kgoba/zinoo/eagle/relay_shield/bom.txt

1629032	6	RY211005R	SPDT Relay 5V
1564671	1	LP2985IM5-5.0/NOPB LDO 5V/150mA
1703369	1	NCP5501DT50G 	LDO 5V/500mA
9227911	4	C1206C225K4RACTU 	2.2uF 16V
1081192	4	BAT54C		Double diode (ACA)
1332086	1	MCP23008-E/SO	I/O Expander, 8 bit
2769437	1	ULN2003ADRG3		Transistor array
2527545	1	CTBP3051/2		Terminal block 2W
2527546	6	CTBP3051/3		Terminal block 3W
