kgoba/zinoo/eagle/tracker/production/tracker-25mm-full.ods

Stock | Qty | Value | Description | Farnell ON | TME ON | Arrow | Multiplicity | Qty to order | Price | Amount | Farnell ON | TME ON
100 | 1 | BATT_PYRO | 2 pin male header |  |  |  | 1 | 0 |  | 0
100 | 1 | BATT | 2 pin male header |  |  |  | 1 | 0 |  | 0
 | 1 | UART | 3 pin male header |  | ZL265-3SG (https://www.tme.eu/en/details/zl265-3sg/pin-headers/connfly/ds1026-01-1_3s8bv/) |  | 10 | 10 | 0.06198 | 0.6198 |  | ZL265-3SG (https://www.tme.eu/en/details/zl265-3sg/pin-headers/connfly/ds1026-01-1_3s8bv/)
 | 1 | PROG | 4 pin male header |  | ZL265-4SG (https://www.tme.eu/en/details/zl265-4sg/pin-headers/connfly/ds1026-01-1_4s8bv/) |  | 10 | 10 | 0.08224 | 0.8224 |  | ZL265-4SG (https://www.tme.eu/en/details/zl265-4sg/pin-headers/connfly/ds1026-01-1_4s8bv/)
 | 1 | F/TMB | BUZZER Source: Buerklin |  | LD-BZEG-1203 (https://www.tme.eu/en/details/ld-bzeg-1203/electromagnetic-sounders-with-generator/loudity/) |  | 3 | 3 | 0.4781 | 1.4343 |  | LD-BZEG-1203 (https://www.tme.eu/en/details/ld-bzeg-1203/electromagnetic-sounders-with-generator/loudity/)
30 | 2 |  | Ferrite Bead 0805 | 1838838 (http://lv.farnell.com/fair-rite/2508056017y2/ferrite-bead-0-1ohm-2a-0805/dp/1838838) |  | 2508056017Y2 (https://www.arrow.com/en/products/2508056017y2/fair-rite-products) | 1 | 0 | 0.0571 | 0 | 1838838 (http://lv.farnell.com/fair-rite/2508056017y2/ferrite-bead-0-1ohm-2a-0805/dp/1838838)
 | 4 | PMV30UN2 | Generic N-MOSFET | 2469652 (http://lv.farnell.com/nexperia/pmv30un2/mosfet-n-ch-20v-5-4a-sot-23-3/dp/2469652?st=pmv30un2) |  | IRLML6244TRPBF (https://www.arrow.com/en/products/irlml6244trpbf/infineon-technologies-ag) | 5 | 5 | 0.194 | 0.97 | 2469652 (http://lv.farnell.com/nexperia/pmv30un2/mosfet-n-ch-20v-5-4a-sot-23-3/dp/2469652?st=pmv30un2)
100 | 13 | 100k | Generic resistor |  |  |  | 1 | 0 |  | 0
100 | 7 | 1k | Generic resistor |  |  |  | 1 | 0 |  | 0
100 | 3 | 27 | Generic resistor |  |  |  | 1 | 0 |  | 0
100 | 2 | 10k | Generic resistor |  |  |  | 1 | 0 |  | 0
100 | 1 | 3.3k | Generic resistor |  |  |  | 1 | 0 |  | 0
100 | 1 | *2.0k | Generic resistor |  |  |  | 1 | 0 |  | 0
 | 1 | MPL3115A2 | I2C precision pressure sensor with altimetry, 20 to 110kPa | 2009084 (http://lv.farnell.com/nxp/mpl3115a2/pressure-sensor-20-110kpa-8lga/dp/2009084?st=mpl3115) |  | MPL3115A2 (https://www.arrow.com/en/products/mpl3115a2/nxp-semiconductors) | 1 | 1 | 2.66 | 2.66 | 2009084 (http://lv.farnell.com/nxp/mpl3115a2/pressure-sensor-20-110kpa-8lga/dp/2009084?st=mpl3115)
 | 1 | LSM6DS33 | iNEMO inertial module: | 2762756 (http://lv.farnell.com/stmicroelectronics/lsm6ds33tr/mems-module-3-axis-gyro-accel/dp/2762756?st=lsm6ds) |  | LSM6DS33TR (https://www.arrow.com/en/products/lsm6ds33tr/stmicroelectronics) | 1 | 1 | 2.8 | 2.8 | 2762756 (http://lv.farnell.com/stmicroelectronics/lsm6ds33tr/mems-module-3-axis-gyro-accel/dp/2762756?st=lsm6ds)
100 | 1 | YELLOW | LEDs |  |  |  | 1 | 0 |  | 0
100 | 1 | RED | LEDs |  |  |  | 1 | 0 |  | 0
100 | 1 | GREEN | LEDs |  |  |  | 1 | 0 |  | 0
 | 1 | MIC5504-3.3/LP3985IM5-3.3 | Linear voltage regulator with enable pin and a bypass capacitor pin: | 2782545 (http://lv.farnell.com/texas-instruments/lp3985im5x-3-3-nopb/ldo-fixed-3-3v-0-15a-sot-23-5/dp/2782545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) |  | LP3985IM5-3.3 (https://www.arrow.com/en/products/lp3985im5-3.3/texas-instruments) | 1 | 1 | 0.473 | 0.473 | 2782545 (http://lv.farnell.com/texas-instruments/lp3985im5x-3-3-nopb/ldo-fixed-3-3v-0-15a-sot-23-5/dp/2782545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)
 | 1 | MIC5504-2.8/LP3985IM5-2.7 | Linear voltage regulator with enable pin and a bypass capacitor pin: | 2510373 (http://lv.farnell.com/microchip/mic5504-2-8ym5-tr/ldo-volt-reg-0-3a-2-8v-sot-23/dp/2510373?st=mic5504-2) |  | MIC5504-2.8YM5-TR (https://www.arrow.com/en/products/mic5504-2.8ym5-tr/microchip-technology) | 1 | 1 | 0.102 | 0.102 | 2510373 (http://lv.farnell.com/microchip/mic5504-2-8ym5-tr/ldo-volt-reg-0-3a-2-8v-sot-23/dp/2510373?st=mic5504-2)
 | 1 | A25L010A | Low Voltage, Serial Flash Memory | 2774949 (http://lv.farnell.com/microchip/sst26vf016b-104i-sn/serial-flash-16mbit-104mhz-soic/dp/2774949) |  | SST26VF016B-104I/SN (https://www.arrow.com/en/products/sst26vf016b-104isn/microchip-technology) | 1 | 1 | 1.18 | 1.18 | 2774949 (http://lv.farnell.com/microchip/sst26vf016b-104i-sn/serial-flash-16mbit-104mhz-soic/dp/2774949)
 | 1 | MAG3110FCR1 | MAGNETOMETER, 3AXIS, I2C, 80HZ,DFN-10 | 2080492 (http://lv.farnell.com/nxp/mag3110fcr1/magnetometer-3axis-i2c-80hz/dp/2080492?st=mag3110) |  | MAG3110FCR1 (https://www.arrow.com/en/products/mag3110fcr1/nxp-semiconductors) | 1 | 1 | 0.81 | 0.81 | 2080492 (http://lv.farnell.com/nxp/mag3110fcr1/magnetometer-3axis-i2c-80hz/dp/2080492?st=mag3110)
 | 1 | H3LIS100DL | MEMS motion sensor: low-power high-g 3-axis digital accelerometer | 2532374 (http://lv.farnell.com/stmicroelectronics/h3lis200dltr/accelerometer-digital-o-p-tflga/dp/2532374?st=h3lis) |  | H3LIS100DLTR (https://www.arrow.com/en/products/h3lis100dltr/stmicroelectronics) | 1 | 1 | 5.06 | 5.06 | 2532374 (http://lv.farnell.com/stmicroelectronics/h3lis200dltr/accelerometer-digital-o-p-tflga/dp/2532374?st=h3lis)
 | 1 | MICROMATCH-8 | MicroMatch 8 THT receptacle top (215079-8) | 1773005 * (http://lv.farnell.com/amp-te-connectivity/215079-8/connector-8way-vertical-1-27/dp/1773005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) | DS1015-04-08R6XT (https://www.tme.eu/en/details/ds1015-04-08r6xt/micro-match-connectors-127mm/connfly/) |  | 10 | 10 | 0.276 | 2.76 | 1773005 (http://lv.farnell.com/amp-te-connectivity/215079-8/connector-8way-vertical-1-27/dp/1773005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) | DS1015-04-08R6XT (https://www.tme.eu/en/details/ds1015-04-08r6xt/micro-match-connectors-127mm/connfly/)
 | 1 | MICROMATCH-8 | MicroMatch 8 IDC wire plug (215083-8) | 1773002 * (http://lv.farnell.com/amp-te-connectivity/215083-8/connector-8way-awg28-1-27/dp/1773002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) | DS1015-01-08R6 (https://www.tme.eu/en/details/ds1015-01-08r6/micro-match-connectors-127mm/connfly/) |  | 1 | 1 | 0.38 | 0.38 | 1773002 (http://lv.farnell.com/amp-te-connectivity/215083-8/connector-8way-awg28-1-27/dp/1773002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) | DS1015-01-08R6 (https://www.tme.eu/en/details/ds1015-01-08r6/micro-match-connectors-127mm/connfly/)
 | 1 | MICROMATCH-8 | MicroMatch 8 IDC paddle board (215570-8) | 149366 * (http://lv.farnell.com/amp-te-connectivity/7-215570-8/connector-paddle-board-8way/dp/149366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) | DS1015-02-08R6 (https://www.tme.eu/en/details/ds1015-02-08r6/micro-match-connectors-127mm/connfly/) |  | 1 | 1 | 0.61 | 0.61 | 149366 (http://lv.farnell.com/amp-te-connectivity/7-215570-8/connector-paddle-board-8way/dp/149366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) | DS1015-02-08R6 (https://www.tme.eu/en/details/ds1015-02-08r6/micro-match-connectors-127mm/connfly/)
 | 0 | MICROMATCH-8 | MicroMatch 8 THT receptacle side (215460-8) | 148751 * (http://lv.farnell.com/amp-te-connectivity/7-215460-8/socket-side-entry-8way/dp/148751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) | DS1015-05-08R6B (https://www.tme.eu/en/details/ds1015-05-08r6b/micro-match-connectors-127mm/connfly/) |  | 1 | 0 | 1.15 | 0 | 148751 (http://lv.farnell.com/amp-te-connectivity/7-215460-8/socket-side-entry-8way/dp/148751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) | DS1015-05-08R6B (https://www.tme.eu/en/details/ds1015-05-08r6b/micro-match-connectors-127mm/connfly/)
 | 0 | MICROMATCH-8 | MicroMatch 8 THT plug top (215464-8) | 3784642 * (http://lv.farnell.com/amp-te-connectivity/7-215464-8/plug-pcb-8way/dp/3784642?st=micromatch%208%20board) | AMP-7-215464-8 (https://www.tme.eu/en/details/amp-7-215464-8/micro-match-connectors-127mm/te-connectivity/7-215464-8/) |  | 1 | 0 | 0.76 | 0 | 3784642 (http://lv.farnell.com/amp-te-connectivity/7-215464-8/plug-pcb-8way/dp/3784642?st=micromatch%208%20board) | AMP-7-215464-8 (https://www.tme.eu/en/details/amp-7-215464-8/micro-match-connectors-127mm/te-connectivity/7-215464-8/)
 | 1 | MCP73831T-2ACI/OT | Miniature Single-Cell, Fully Integrated Li-Ion, Li-Polymer Charge Management Controllers | 1332158 (http://lv.farnell.com/microchip/mcp73831t-2aci-ot/li-ion-li-poly-charge-controller/dp/1332158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) |  | MCP73832T-2ACI/OT (https://www.arrow.com/en/products/mcp73832t-2aciot/microchip-technology) | 1 | 1 | 0.52 | 0.52 | 1332158 (http://lv.farnell.com/microchip/mcp73831t-2aci-ot/li-ion-li-poly-charge-controller/dp/1332158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)
 | 2 | COAX | MMCX STRAIGHT, EDGE MOUNT JACK- 50 OHM |  | RF1205AT0050GT/R (https://www.tme.eu/en/details/rf1205at0050gt_r/mcx-mmcx-connectors/adam-tech/rf12-05a-t-00-50-g/) |  | 1 | 2 | 0.68 | 1.36 |  | RF1205AT0050GT/R (https://www.tme.eu/en/details/rf1205at0050gt_r/mcx-mmcx-connectors/adam-tech/rf12-05a-t-00-50-g/)
 | 2 |  | Plug; MMCX; male; straight; 50Ω; RG174,RG188,RG316; for cable |  | RF12-06-T-02-50-G (https://www.tme.eu/en/details/rf12-06-t-02-50-g/mcx-mmcx-connectors/adam-tech/) |  | 1 | 2 | 0.87 | 1.74 |  | RF12-06-T-02-50-G (https://www.tme.eu/en/details/rf12-06-t-02-50-g/mcx-mmcx-connectors/adam-tech/)
 | 12 | 0.1 µF, 10 V, X7R, 0603 | Non-Polarized capacitor in various packages | 2821272 (http://lv.farnell.com/kemet/c0603c104m8ractu/cap-mlcc-x7r-0-1uf-10v-0603/dp/2821272?st=kemet%201u) |  |  | 10 | 20 | 0.0252 | 0.504 | 2821272 (http://lv.farnell.com/kemet/c0603c104m8ractu/cap-mlcc-x7r-0-1uf-10v-0603/dp/2821272?st=kemet%201u)
 | 6 | 1 µF, 10 V, X7R, 0603 | Non-Polarized capacitor in various packages | 2522396 (http://lv.farnell.com/kemet/c0603c105k8ractu/cap-mlcc-x7r-1uf-10v-0603/dp/2522396?st=kemet%201u) |  |  | 10 | 10 | 0.093 | 0.93 | 2522396 (http://lv.farnell.com/kemet/c0603c105k8ractu/cap-mlcc-x7r-1uf-10v-0603/dp/2522396?st=kemet%201u)
100 | 1 | 10n | Non-Polarized capacitor in various packages |  |  |  | 1 | 0 |  | 0
 | 1 | 10 µF, 6.3 V, X7R, 1206 | Polarized capacitor in various packages | 2522501 (http://lv.farnell.com/kemet/c1206c106k9ractu/cap-mlcc-x7r-10uf-6-3v-1206/dp/2522501?st=kemet%2010uf) |  |  | 5 | 5 | 0.37 | 1.85 | 2522501 (http://lv.farnell.com/kemet/c1206c106k9ractu/cap-mlcc-x7r-10uf-6-3v-1206/dp/2522501?st=kemet%2010uf)
100 | 4 | 3.3k | RESISTOR, European symbol |  |  |  | 1 | 0 |  | 0
 | 1 | HOPE-RFM98W | RFM95/96/97/98(W) - Low Power Long Range Transceiver Module |  | RFM98W-433S2 (https://www.tme.eu/en/details/rfm98w-433s2/rf-communication-modules/hope-microelectronics/) |  | 1 | 1 | 8.86 | 8.86 |  | RFM98W-433S2 (https://www.tme.eu/en/details/rfm98w-433s2/rf-communication-modules/hope-microelectronics/)
10 | 1 | UBLOX-NEO-M8 | U-blox NEO-6 GPS receiver |  |  |  | 1 | 0 |  | 0
 | 0 | UBLOX-MAX-M8 | U-blox NEO-6 GPS receiver |  |  |  | 1 | 0 |  | 0
 | 1 | WM9734TR-ND | USB Type Micro-B Connector | 2614949 (http://lv.farnell.com/molex/105133-0011/micro-usb-2-0-type-b-receptacle/dp/2614949?st=usb%20micro) |  |  | 1 | 1 | 0.6 | 0.6 | 2614949 (http://lv.farnell.com/molex/105133-0011/micro-usb-2-0-type-b-receptacle/dp/2614949?st=usb%20micro)
 | 1 | STM32L063C | STM32 microcontroller | 2503296 (http://lv.farnell.com/stmicroelectronics/stm32l053c8t6tr/mcu-32bit-cortex-m0-32mhz-lqfp/dp/2503296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) |  | STM32L053C8T6 (https://www.arrow.com/en/products/stm32l053c8t6/stmicroelectronics) | 1 | 1 | 2.26 | 2.26 | 2503296 (http://lv.farnell.com/stmicroelectronics/stm32l053c8t6tr/mcu-32bit-cortex-m0-32mhz-lqfp/dp/2503296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)
 |  |  |  |  |  |  |  |  |  | 39.3055
