kgoba/zinoo/eagle/tracker/tracker-25mm-full.dxf

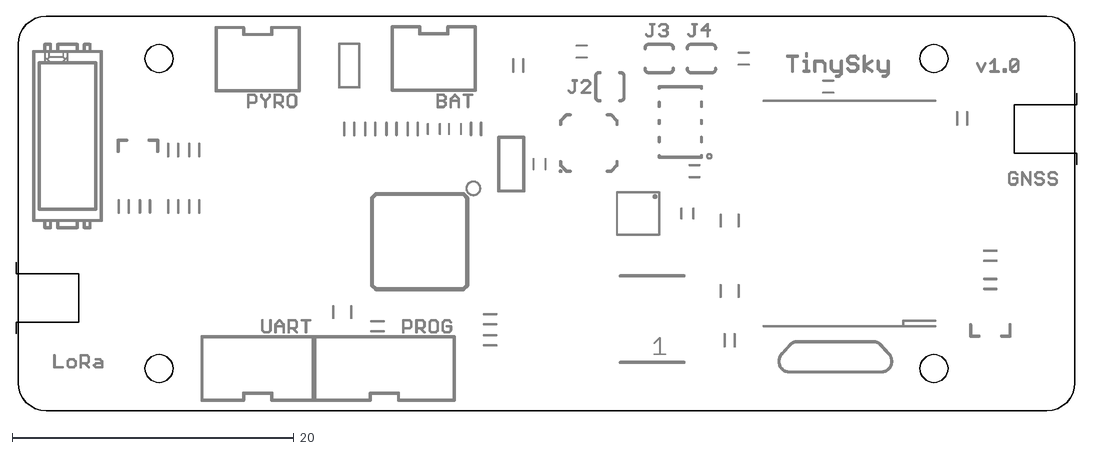
[picture p1: CAD file, 2018-03-26]
eagle/tracker/tracker-25mm-full.dxf
75.2 x 28.0
