kgoba/zinoo/eagle/relay_shield/mosfet-shield-v2.brd

## EAGLE design eagle/relay_shield/mosfet-shield-v2.brd (2018-09-06)

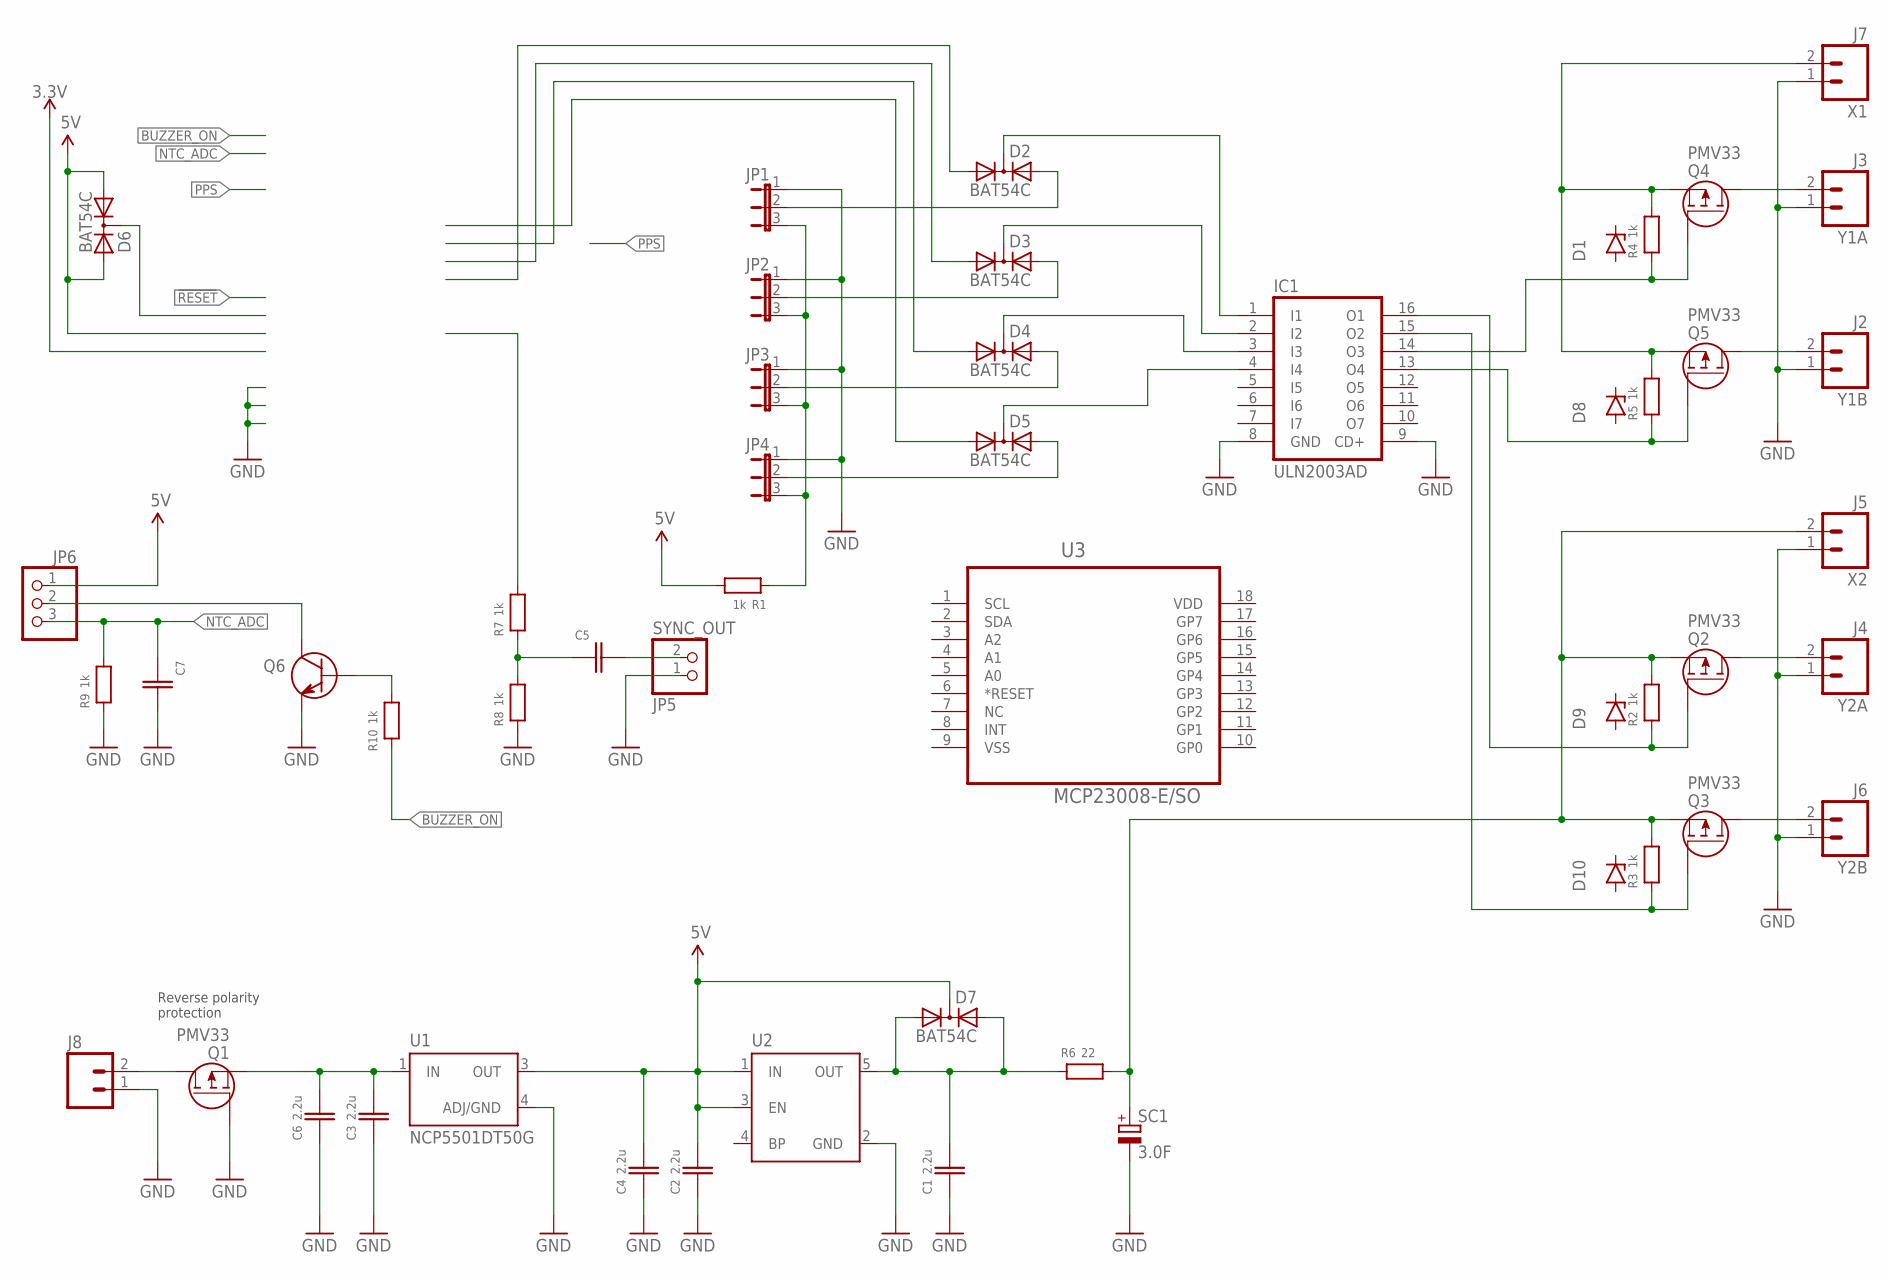
[picture p2: schematic mosfet-shield-v2.sch]

Parts:
C1, C2, C3, C4, C6: 2.2u; C1206
C5, C7: CAPACITOR_NPOL-0603; C603
D1, D8, D9, D10: DIODE-ZENER-SOD80; SOD80
D2, D3, D4, D5, D6, D7: BAT54C; SOT23
IC1: ULN2003AD; SO16
J2: Y1B; SCREWTERMINAL-3.5MM-2
J3: Y1A; SCREWTERMINAL-3.5MM-2
J4: Y2A; SCREWTERMINAL-3.5MM-2
J5: X2; SCREWTERMINAL-3.5MM-2
J6: Y2B; SCREWTERMINAL-3.5MM-2
J7: X1; SCREWTERMINAL-3.5MM-2
J8: M023.5MM; SCREWTERMINAL-3.5MM-2
JP1, JP2, JP3, JP4: JP2E; JP2
JP5: SYNC_OUT; 1X02
JP6: PINHD-1X3; 1X03
Q1, Q2, Q3, Q4, Q5: PMV33; SOT23-3
Q6: BJT-NPN-SOT23-3; SOT23-3
R1, R2, R3, R4, R5, R7, R8, R9, R10: 1k; R0603
R6: 22; R0603
SC1: 3.0F; E3,5-8
U1: NCP5501DT50G; DPAK
U2: VREG-5PIN-SOT23; SOT23-5
U3: MCP23008-E/SO; SOIC127P1030X265-18N

Connections:
5V: C2.2, C4.2, D6.1 (A1), D6.2 (A2), D7.3 (C), JP6.1, R1.2, U1.3 (OUT), U2.1 (IN), U2.3 (EN)
BUZZER_ON: R10.1
GND: C1.1, C2.1, C3.1, C4.1, C6.1, C7.2, IC1.8 (GND), IC1.9 (CD+), J2.1, J3.1, J4.1, J5.1, J6.1, J7.1, J8.1, JP1.1, JP2.1, JP3.1, JP4.1, JP5.1, Q1.1 (G), Q6.2 (E), R8.1, R9.1, SC1.-, U1.4 (ADJ/GND), U2.2 (GND)
unnamed: D2.2 (A2), JP1.2
unnamed: D3.2 (A2), JP2.2
unnamed: J3.2, Q4.3 (D)
unnamed: C3.2, C6.2, Q1.2 (S), U1.1 (IN)
unnamed: IC1.15 (O2), Q3.1 (G), R3.1
unnamed: IC1.16 (O1), Q2.1 (G), R2.1
unnamed: J7.2, Q4.2 (S), Q5.2 (S), R4.2, R5.2
unnamed: J2.2, Q5.3 (D)
unnamed: J4.2, Q2.3 (D)
unnamed: J5.2, Q2.2 (S), Q3.2 (S), R2.2, R3.2, R6.2, SC1.+
unnamed: J6.2, Q3.3 (D)
unnamed: IC1.14 (O3), Q4.1 (G), R4.1
unnamed: IC1.13 (O4), Q5.1 (G), R5.1
unnamed: C1.2, D7.1 (A1), D7.2 (A2), R6.1, U2.5 (OUT)
unnamed: C5.2, JP5.2
unnamed: D2.3 (C), IC1.1 (I1)
unnamed: D3.3 (C), IC1.2 (I2)
unnamed: D4.3 (C), IC1.3 (I3)
unnamed: D5.3 (C), IC1.4 (I4)
unnamed: C5.1, R7.1, R8.2
unnamed: D4.2 (A2), JP3.2
unnamed: D5.2 (A2), JP4.2
unnamed: JP6.2, Q6.3 (C)
unnamed: J8.2, Q1.3 (D)
unnamed: Q6.1 (B), R10.2
unnamed: JP1.3, JP2.3, JP3.3, JP4.3, R1.1
NTC_ADC: C7.1, JP6.3, R9.2
VDD: U3.18 (VDD)

Notes on the sheet:
Reverse polarity protection

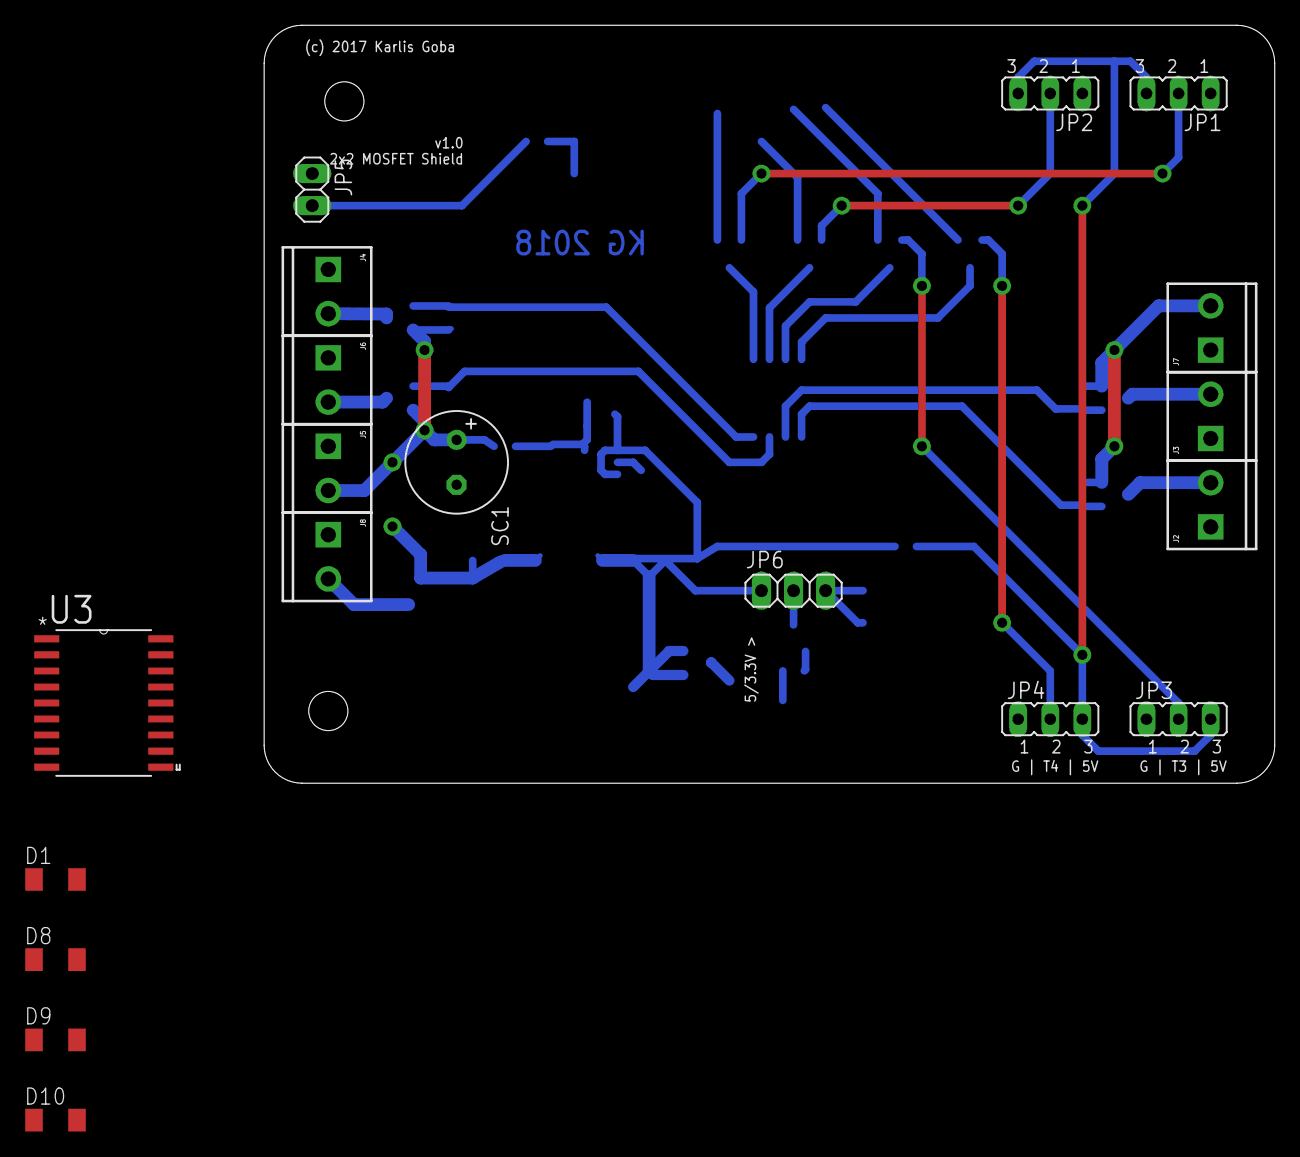
[picture p3: board mosfet-shield-v2.brd from above]

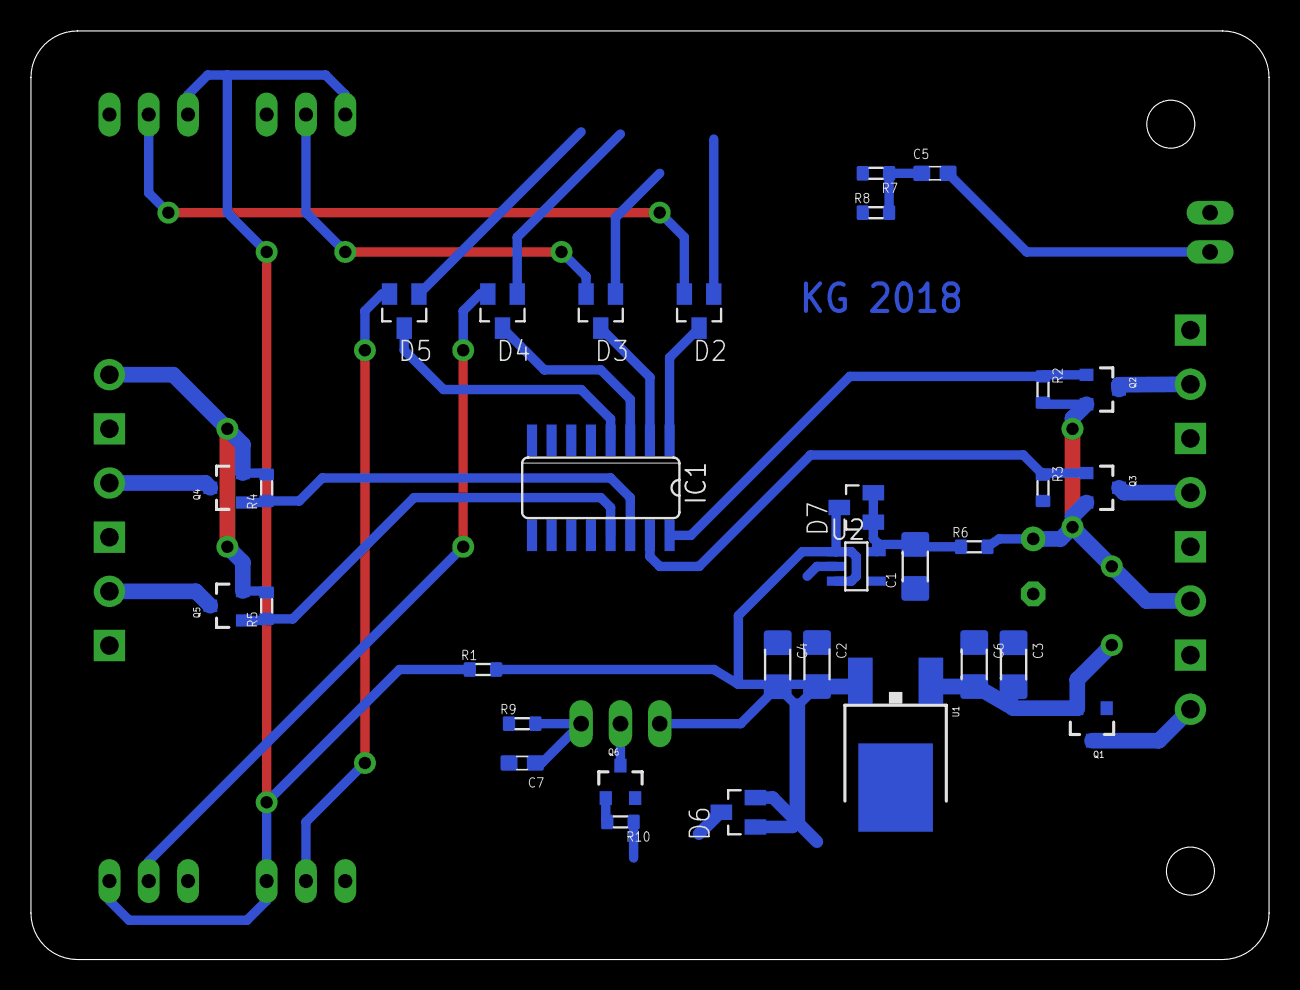
[picture p4: board mosfet-shield-v2.brd from below]

Board: 2 copper layers, 80.0 x 60.0 mm, 51 parts (32 on the bottom side), 29 nets.
