kgoba/zinoo/eagle/misc/thermostat-2layer-v1.brd

## EAGLE design eagle/misc/thermostat-2layer-v1.brd (2018-04-24)

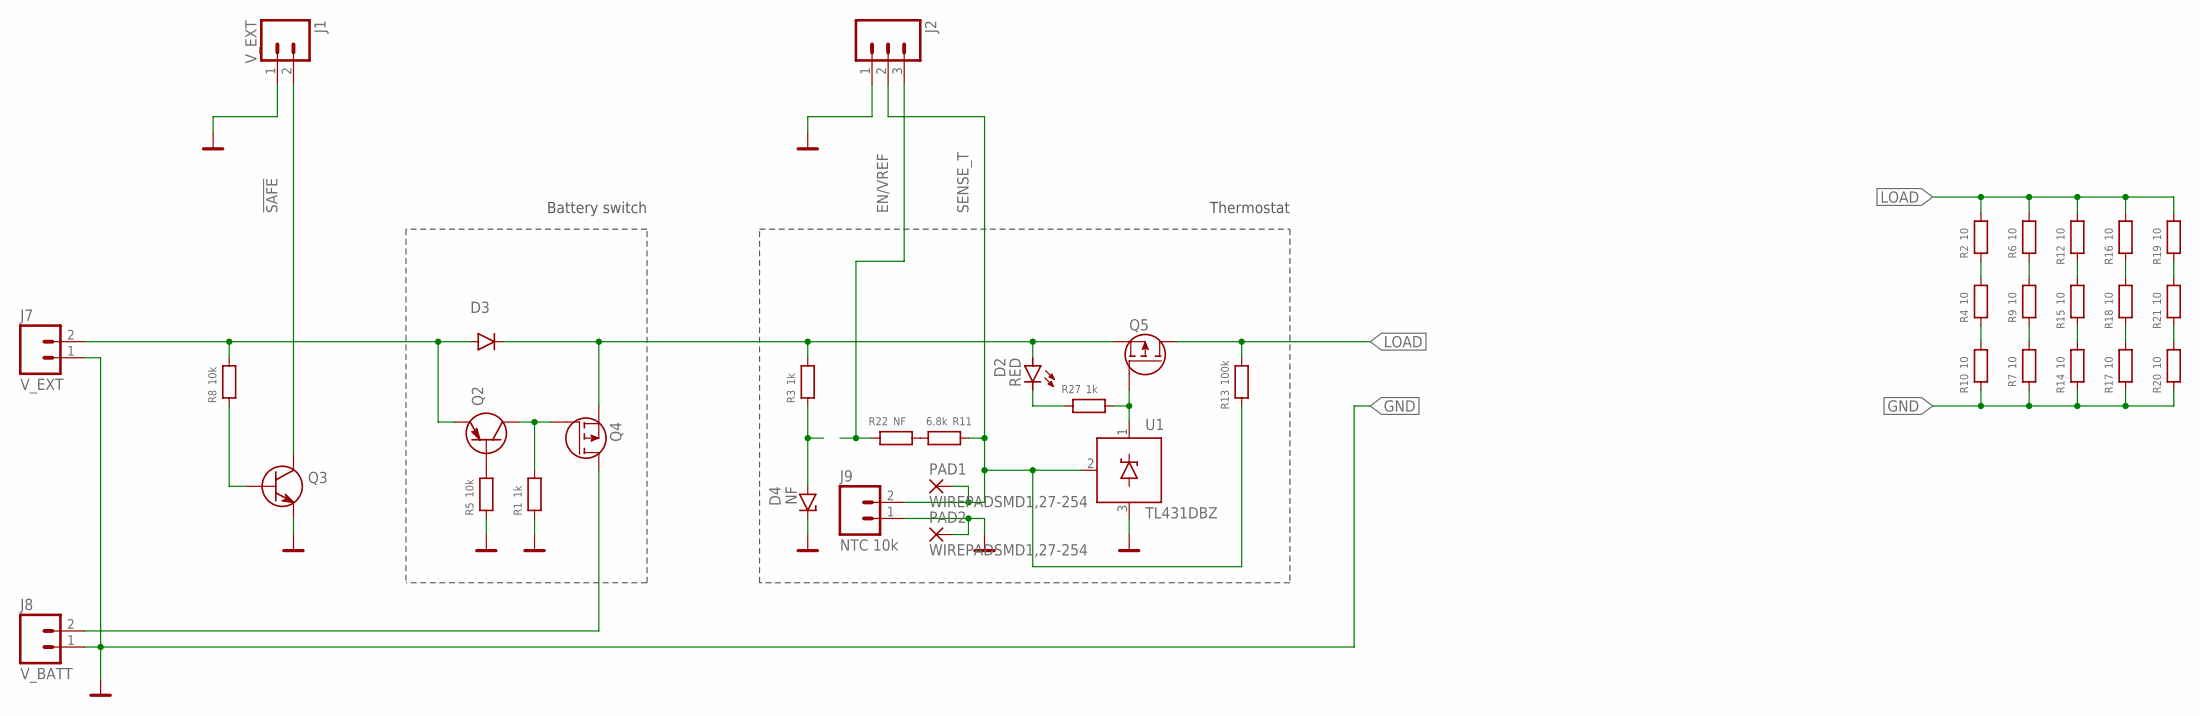
[picture p5: schematic thermostat-2layer-v1.sch]

Parts:
D2: RED; R0805
D3: DIODE-SMA-ALT; D-SMA-ALT
D4: NF; SOD80
J1, J7: V_EXT; JST-2-PTH-VERT
J2: M3-CT-V; JST-3-PTH-VERT
J8: V_BATT; JST-2-PTH-VERT
J9: NTC 10k; JST-2-PTH-VERT
PAD1, PAD2: WIREPADSMD1,27-254; SMD1,27-2,54
Q2: BJT-PNPSMD; SOT23-3
Q3: BJT-NPN-SOT23-3; SOT23-3
Q4, Q5: MOSFET-P-SOT23-3; SOT23-3
R1, R3, R27: 1k; R0603
R2, R4, R6, R7, R9, R10, R12, R14, R15, R16, R17, R18, R19, R20, R21: 10; R1206
R5, R8: 10k; R0603
R11: 6.8k; R0603
R13: 100k; R0603
R22: NF; R0603
U1: TL431DBZ; SOT23-3

Connections:
!SAFE: J1.2, Q3.3 (C)
EN/VREF: J2.3, R22.1
GND: D4.C, J1.1, J2.1, J7.1, J8.1, J9.1, PAD2.1, Q3.2 (E), R1.1, R5.1, R7.1, R10.1, R14.1, R17.1, R20.1, U1.3 (A)
LOAD: Q5.3 (D), R2.2, R6.2, R12.2, R13.2, R16.2, R19.2
unnamed: D2.2 (C), R27.1
unnamed: D4.A, R3.1
unnamed: R2.1, R4.2
unnamed: R4.1, R10.2
unnamed: D2.1 (A), D3.C, Q4.2 (S), Q5.2 (S), R3.2
unnamed: Q2.3 (C), Q4.1 (G), R1.2
unnamed: J8.2, Q4.3 (D)
unnamed: Q2.1 (B), R5.2
unnamed: D3.A, J7.2, Q2.2 (E), R8.2
unnamed: R6.1, R9.2
unnamed: R7.2, R9.1
unnamed: Q3.1 (B), R8.1
unnamed: R12.1, R15.2
unnamed: Q5.1 (G), R27.2, U1.1 (C)
unnamed: R14.2, R15.1
unnamed: R16.1, R18.2
unnamed: R17.2, R18.1
unnamed: R19.1, R21.2
unnamed: R20.2, R21.1
unnamed: R11.2, R22.2
SENSE_T: J2.2, J9.2, PAD1.1, R11.1, R13.1, U1.2 (R)

Notes on the sheet:
Thermostat
Battery switch

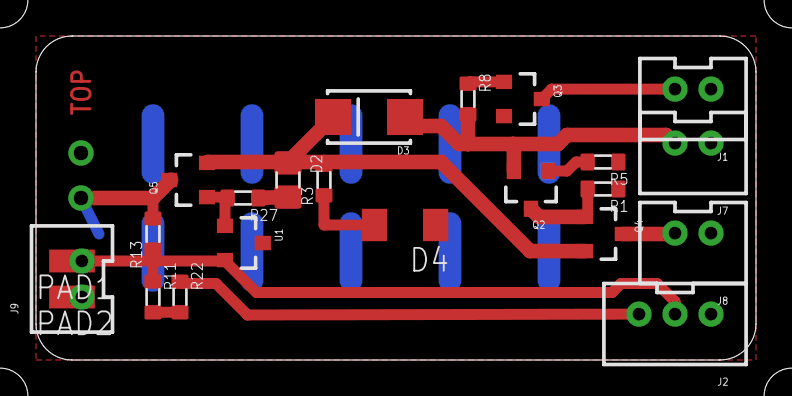
[picture p6: board thermostat-2layer-v1.brd from above]

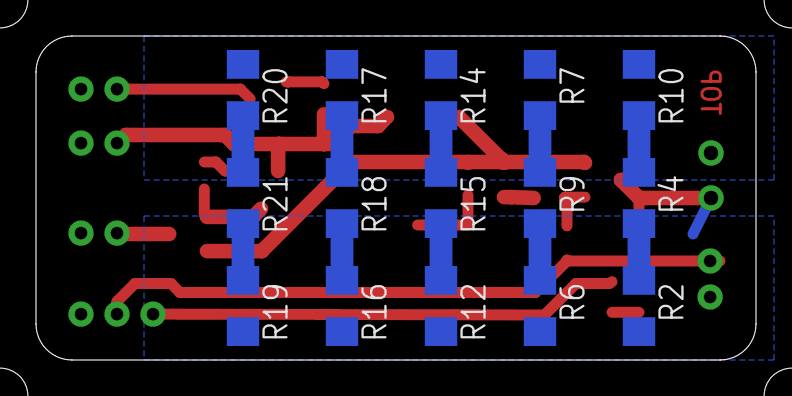
[picture p7: board thermostat-2layer-v1.brd from below]

Board: 2 copper layers, 40.0 x 18.0 mm, 38 parts (15 on the bottom side), 25 nets.
