kgoba/zinoo/eagle/misc/heater-v1.brd

## EAGLE design eagle/misc/heater-v1.brd (2018-04-22)

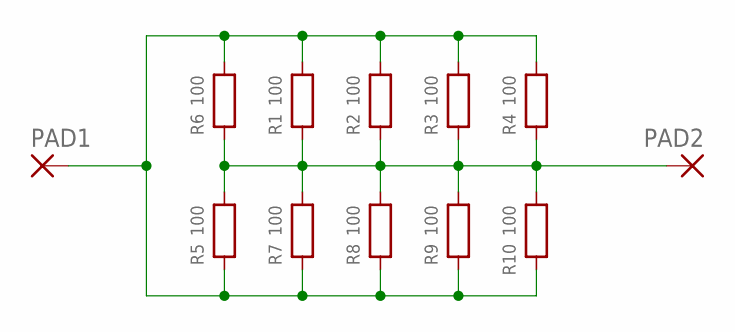
[picture p8: schematic heater-v1.sch]

Parts:
PAD1, PAD2: 1,6/0,8
R1, R2, R3, R4, R5, R6, R7, R8, R9, R10: 100; R1206

Connections:
N1: PAD1.1, R1.2, R2.2, R3.2, R4.2, R5.1, R6.2, R7.1, R8.1, R9.1, R10.1
N2: PAD2.1, R1.1, R2.1, R3.1, R4.1, R5.2, R6.1, R7.2, R8.2, R9.2, R10.2

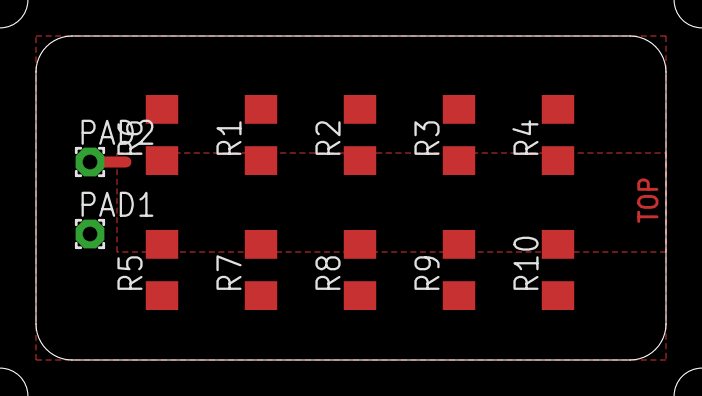
[picture p9: board heater-v1.brd from above]

Board: 2 copper layers, 35.0 x 18.0 mm, 12 parts (0 on the bottom side), 2 nets.
