kgoba/zinoo/eagle/tracker/tracker-25mm-full.brd

## EAGLE design eagle/tracker/tracker-25mm-full.brd (2018-04-21)

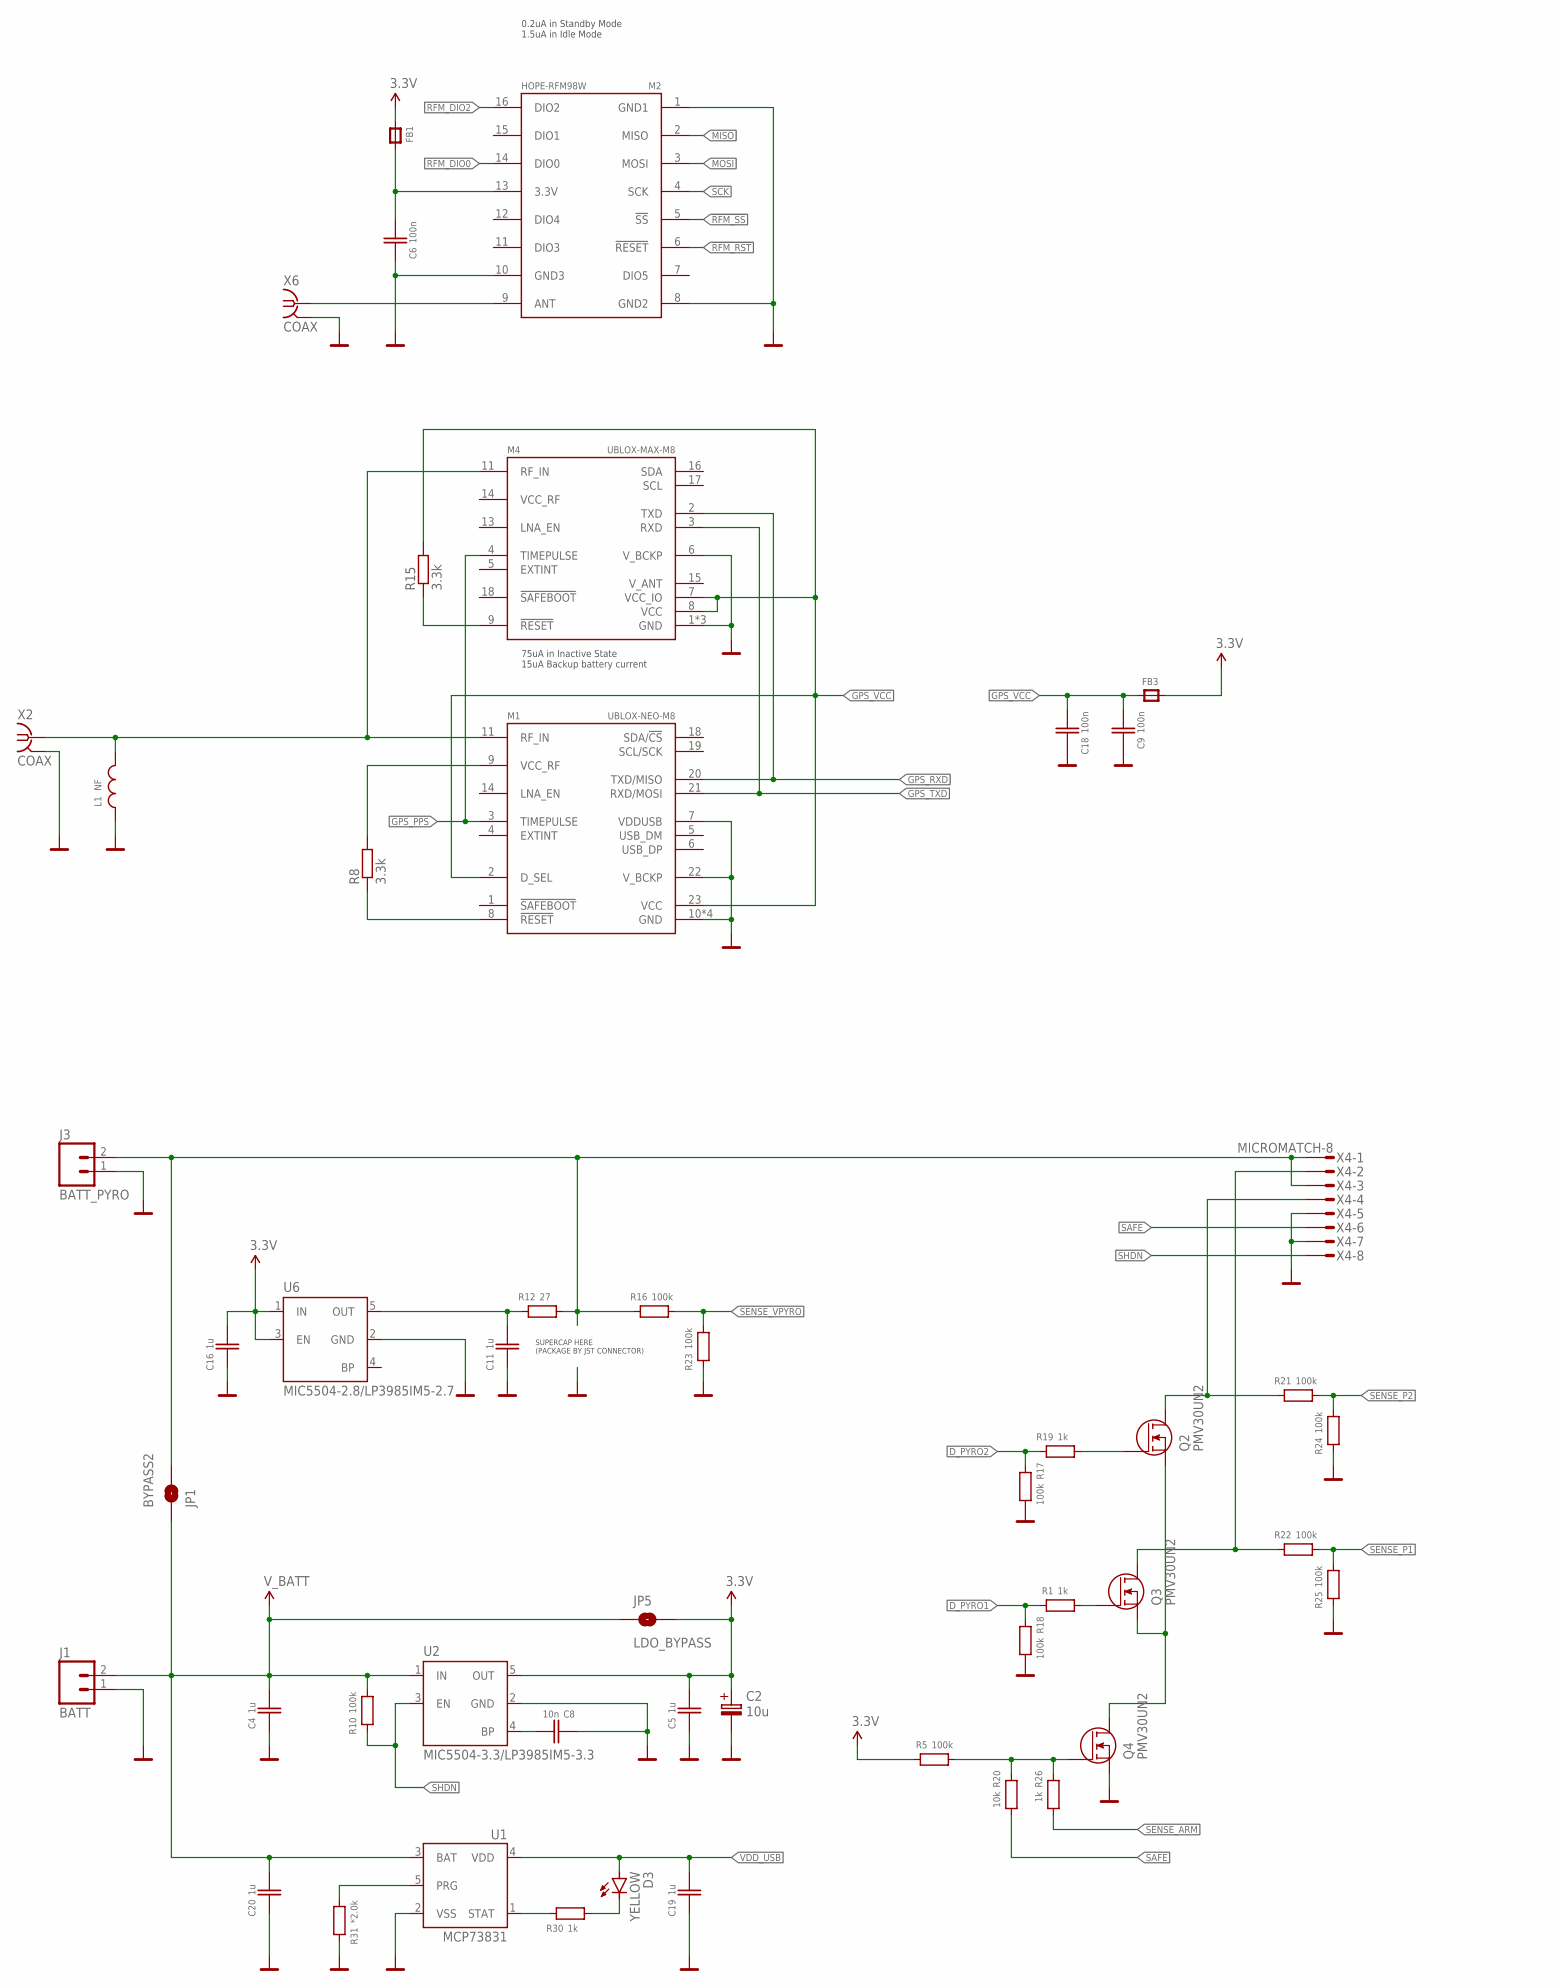
[picture p10: schematic tracker-25mm-full.sch, part in row 1, column 1]

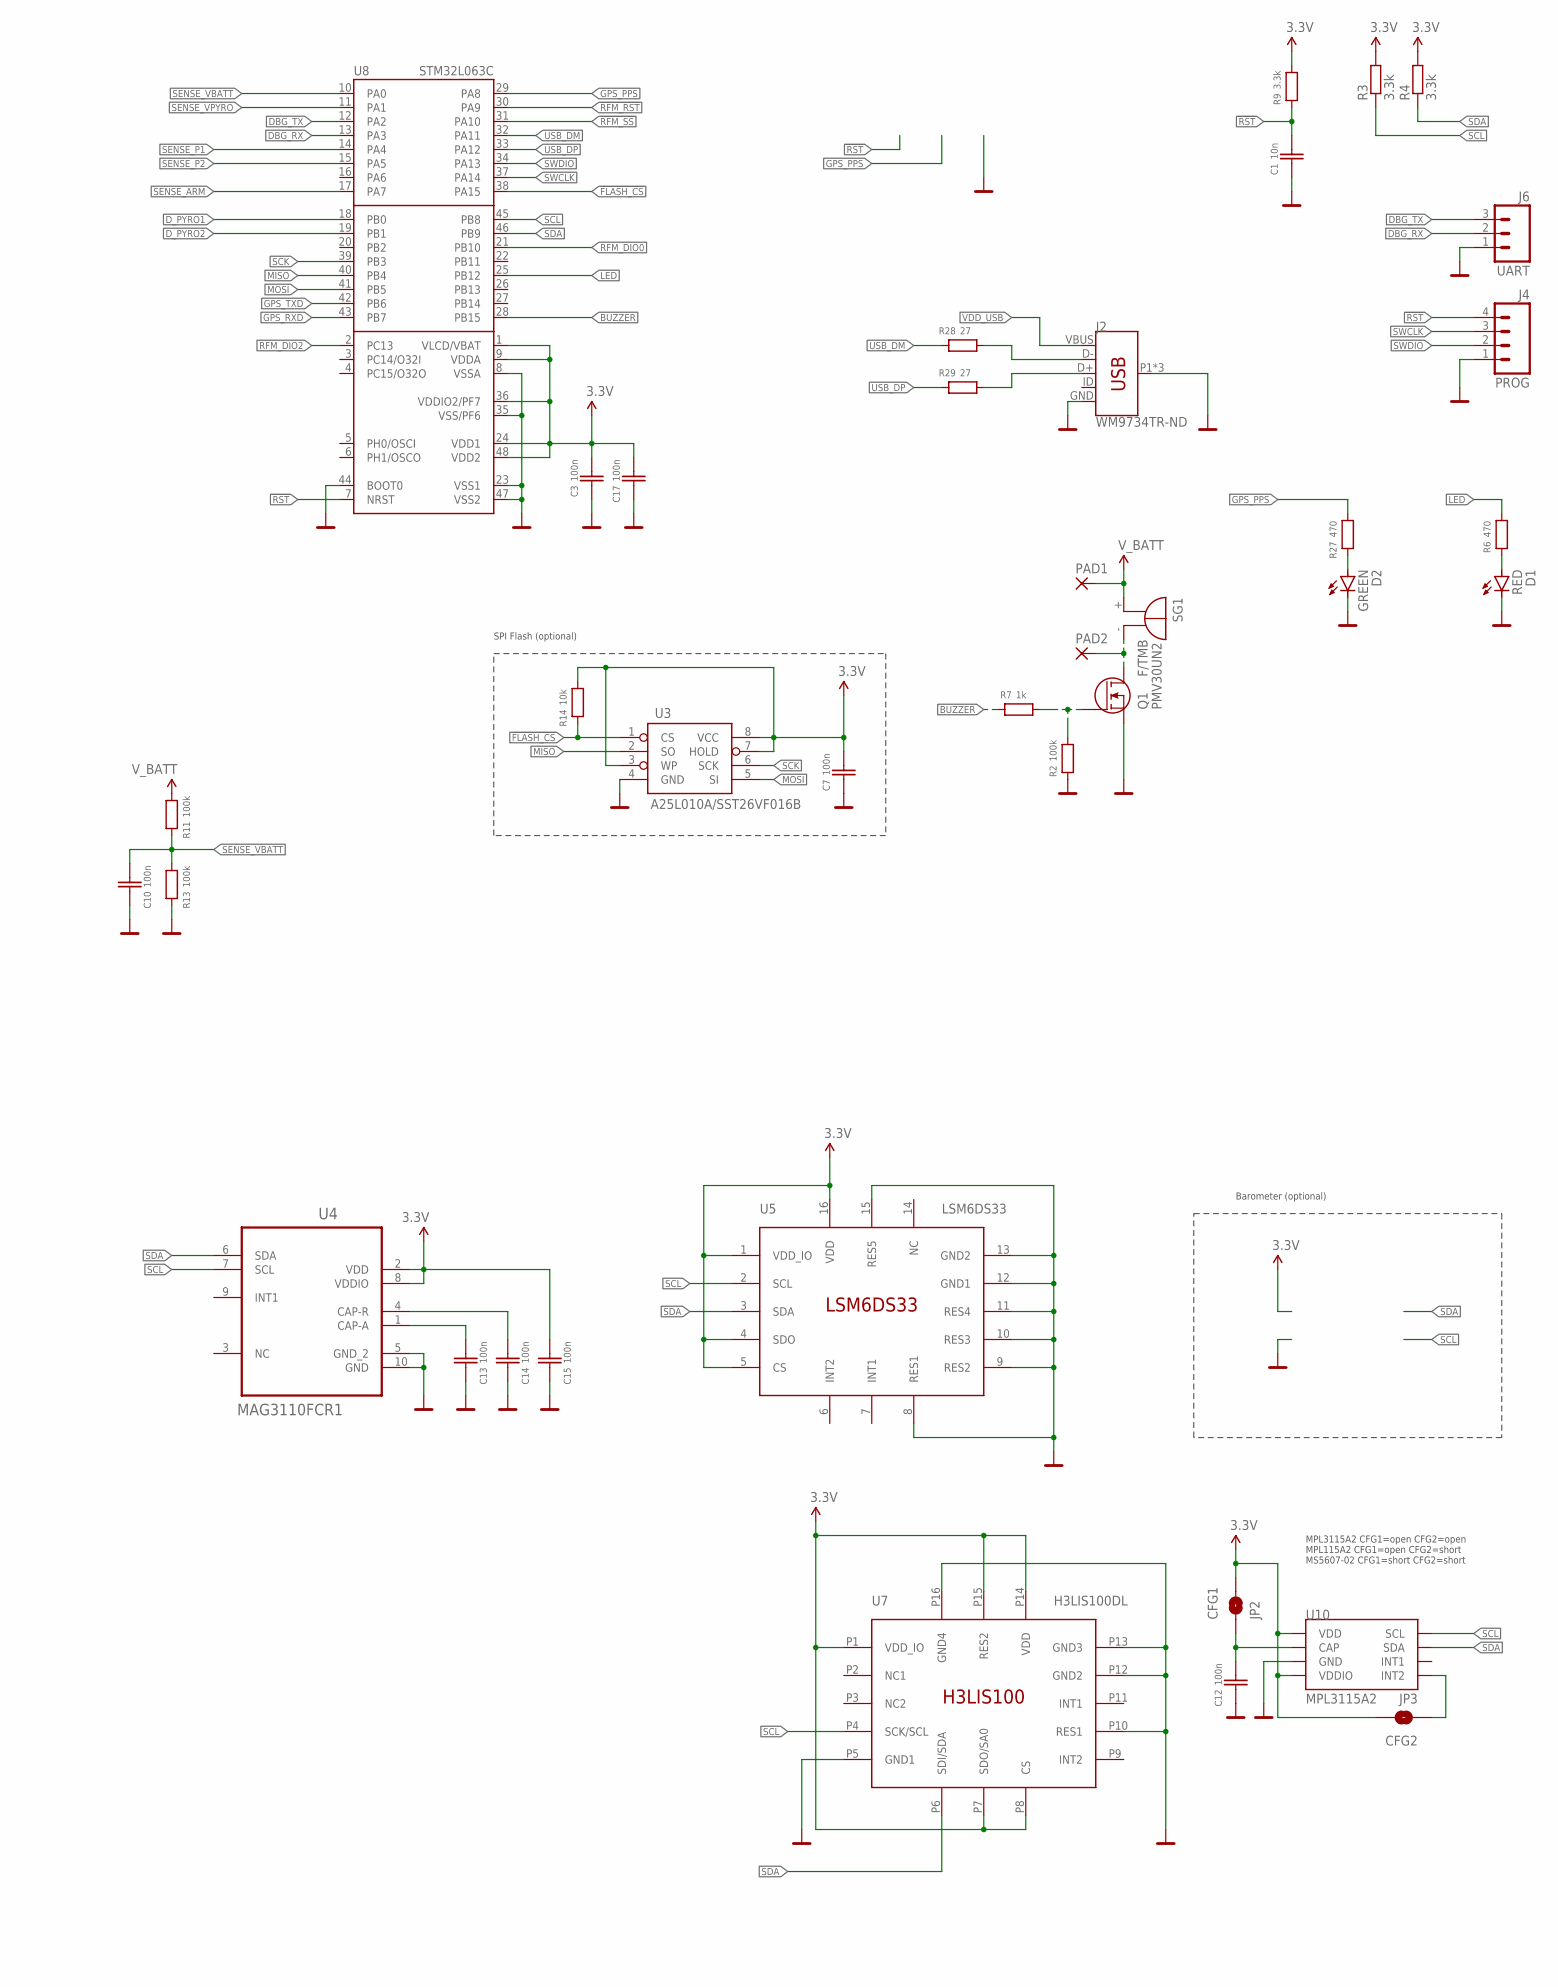
[picture p11: schematic tracker-25mm-full.sch, part in row 1, column 2]

Parts:
C1, C8: 10n; C603
C2: 10u; EIA3216
C3, C6, C7, C9, C10, C12, C13, C14, C15, C17, C18: 100n; C603
C4, C5, C11, C16, C19, C20: 1u; C603
D1: RED; R0805
D2: GREEN; R0805
D3: YELLOW; R0805
FB1, FB3: FERRITE_0805; _0805
J1: BATT; JST-2-PTH-VERT
J2: WM9734TR-ND; USB-B-MICRO-SMD_VERT
J3: BATT_PYRO; JST-2-PTH-VERT
J4: PROG; JST-4-PTH-VERT
J6: UART; JST-3-PTH-VERT
JP1: BYPASS2; PAD-JUMPER-2-NO_YES_SILK
JP2: CFG1; PAD-JUMPER-2-NO_YES_SILK
JP3: CFG2; PAD-JUMPER-2-NO_YES_SILK
JP5: LDO_BYPASS; PAD-JUMPER-2-NO_YES_SILK
L1: NF; R0603
M1: UBLOX-NEO-M8; UBLOX-NEO
M2: HOPE-RFM98W; MOD-RFM95
M4: UBLOX-MAX-M8; UBLOX-MAX
PAD1, PAD2: SMD5; SMD2,54-5,08
Q1, Q2, Q3, Q4: PMV30UN2; SOT23-3
R1, R7, R19, R26, R30: 1k; R0603
R2, R5, R10, R11, R13, R16, R17, R18, R21, R22, R23, R24, R25: 100k; R0603
R3, R4, R8, R9, R15: 3.3k; R0603
R6, R27: 470; R0603
R12, R28, R29: 27; R0603
R14, R20: 10k; R0603
R31: *2.0k; R0603
SG1: F/TMB
U1: MCP73831; SOT23-5
U2: MIC5504-3.3/LP3985IM5-3.3; SOT23-5
U3: A25L010A/SST26VF016B; SOP08
U4: MAG3110FCR1; DFN200X200X90-10N
U5: LSM6DS33; TFLGA16L
U6: MIC5504-2.8/LP3985IM5-2.7; SOT23-5
U7: H3LIS100DL; QFN16_3X5
U8: STM32L063C; LQFP48
U10: MPL3115A2; LGA8
X2, X6: COAX; MMCX-J-P-X-ST-EM1-MKT
X4: MICROMATCH-8

Connections:
3.3V: C2.A (+), C3.2, C5.2, C7.2, C15.2, C16.2, C17.2, FB1.2, FB3.1, JP2.2, JP3.2, JP5.2, R3.2, R4.2, R5.1, R9.2, R14.2, U2.5 (OUT), U3.3 (WP), U3.7 (HOLD), U3.8 (VCC), U4.2 (VDD), U4.8 (VDDIO), U5.1 (VDD_IO), U5.4 (SDO), U5.5 (CS), U5.16 (VDD), U6.1 (IN), U6.3 (EN), U7.P1 (VDD_IO), U7.P7 (SDO/SA0), U7.P8 (CS), U7.P14 (VDD), U7.P15 (RES2), U8.1 (VLCD/VBAT), U8.9 (VDDA), U8.24 (VDD1), U8.36 (VDDIO2/PF7), U8.48 (VDD2), U10.1 (VDD), U10.4 (VDDIO)
!FLASH_CS: R14.1, U3.1 (CS), U8.38 (PA15)
!GPS_RST: M4.9 (!RESET), R15.1
!RFM_RST: M2.6 (!RESET), U8.30 (PA9)
!RFM_SS: M2.5 (!SS), U8.31 (PA10)
!RST: C1.2, J4.4, R9.1, U8.7 (NRST)
BUZZER: R7.1, U8.28 (PB15)
DBG_RX: J6.2, U8.13 (PA3)
DBG_TX: J6.3, U8.12 (PA2)
D_PYRO1: R1.1, R18.1, U8.18 (PB0)
D_PYRO2: R17.1, R19.1, U8.19 (PB1)
GND: C1.1, C2.C (-), C3.1, C4.1, C5.1, C6.1, C7.1, C8.1, C9.1, C10.1, C11.1, C12.1, C13.1, C14.1, C15.1, C16.1, C17.1, C18.1, C19.1, C20.1, D1.2 (C), D2.2 (C), J1.1, J2.GND, J2.P1 (SHIELD), J2.P2 (SHIELD), J2.P3 (SHIELD), J3.1, J4.1, J6.1, L1.1, M1.7 (VDDUSB), M1.10 (GND), M1.12 (GND), M1.13 (GND), M1.22 (V_BCKP), M1.24 (GND), M2.1 (GND1), M2.8 (GND2), M2.10 (GND3), M4.1 (GND), M4.6 (V_BCKP), M4.10 (GND), M4.12 (GND), Q1.2 (S), Q4.2 (S), R2.1, R13.1, R17.2, R18.2, R23.1, R24.1, R25.1, R31.1, U1.2 (VSS), U2.2 (GND), U3.4 (GND), U4.5 (GND_2), U4.10 (GND), U5.8 (RES1), U5.9 (RES2), U5.10 (RES3), U5.11 (RES4), U5.12 (GND1), U5.13 (GND2), U5.15 (RES5), U6.2 (GND), U7.P5 (GND1), U7.P10 (RES1), U7.P12 (GND2), U7.P13 (GND3), U7.P16 (GND4), U8.8 (VSSA), U8.23 (VSS1), U8.35 (VSS/PF6), U8.44 (BOOT0), U8.47 (VSS2), U10.3 (GND), X2.2@1 (GND), X2.2@2 (GND), X2.2@3 (GND), X2.2@4 (GND), X4.5, X4.7, X6.2@1 (GND), X6.2@2 (GND), X6.2@3 (GND), X6.2@4 (GND)
GPS_PPS: M1.3 (TIMEPULSE), M4.4 (TIMEPULSE), R27.2, U8.29 (PA8)
GPS_RXD: M1.20 (TXD/MISO), M4.2 (TXD), U8.43 (PB7)
GPS_TXD: M1.21 (RXD/MOSI), M4.3 (RXD), U8.42 (PB6)
GPS_VCC: C9.2, C18.2, FB3.2, M1.2 (D_SEL), M1.23 (VCC), M4.7 (VCC_IO), M4.8 (VCC), R15.2
LED: R6.2, U8.25 (PB12)
MISO: M2.2 (MISO), U3.2 (SO), U8.40 (PB4)
MOSI: M2.3 (MOSI), U3.5 (SI), U8.41 (PB5)
unnamed: L1.2, M1.11 (RF_IN), M4.11 (RF_IN), X2.1
unnamed: D2.1 (A), R27.1
unnamed: Q1.1 (G), R2.2, R7.2
unnamed: PAD2.1, Q1.3 (D), SG1.-
unnamed: C6.2, FB1.1, M2.13 (3.3V)
unnamed: M1.8 (!RESET), R8.1
unnamed: M1.9 (VCC_RF), R8.2
unnamed: C8.2, U2.4 (BP)
unnamed: Q2.2 (S), Q3.2 (S), Q4.3 (D)
unnamed: D1.1 (A), R6.1
unnamed: Q2.1 (G), R19.2
unnamed: C11.2, R12.1, U6.5 (OUT)
unnamed: C13.2, U4.1 (CAP-A)
unnamed: C14.2, U4.4 (CAP-R)
unnamed: C12.2, JP2.1, U10.2 (CAP)
unnamed: Q3.1 (G), R1.2
unnamed: J2.D+, R29.2
unnamed: J2.D-, R28.2
unnamed: JP3.1, U10.5 (INT2)
unnamed: Q4.1 (G), R5.2, R20.1, R26.1
unnamed: D3.2 (C), R30.2
unnamed: M2.9 (ANT), X6.1
unnamed: R30.1, U1.1 (STAT)
unnamed: R31.2, U1.5 (PRG)
PYRO1_OUT: Q2.3 (D), R21.1, X4.4
PYRO2_OUT: Q3.3 (D), R22.1, X4.2
RFM_DIO0: M2.14 (DIO0), U8.21 (PB10)
RFM_DIO2: M2.16 (DIO2), U8.2 (PC13)
SAFE: R20.2, X4.6
SCK: M2.4 (SCK), U3.6 (SCK), U8.39 (PB3)
SCL: R3.1, U4.7 (SCL), U5.2 (SCL), U7.P4 (SCK/SCL), U8.45 (PB8), U10.8 (SCL)
SDA: R4.1, U4.6 (SDA), U5.3 (SDA), U7.P6 (SDI/SDA), U8.46 (PB9), U10.7 (SDA)
SENSE_ARM: R26.2, U8.17 (PA7)
SENSE_P1: R22.2, R25.2, U8.14 (PA4)
SENSE_P2: R21.2, R24.2, U8.15 (PA5)
SENSE_VBATT: C10.2, R11.1, R13.2, U8.10 (PA0)
SENSE_VPYRO: R16.2, R23.2, U8.11 (PA1)
SHDN: R10.1, U2.3 (EN), X4.8
SWCLK: J4.3, U8.37 (PA14)
SWDIO: J4.2, U8.34 (PA13)
USB_DM: R28.1, U8.32 (PA11)
USB_DP: R29.1, U8.33 (PA12)
VDD_USB: C19.2, D3.1 (A), J2.VBUS, U1.4 (VDD)
V_BATT: C4.2, C20.2, J1.2, JP1.1, JP5.1, PAD1.1, R10.2, R11.2, SG1.+, U1.3 (BAT), U2.1 (IN)
V_PYRO: J3.2, JP1.2, R12.2, R16.1, X4.1, X4.3

Notes on the sheet:
75uA in Inactive State 15uA Backup battery current
0.2uA in Standby Mode 1.5uA in Idle Mode
Barometer (optional)
SPI Flash (optional)
SUPERCAP HERE (PACKAGE BY JST CONNECTOR)
MPL3115A2 CFG1=open CFG2=open MPL115A2 CFG1=open CFG2=short MS5607-02 CFG1=short CFG2=short

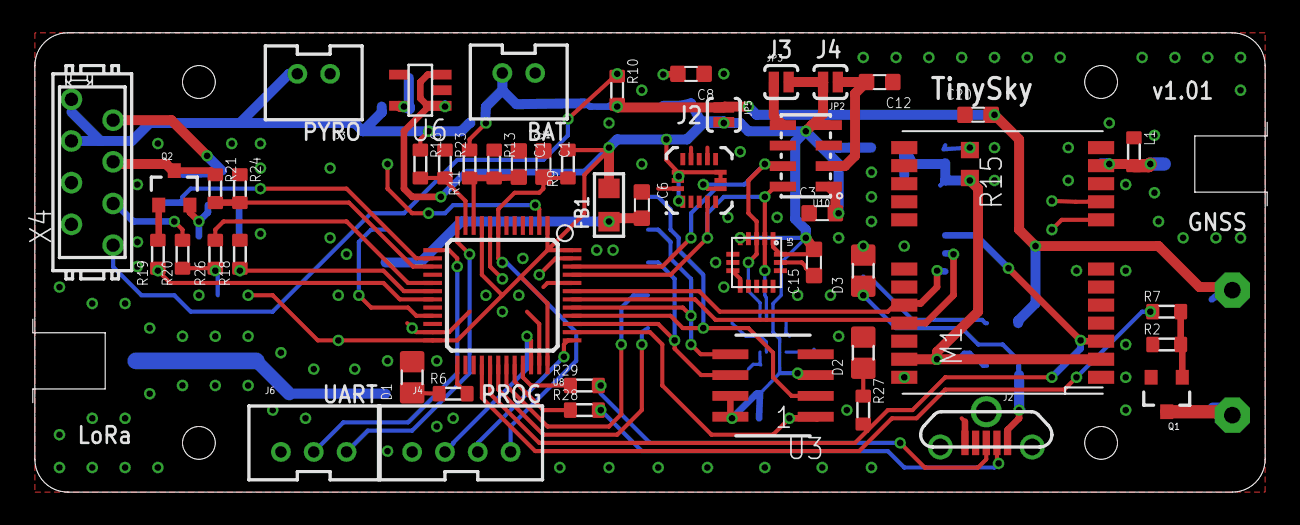
[picture p12: board tracker-25mm-full.brd from above]

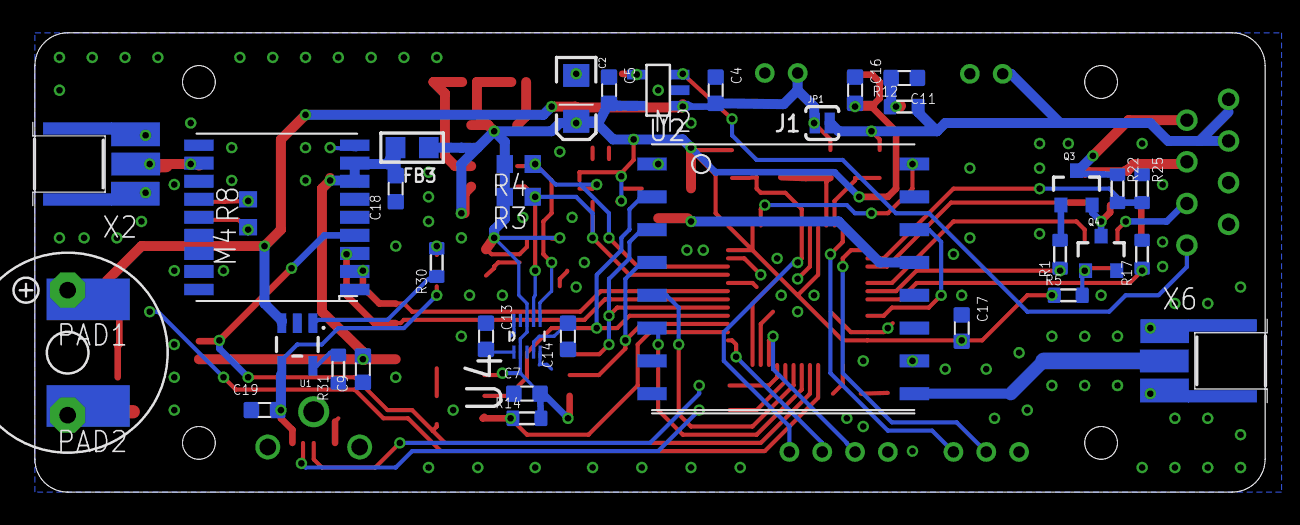
[picture p13: board tracker-25mm-full.brd from below]

Board: 2 copper layers, 75.0 x 28.0 mm, 88 parts (38 on the bottom side), 64 nets.
