kgoba/zinoo/eagle/tracker/flight-28mm.brd

## EAGLE design eagle/tracker/flight-28mm.brd (2018-03-05)

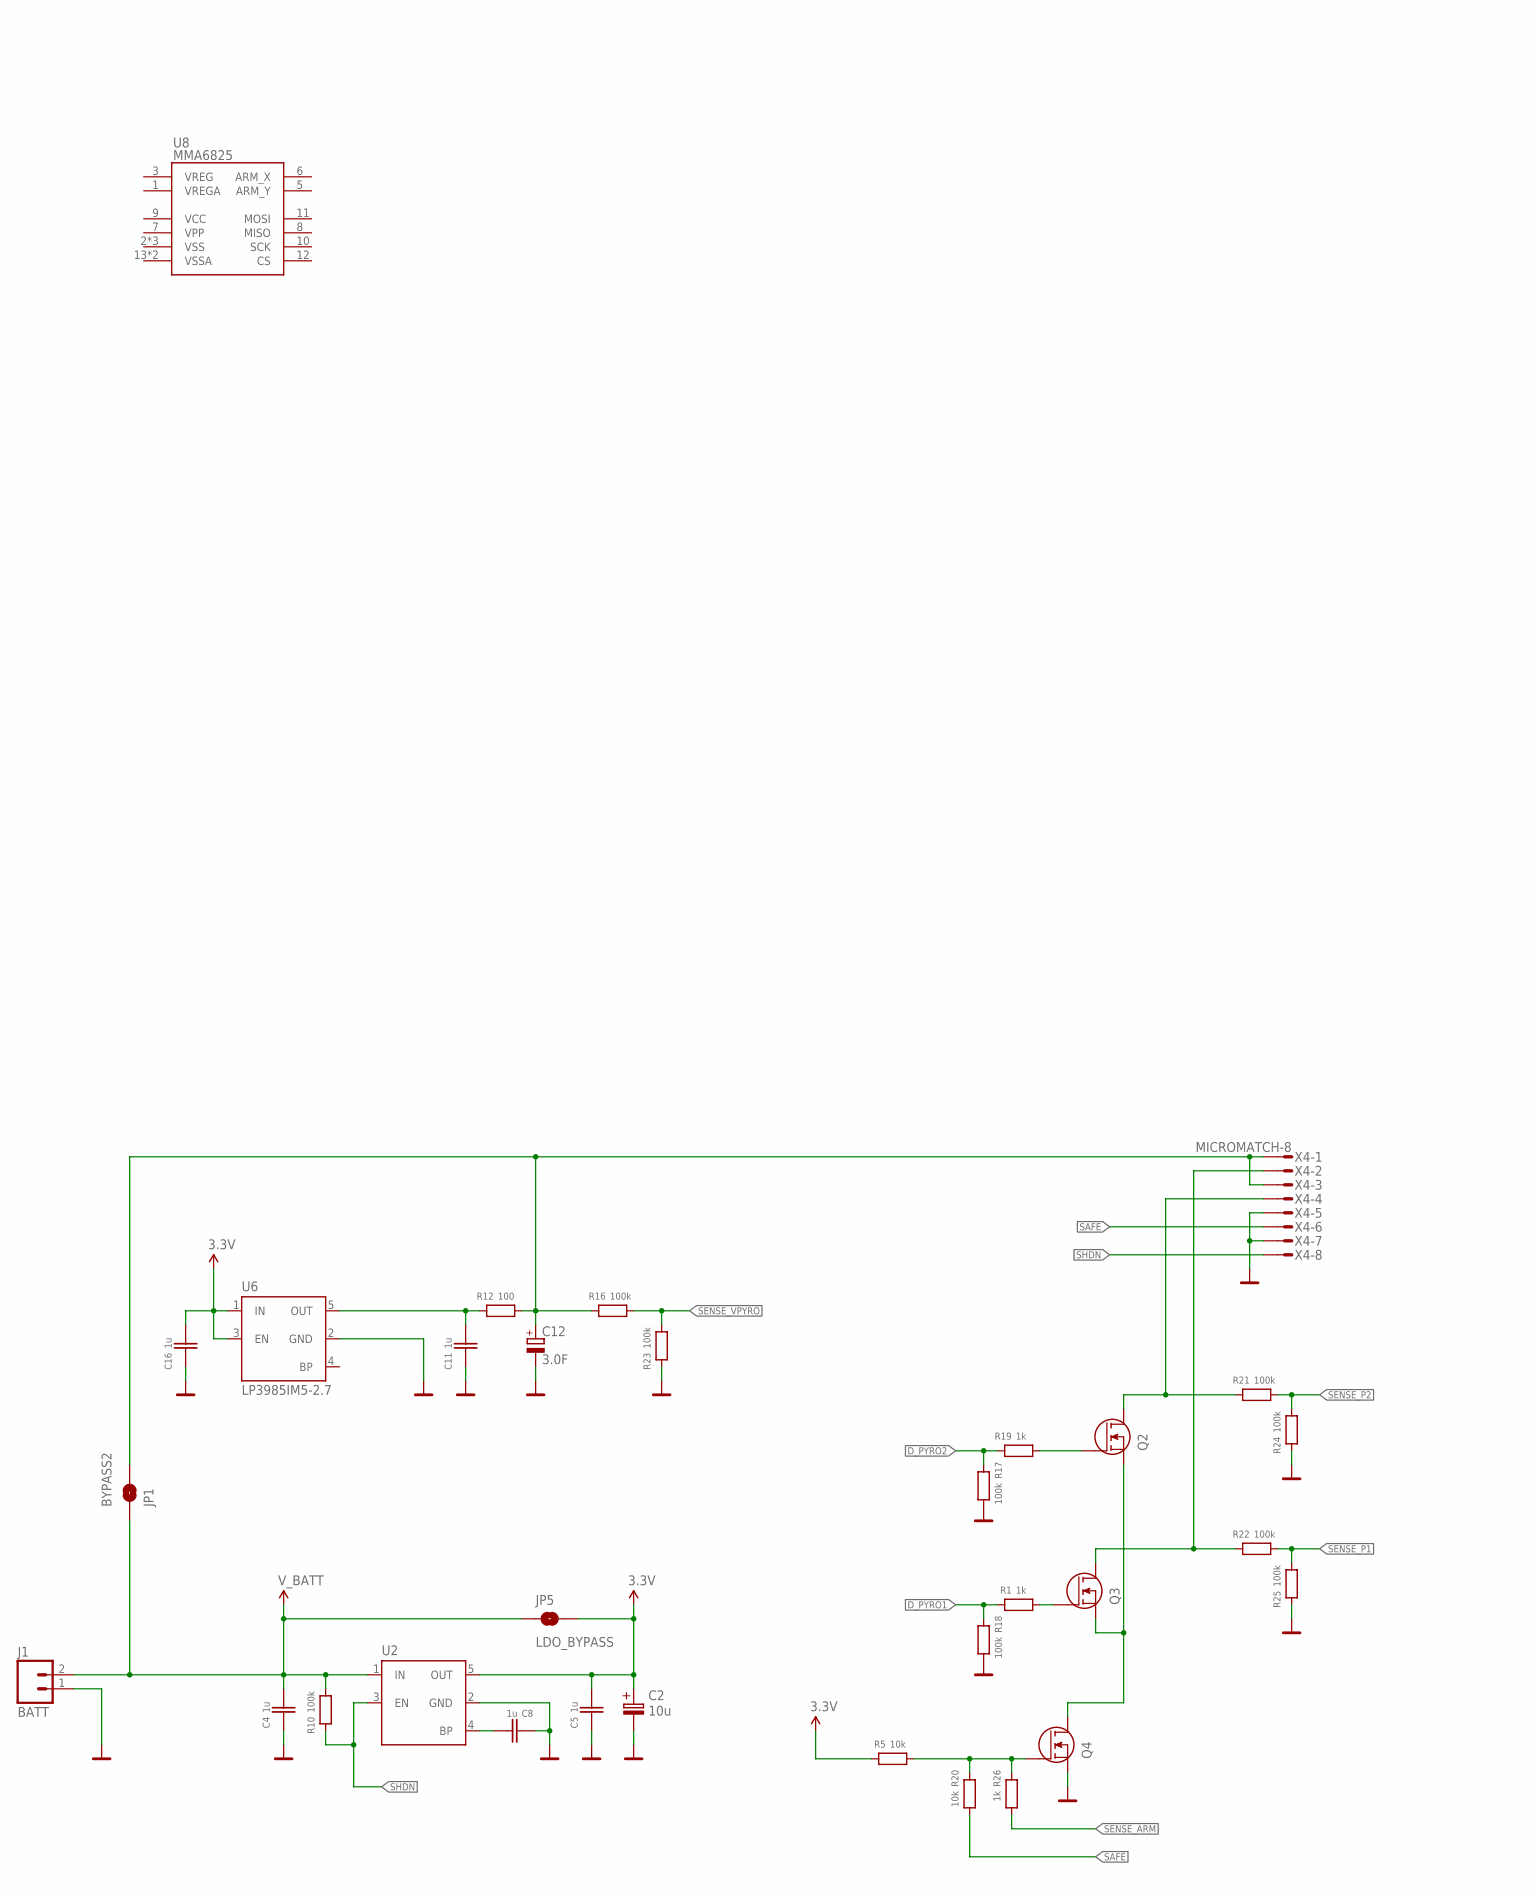
[picture p14: schematic flight-28mm.sch, part in row 1, column 1]

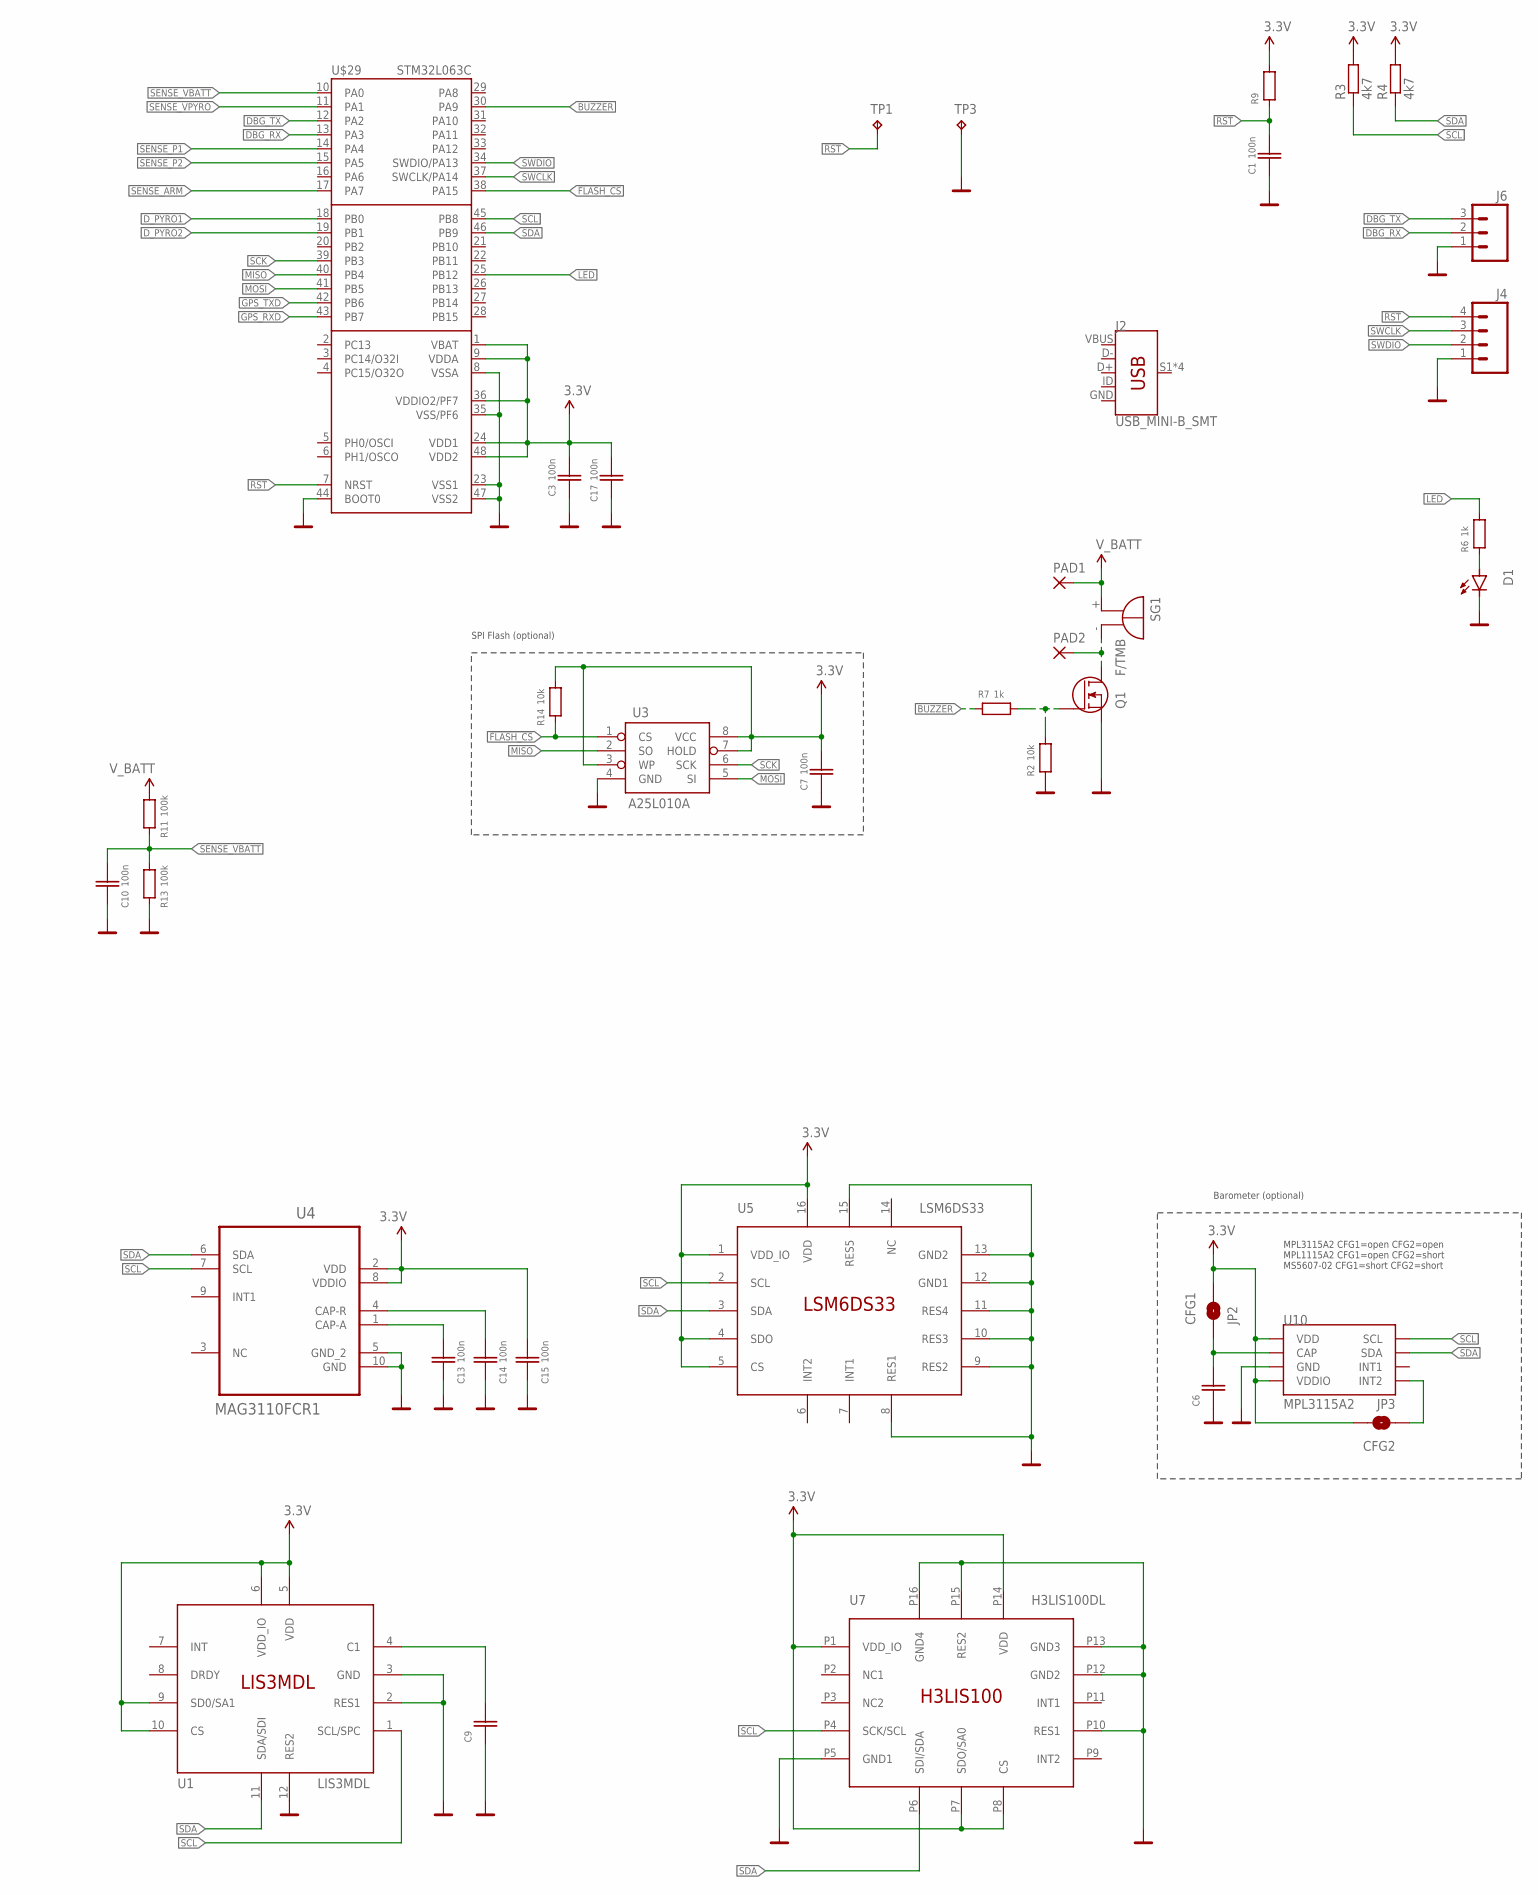
[picture p15: schematic flight-28mm.sch, part in row 1, column 2]

Parts:
C1, C3, C7, C10, C13, C14, C15, C17: 100n; C603
C2: 10u; EIA3216
C4, C5, C8, C11, C16: 1u; C603
C6, C9: CAPACITOR_NPOL-0603; C603
C12: 3.0F; E3,5-8
D1: LED0805; R0805
J1: BATT; JST-2-PTH-VERT
J2: USB_MINI-B_SMT; USB-MINIB
J4: M4-CT-V; JST-4-PTH-VERT
J6: M3-CT-V; JST-3-PTH-VERT
JP1: BYPASS2; PAD-JUMPER-2-NO_YES_SILK
JP2: CFG1; PAD-JUMPER-2-NO_YES_SILK
JP3: CFG2; PAD-JUMPER-2-NO_YES_SILK
JP5: LDO_BYPASS; PAD-JUMPER-2-NO_YES_SILK
PAD1, PAD2: SMD5; SMD2,54-5,08
Q1, Q2, Q3, Q4: MOSFET-N-SOT23-3; SOT23-3
R1, R6, R7, R19, R26: 1k; R0603
R2, R5, R14, R20: 10k; R0603
R3, R4: 4k7; R0603
R9: RESISTOR-0603; R0603
R10, R11, R13, R16, R17, R18, R21, R22, R23, R24, R25: 100k; R0603
R12: 100; R0603
SG1: F/TMB
TP1, TP3: TPB1,27; B1,27
U1: LIS3MDL; VFLGA-12
U2: VREG-5PIN-SOT23; SOT23-5
U3: A25L010A; SOP08
U4: MAG3110FCR1; DFN200X200X90-10N
U5: LSM6DS33; TFLGA16L
U6: LP3985IM5-2.7; SOT23-5
U7: H3LIS100DL; QFN16_3X5
U8: MMA6825; QFN16_6X6
U10: MPL3115A2; LGA8
U$29: STM32L063C; LQFP48
X4: MICROMATCH-8

Connections:
3.3V: C2.A (+), C3.2, C5.2, C7.2, C15.2, C16.2, C17.2, JP2.2, JP3.2, JP5.2, R3.2, R4.2, R5.1, R9.2, R14.2, U1.5 (VDD), U1.6 (VDD_IO), U1.9 (SD0/SA1), U1.10 (CS), U2.5 (OUT), U3.3 (WP), U3.7 (HOLD), U3.8 (VCC), U4.2 (VDD), U4.8 (VDDIO), U5.1 (VDD_IO), U5.4 (SDO), U5.5 (CS), U5.16 (VDD), U6.1 (IN), U6.3 (EN), U7.P1 (VDD_IO), U7.P7 (SDO/SA0), U7.P8 (CS), U7.P14 (VDD), U10.1 (VDD), U10.4 (VDDIO), U$29.1 (VBAT), U$29.9 (VDDA), U$29.24 (VDD1), U$29.36 (VDDIO2/PF7), U$29.48 (VDD2)
!FLASH_CS: R14.1, U3.1 (CS), U$29.38 (PA15)
!RST: C1.2, J4.4, R9.1, TP1.TP, U$29.7 (NRST)
BUZZER: R7.1, U$29.30 (PA9)
DBG_RX: J6.2, U$29.13 (PA3)
DBG_TX: J6.3, U$29.12 (PA2)
D_PYRO1: R1.1, R18.1, U$29.18 (PB0)
D_PYRO2: R17.1, R19.1, U$29.19 (PB1)
GND: C1.1, C2.C (-), C3.1, C4.1, C5.1, C6.1, C7.1, C8.1, C9.1, C10.1, C11.1, C12.-, C13.1, C14.1, C15.1, C16.1, C17.1, D1.2 (C), J1.1, J2.GND, J4.1, J6.1, Q1.2 (S), Q4.2 (S), R2.1, R13.1, R17.2, R18.2, R23.1, R24.1, R25.1, TP3.TP, U1.2 (RES1), U1.3 (GND), U1.12 (RES2), U2.2 (GND), U3.4 (GND), U4.5 (GND_2), U4.10 (GND), U5.8 (RES1), U5.9 (RES2), U5.10 (RES3), U5.11 (RES4), U5.12 (GND1), U5.13 (GND2), U5.15 (RES5), U6.2 (GND), U7.P5 (GND1), U7.P10 (RES1), U7.P12 (GND2), U7.P13 (GND3), U7.P15 (RES2), U7.P16 (GND4), U10.3 (GND), U$29.8 (VSSA), U$29.23 (VSS1), U$29.35 (VSS/PF6), U$29.44 (BOOT0), U$29.47 (VSS2), X4.5, X4.7
GPS_RXD: U$29.43 (PB7)
GPS_TXD: U$29.42 (PB6)
LED: R6.2, U$29.25 (PB12)
MISO: U3.2 (SO), U$29.40 (PB4)
MOSI: U3.5 (SI), U$29.41 (PB5)
unnamed: C9.2, U1.4 (C1)
unnamed: Q1.1 (G), R2.2, R7.2
unnamed: PAD2.1, Q1.3 (D), SG1.-
unnamed: C8.2, U2.4 (BP)
unnamed: Q2.2 (S), Q3.2 (S), Q4.3 (D)
unnamed: D1.1 (A), R6.1
unnamed: Q2.1 (G), R19.2
unnamed: C11.2, R12.1, U6.5 (OUT)
unnamed: C13.2, U4.1 (CAP-A)
unnamed: C14.2, U4.4 (CAP-R)
unnamed: C6.2, JP2.1, U10.2 (CAP)
unnamed: Q3.1 (G), R1.2
unnamed: JP3.1, U10.5 (INT2)
unnamed: Q4.1 (G), R5.2, R20.1, R26.1
PYRO1_OUT: Q2.3 (D), R21.1, X4.4
PYRO2_OUT: Q3.3 (D), R22.1, X4.2
SAFE: R20.2, X4.6
SCK: U3.6 (SCK), U$29.39 (PB3)
SCL: R3.1, U1.1 (SCL/SPC), U4.7 (SCL), U5.2 (SCL), U7.P4 (SCK/SCL), U10.8 (SCL), U$29.45 (PB8)
SDA: R4.1, U1.11 (SDA/SDI), U4.6 (SDA), U5.3 (SDA), U7.P6 (SDI/SDA), U10.7 (SDA), U$29.46 (PB9)
SENSE_ARM: R26.2, U$29.17 (PA7)
SENSE_P1: R22.2, R25.2, U$29.14 (PA4)
SENSE_P2: R21.2, R24.2, U$29.15 (PA5)
SENSE_VBATT: C10.2, R11.1, R13.2, U$29.10 (PA0)
SENSE_VPYRO: R16.2, R23.2, U$29.11 (PA1)
SHDN: R10.1, U2.3 (EN), X4.8
SWCLK: J4.3, U$29.37 (SWCLK/PA14)
SWDIO: J4.2, U$29.34 (SWDIO/PA13)
VBUS: J2.VBUS
VCC: U8.9 (VCC)
VPP: U8.7 (VPP)
VSS: U8.2 (VSS), U8.4 (VSS), U8.PAD (VSS)
VSSA: U8.13 (VSSA), U8.16 (VSSA)
V_BATT: C4.2, J1.2, JP1.1, JP5.1, PAD1.1, R10.2, R11.2, SG1.+, U2.1 (IN)
V_PYRO: C12.+, JP1.2, R12.2, R16.1, X4.1, X4.3

Notes on the sheet:
Barometer (optional)
SPI Flash (optional)
MPL3115A2 CFG1=open CFG2=open MPL1115A2 CFG1=open CFG2=short MS5607-02 CFG1=short CFG2=short

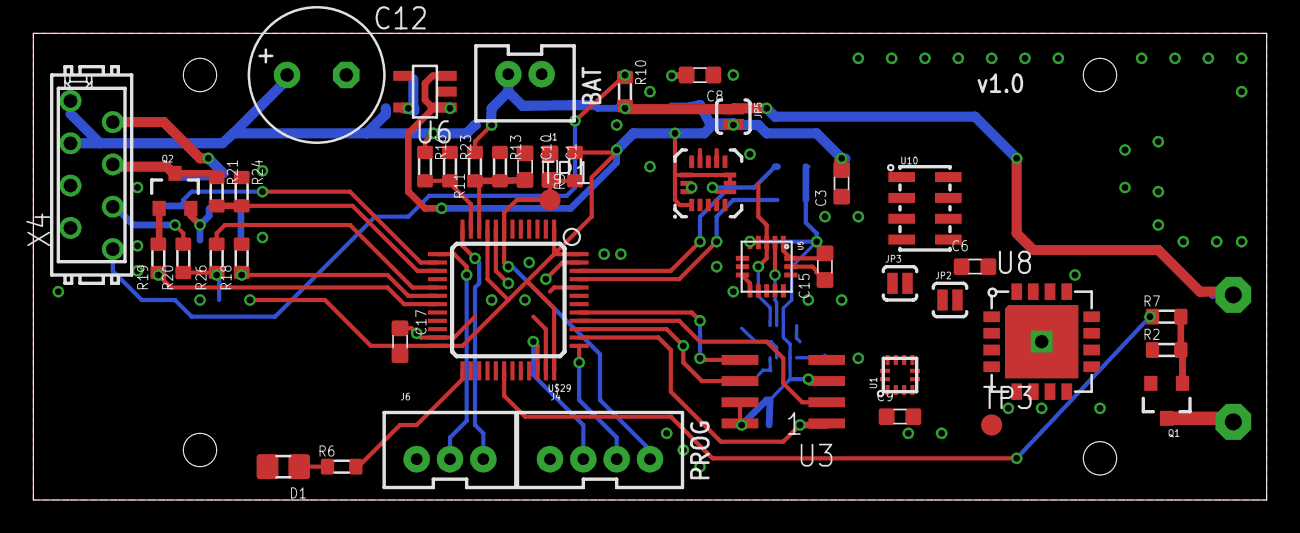
[picture p16: board flight-28mm.brd from above]

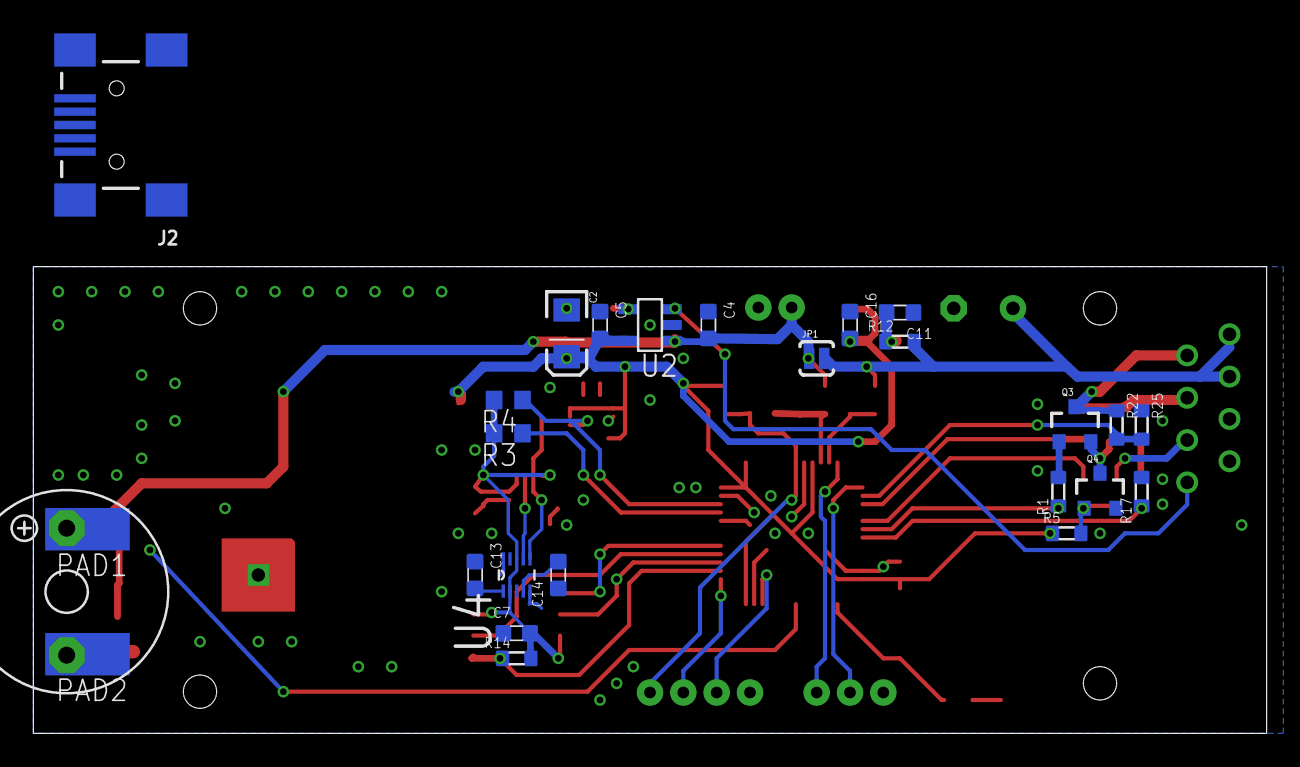
[picture p17: board flight-28mm.brd from below]

Board: 2 copper layers, 74.0 x 28.0 mm, 70 parts (26 on the bottom side), 44 nets.
