kgoba/zinoo/eagle/tracker/tracker-ground-v1_1.brd

## EAGLE design eagle/tracker/tracker-ground-v1_1.brd (2018-03-05)

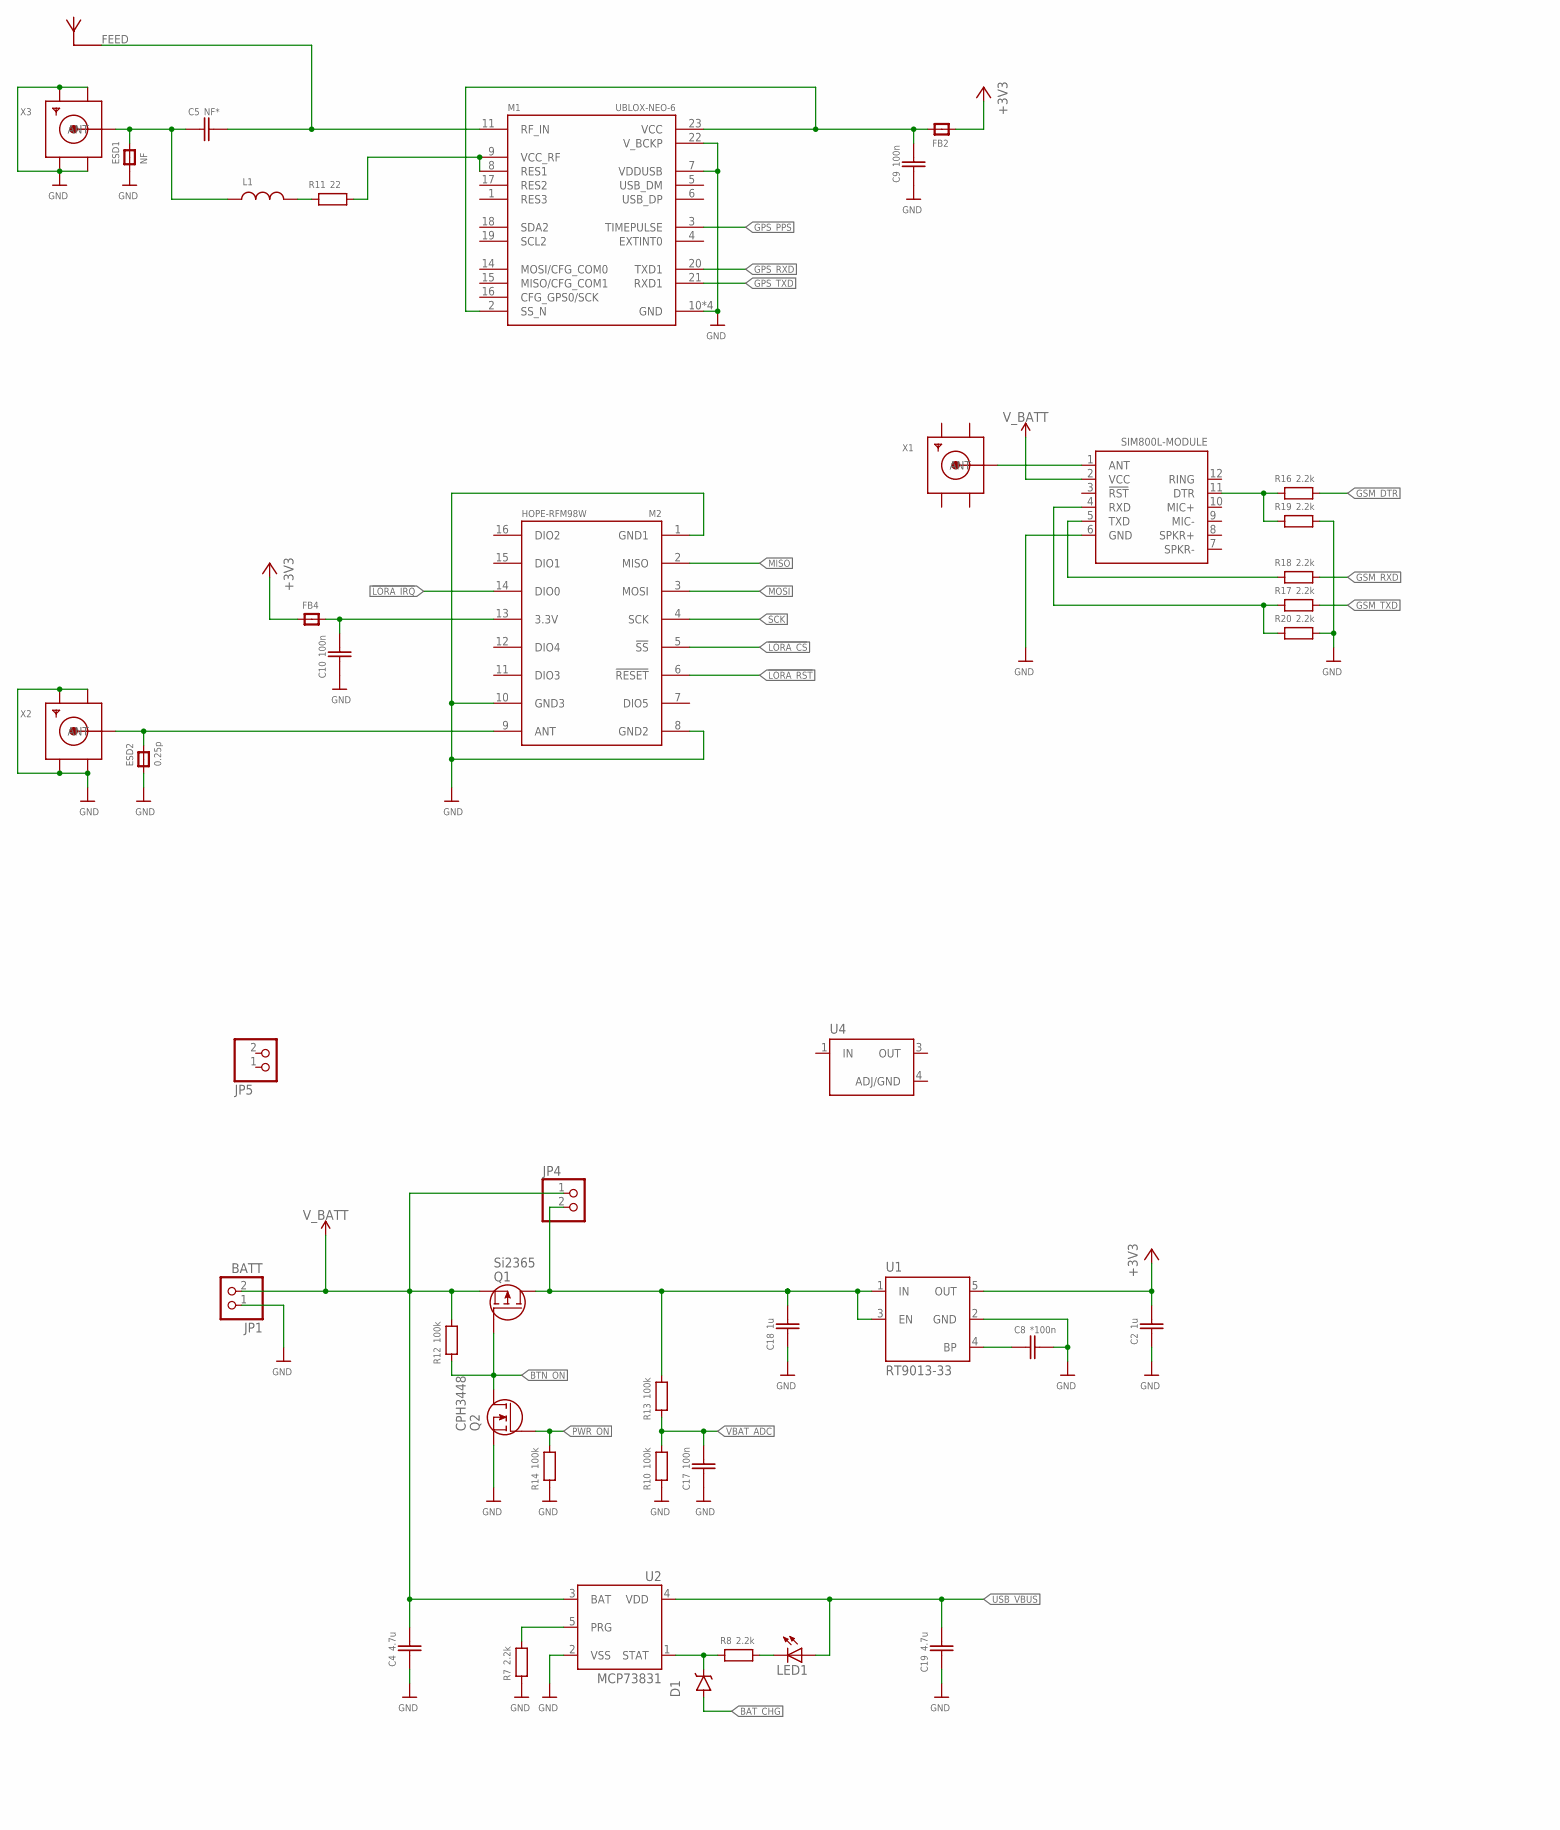
[picture p18: schematic tracker-ground-v1_1.sch, part in row 1, column 1]

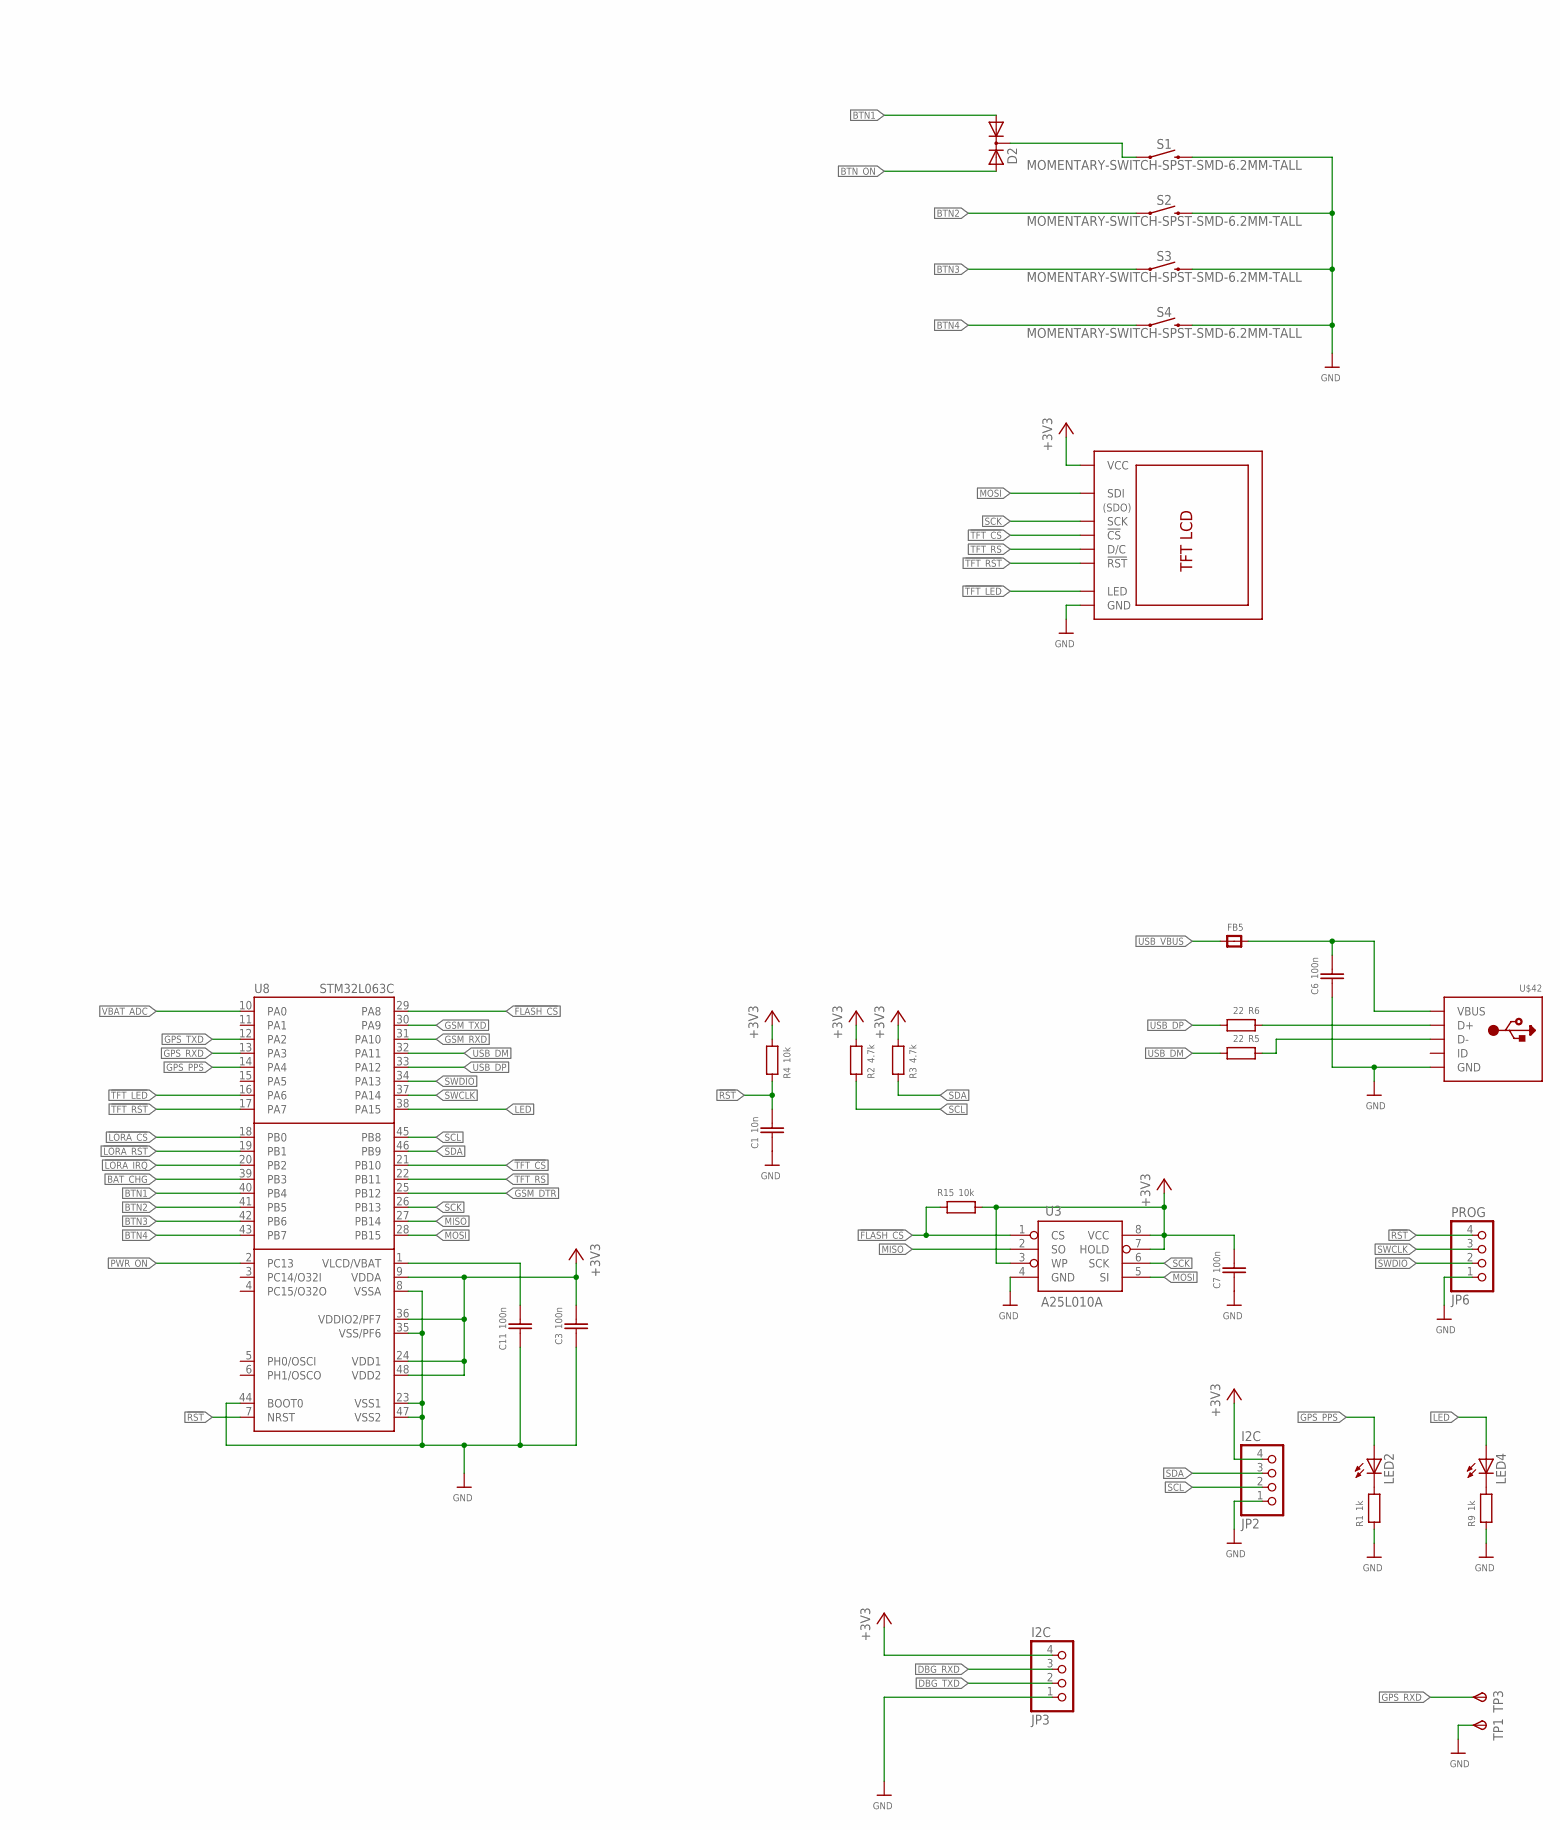
[picture p19: schematic tracker-ground-v1_1.sch, part in row 1, column 2]

Parts:
C1: 10n; C603
C2, C18: 1u; C603
C3, C6, C7, C9, C10, C11, C17: 100n; C603
C4, C19: 4.7u; C1206
C5: NF*; C603
C8: *100n; C603
D1: DIODE-SCHOTTKY-SOD323; SOD-323
D2: DIODE-2AC|CASOT23; SOT23
ESD1: NF; _0603MP
ESD2: 0.25p; _0603MP
FB2, FB4, FB5: FERRITE_0805; _0805
JP1: BATT; 1X02
JP2, JP3: I2C; 1X04
JP4, JP5: PINHD-1X2; 1X02
JP6: PROG; 1X04
L1: L-0805; R0805
LED1, LED2, LED4: LEDCHIPLED_0805; CHIPLED_0805
M1: UBLOX-NEO-6; UBLOX-NEO
M2: HOPE-RFM98W; HOPE-RFM
M3: TFT-2.0-OPENSMART-THT; TFT-2.0-OPENSMART
M5: SIM800L-MODULE; SIM800L-BOARD
Q1: Si2365; SOT23-3
Q2: CPH3448; SOT23-3
R1, R9: 1k; R0603
R2, R3: 4.7k; R0603
R4, R15: 10k; R0603
R5, R6, R11: 22; R0603
R7, R8, R16, R17, R18, R19, R20: 2.2k; R0603
R10, R12, R13, R14: 100k; R0603
S1, S2, S3, S4: MOMENTARY-SWITCH-SPST-SMD-6.2MM-TALL; TACTILE_SWITCH_SMD_6.2MM_TALL
TP1, TP3: TPSB1,27; B1,27
U1: RT9013-33; SOT23-5
U2: MCP73831; SOT23-5
U3: A25L010A; SOP08
U4: VREG-3PIN-DPAK; DPAK
U8: STM32L063C; LQFP48
U$42: USBMINIB; USB-MINIB
X1, X2, X3: SMACONNECTOR_EDGE; SMA_EDGELAUNCH
X4: ANTENNA-PATCH-12X12; ANT-PATCH-12X12

Connections:
!FLASH_CS: R15.1, U3.1 (CS), U8.29 (PA8)
!LORA_CS: M2.5 (!SS), U8.18 (PB0)
!LORA_IRQ: M2.14 (DIO0), U8.20 (PB2)
!LORA_RST: M2.6 (!RESET), U8.19 (PB1)
!RST: C1.2, JP6.4, R4.1, U8.7 (NRST)
!TFT_CS: M3.P$6 (!CS), U8.21 (PB10)
!TFT_LED: M3.P$8 (LED), U8.16 (PA6)
!TFT_RST: M3.P$7 (!RST), U8.17 (PA7)
+3V3: C2.2, C3.2, C7.2, FB2.1, FB4.2, JP2.4, JP3.4, M3.P$2 (VCC), R2.2, R3.2, R4.2, R15.2, U1.5 (OUT), U3.3 (WP), U3.7 (HOLD), U3.8 (VCC), U8.9 (VDDA), U8.24 (VDD1), U8.36 (VDDIO2/PF7), U8.48 (VDD2)
BAT_CHG: D1.A, U8.39 (PB3)
BTN1: D2.1 (A1), U8.40 (PB4)
BTN2: S2.A2 (1), U8.41 (PB5)
BTN3: S3.A2 (1), U8.42 (PB6)
BTN4: S4.A2 (1), U8.43 (PB7)
BTN_ON: D2.2 (A2), Q1.1 (G), Q2.3 (D), R12.1
DBG_RXD: JP3.3
DBG_TXD: JP3.2
GND: C1.1, C2.1, C3.1, C4.1, C6.1, C7.1, C8.2, C9.1, C10.1, C11.1, C17.1, C18.1, C19.1, ESD1.1, ESD2.1, JP1.1, JP2.1, JP3.1, JP6.1, M1.7 (VDDUSB), M1.10 (GND), M1.12 (GND), M1.13 (GND), M1.22 (V_BCKP), M1.24 (GND), M2.1 (GND1), M2.8 (GND2), M2.10 (GND3), M3.P$1 (GND), M5.6 (GND), Q2.2 (S), R1.1, R7.1, R9.1, R10.1, R14.1, R19.2, R20.2, S1.B2 (2), S2.B2 (2), S3.B2 (2), S4.B2 (2), TP1.TP, U1.2 (GND), U2.2 (VSS), U3.4 (GND), U8.8 (VSSA), U8.23 (VSS1), U8.35 (VSS/PF6), U8.44 (BOOT0), U8.47 (VSS2), U$42.GND, X2.GND@1 (GND4), X2.GND@2 (GND3), X2.GND@3 (GND2), X2.GND@4 (GND1), X3.GND@1 (GND4), X3.GND@2 (GND3), X3.GND@3 (GND2), X3.GND@4 (GND1)
GND1: X1.GND@4 (GND1)
GND2: X1.GND@3 (GND2)
GND3: X1.GND@2 (GND3)
GND4: X1.GND@1 (GND4)
GPS_PPS: LED2.A, M1.3 (TIMEPULSE), U8.14 (PA4)
GPS_RXD: M1.20 (TXD1), TP3.TP, U8.13 (PA3)
GPS_TXD: M1.21 (RXD1), U8.12 (PA2)
GSM_DTR: R16.2, U8.25 (PB12)
GSM_RXD: R18.2, U8.31 (PA10)
GSM_TXD: R17.2, U8.30 (PA9)
LED: LED4.A, U8.38 (PA15)
MISO: M2.2 (MISO), U3.2 (SO), U8.27 (PB14)
MOSI: M2.3 (MOSI), M3.P$3 (SDI), U3.5 (SI), U8.28 (PB15)
unnamed: LED4.C, R9.2
unnamed: M1.8 (RES1), M1.9 (VCC_RF), R11.2
unnamed: C8.1, U1.4 (BP)
unnamed: LED2.C, R1.2
unnamed: L1.2, R11.1
unnamed: R7.2, U2.5 (PRG)
unnamed: C5.1, ESD1.2, L1.1, X3.P (ANT)
unnamed: LED1.C, R8.2
unnamed: C18.2, JP4.2, Q1.3 (D), R13.2, U1.1 (IN), U1.3 (EN)
unnamed: C5.2, M1.11 (RF_IN), X4.FEED
unnamed: D2.3 (C), S1.A2 (1)
unnamed: D1.C, R8.1, U2.1 (STAT)
unnamed: C11.2, U8.1 (VLCD/VBAT)
unnamed: M5.1 (ANT), X1.P (ANT)
unnamed: M5.11 (DTR), R16.1, R19.1
unnamed: M5.5 (TXD), R18.1
unnamed: C6.2, FB5.2, U$42.VBUS
unnamed: M5.4 (RXD), R17.1, R20.1
unnamed: C10.2, FB4.1, M2.13 (3.3V)
unnamed: R5.1, U$42.D-
unnamed: ESD2.2, M2.9 (ANT), X2.P (ANT)
unnamed: R6.1, U$42.D+
unnamed: C9.2, FB2.2, M1.2 (SS_N), M1.23 (VCC)
PWR_ON: Q2.1 (G), R14.2, U8.2 (PC13)
SCK: M2.4 (SCK), M3.P$4 (SCK), U3.6 (SCK), U8.26 (PB13)
SCL: JP2.2, R2.1, U8.45 (PB8)
SDA: JP2.3, R3.1, U8.46 (PB9)
SWCLK: JP6.3, U8.37 (PA14)
SWDIO: JP6.2, U8.34 (PA13)
TFT_RS: M3.P$5 (D/C), U8.22 (PB11)
USB_DM: R5.2, U8.32 (PA11)
USB_DP: R6.2, U8.33 (PA12)
USB_VBUS: C19.2, FB5.1, LED1.A, U2.4 (VDD)
VBAT_ADC: C17.2, R10.2, R13.1, U8.10 (PA0)
V_BATT: C4.2, JP1.2, JP4.1, M5.2 (VCC), Q1.2 (S), R12.2, U2.3 (BAT)

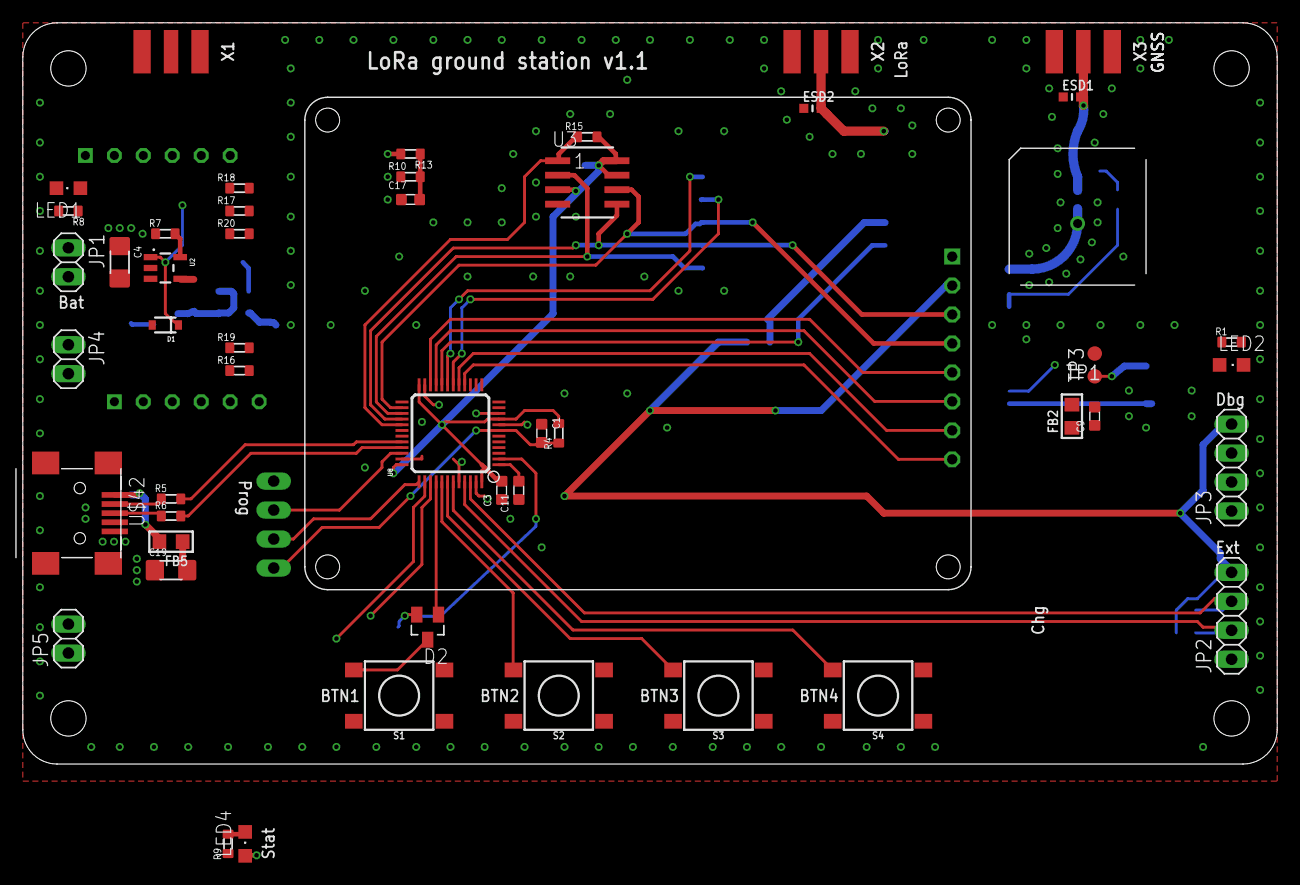
[picture p20: board tracker-ground-v1_1.brd from above]

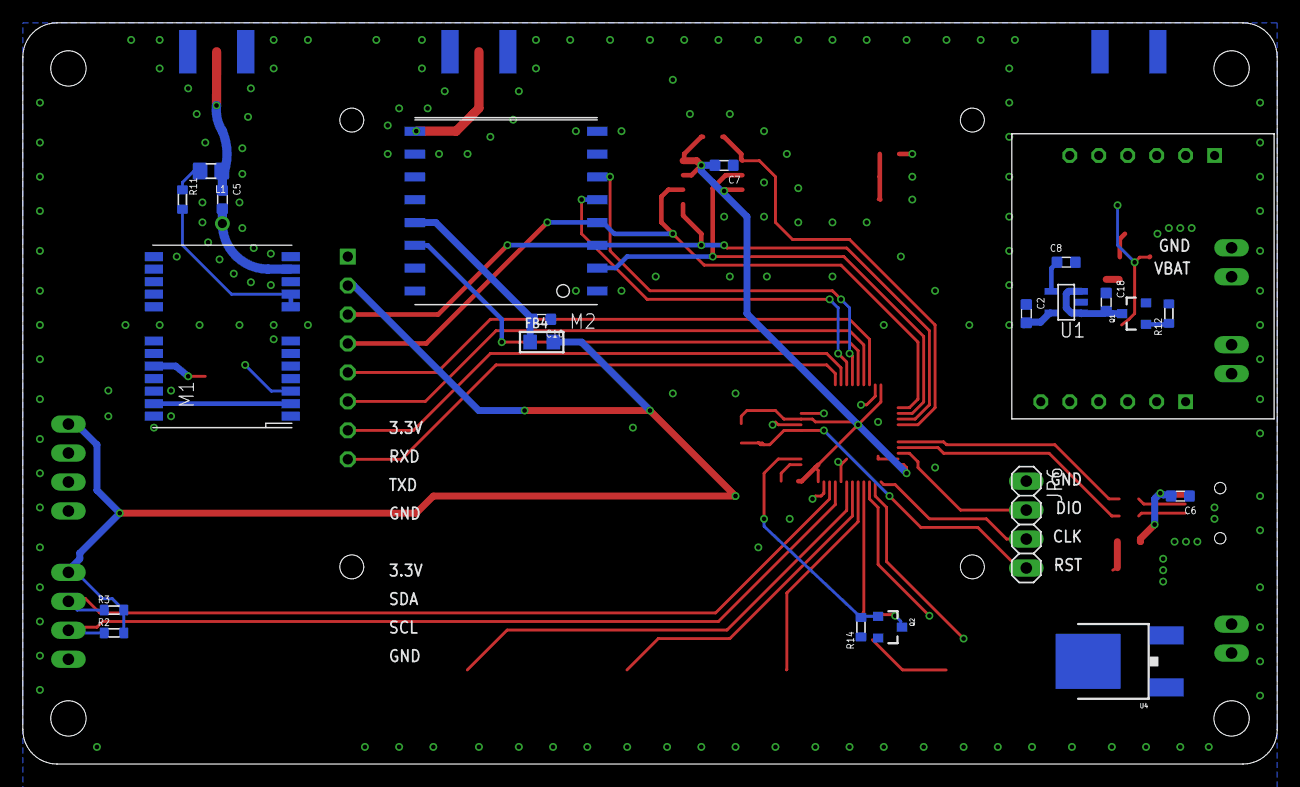
[picture p21: board tracker-ground-v1_1.brd from below]

Board: 2 copper layers, 110.0 x 65.0 mm, 73 parts (22 on the bottom side), 60 nets.
