kgoba/zinoo/eagle/tracker/tracker-balloon-full.brd

## EAGLE design eagle/tracker/tracker-balloon-full.brd (2018-02-22)

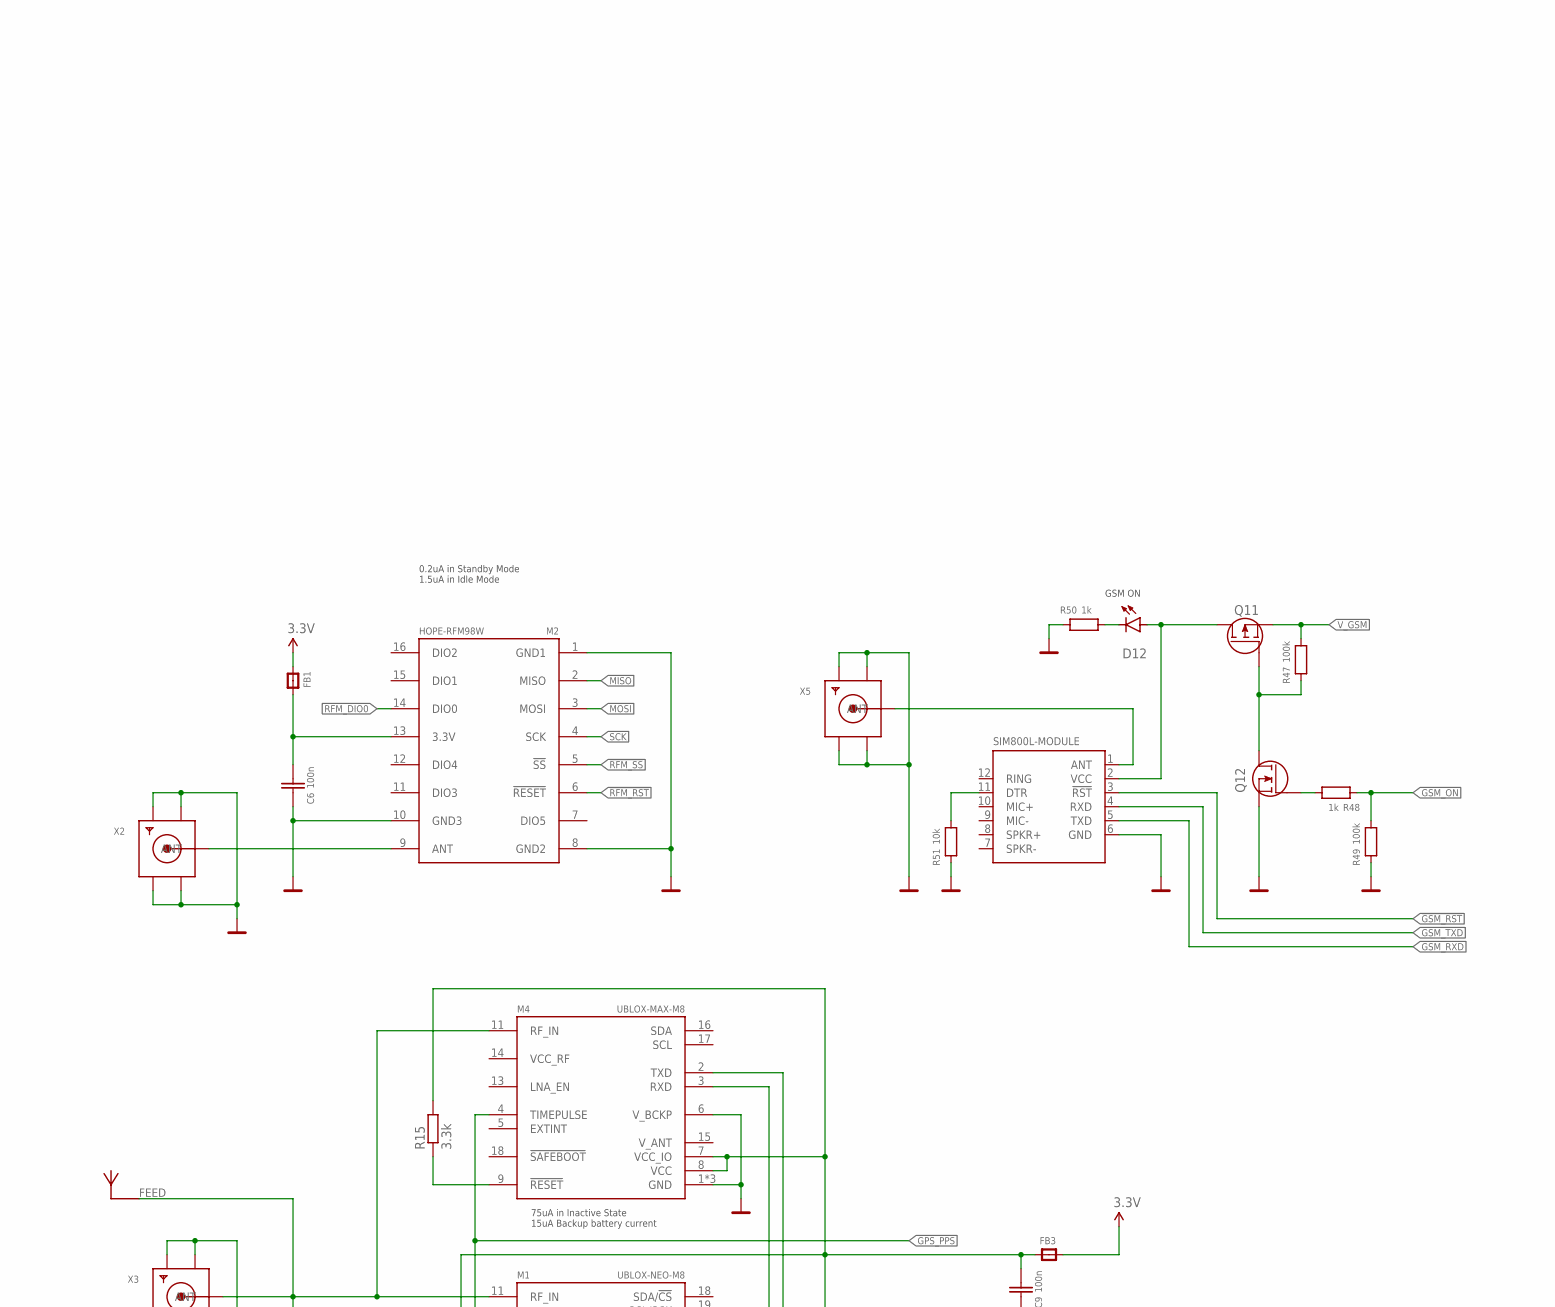
[picture p22: schematic tracker-balloon-full.sch, part in row 1, column 1]

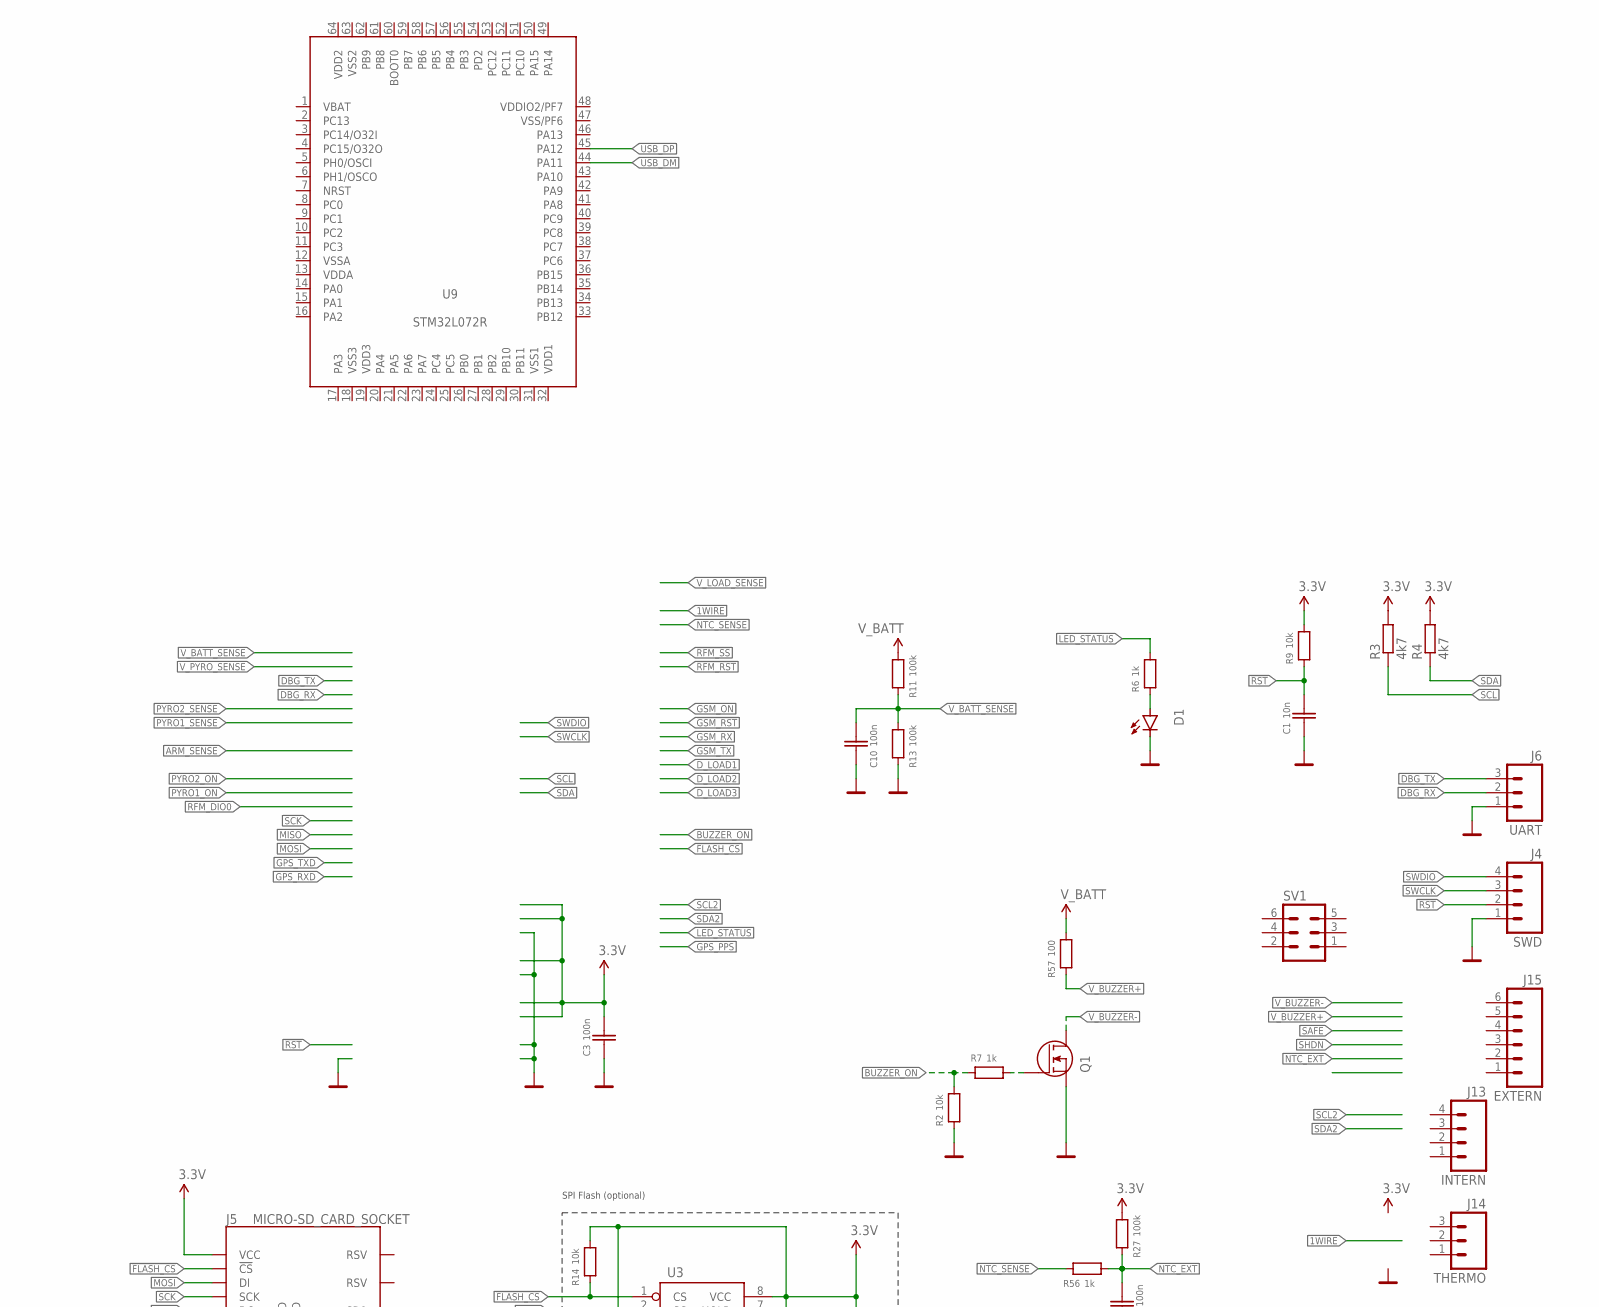
[picture p23: schematic tracker-balloon-full.sch, part in row 1, column 2]

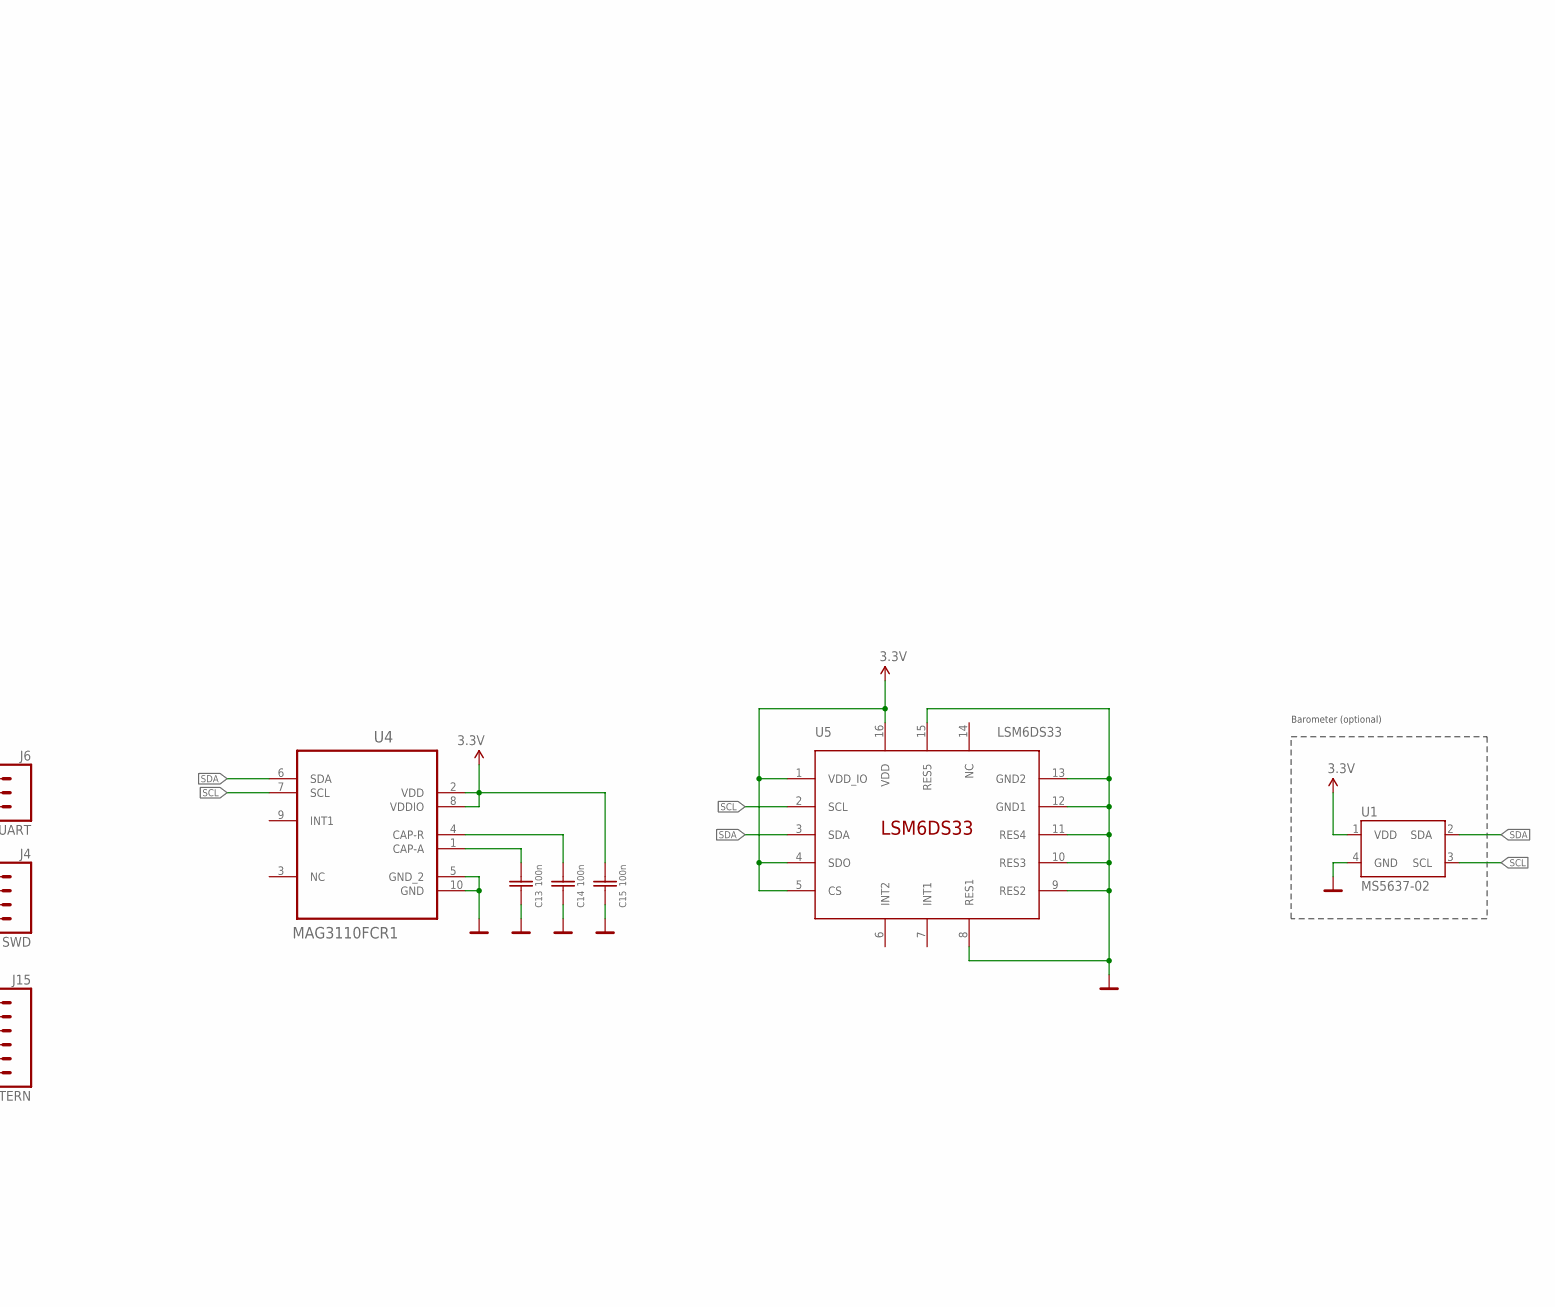
[picture p24: schematic tracker-balloon-full.sch, part in row 1, column 3]

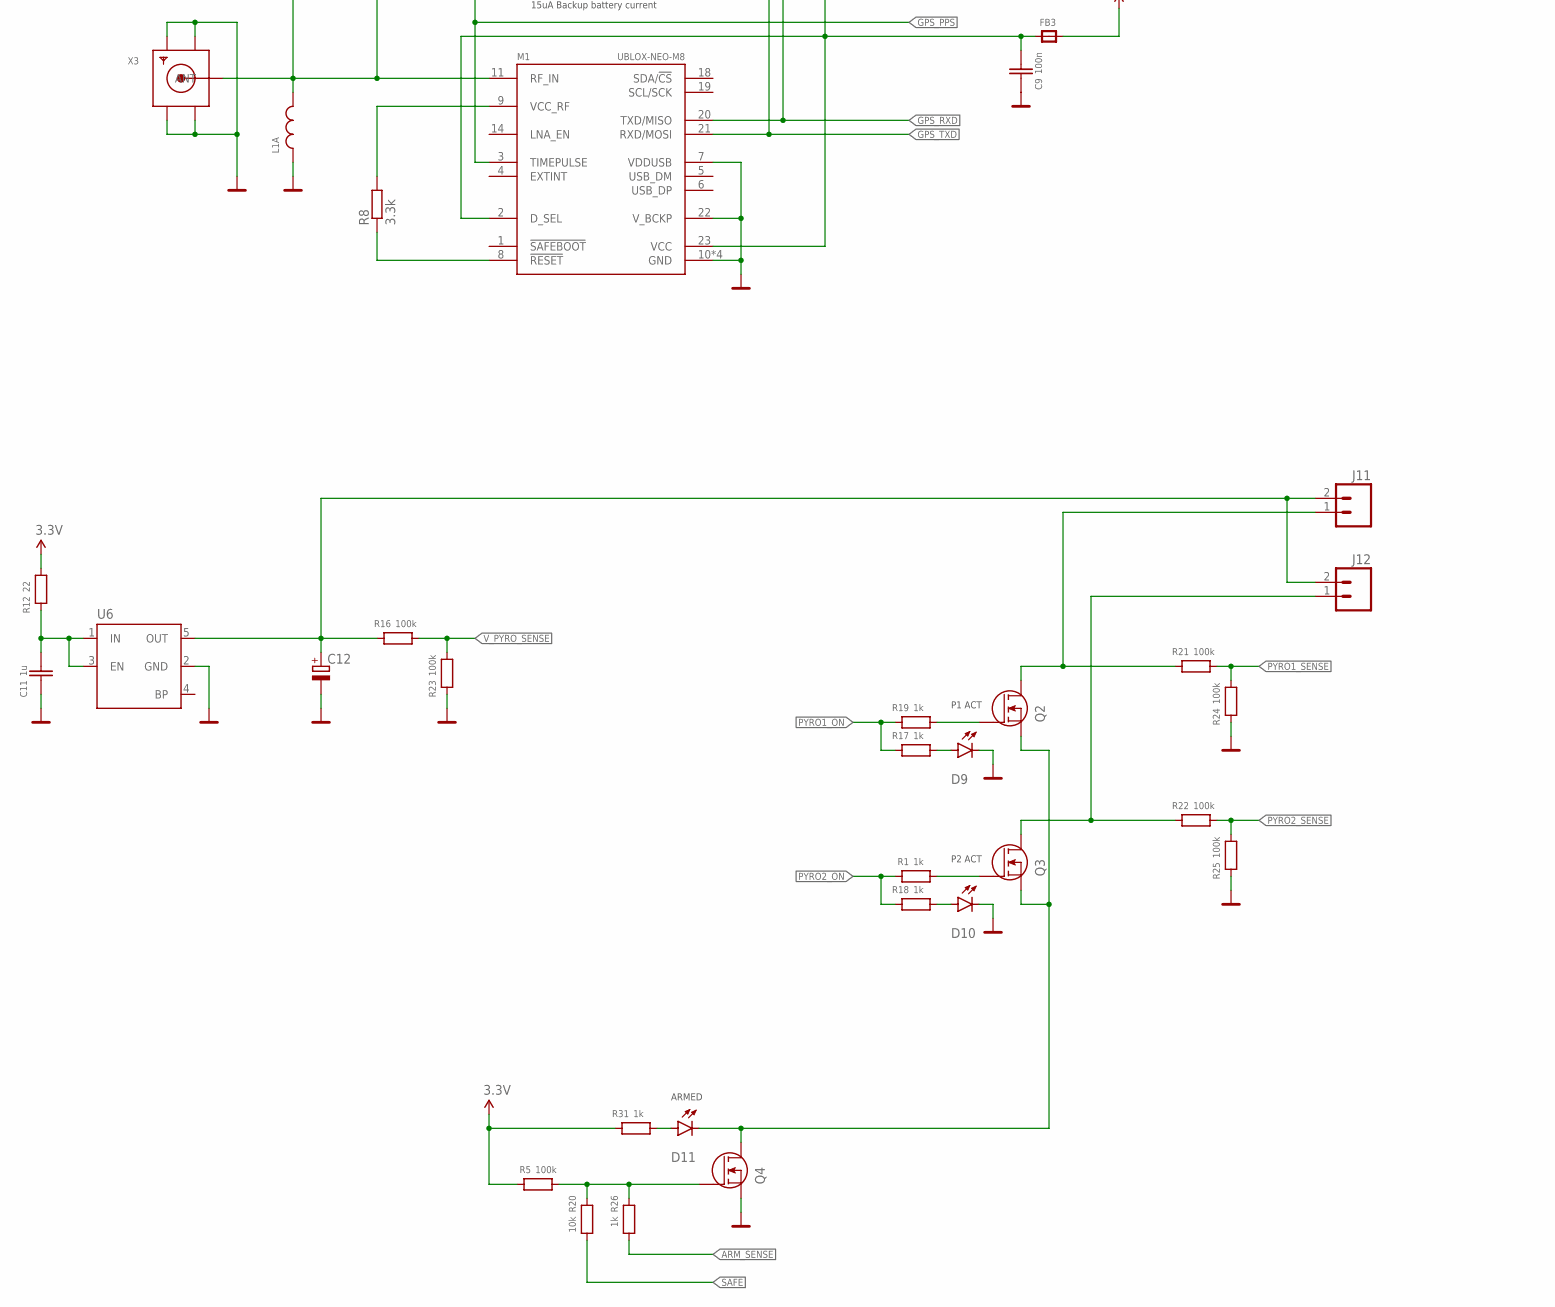
[picture p25: schematic tracker-balloon-full.sch, part in row 2, column 1]

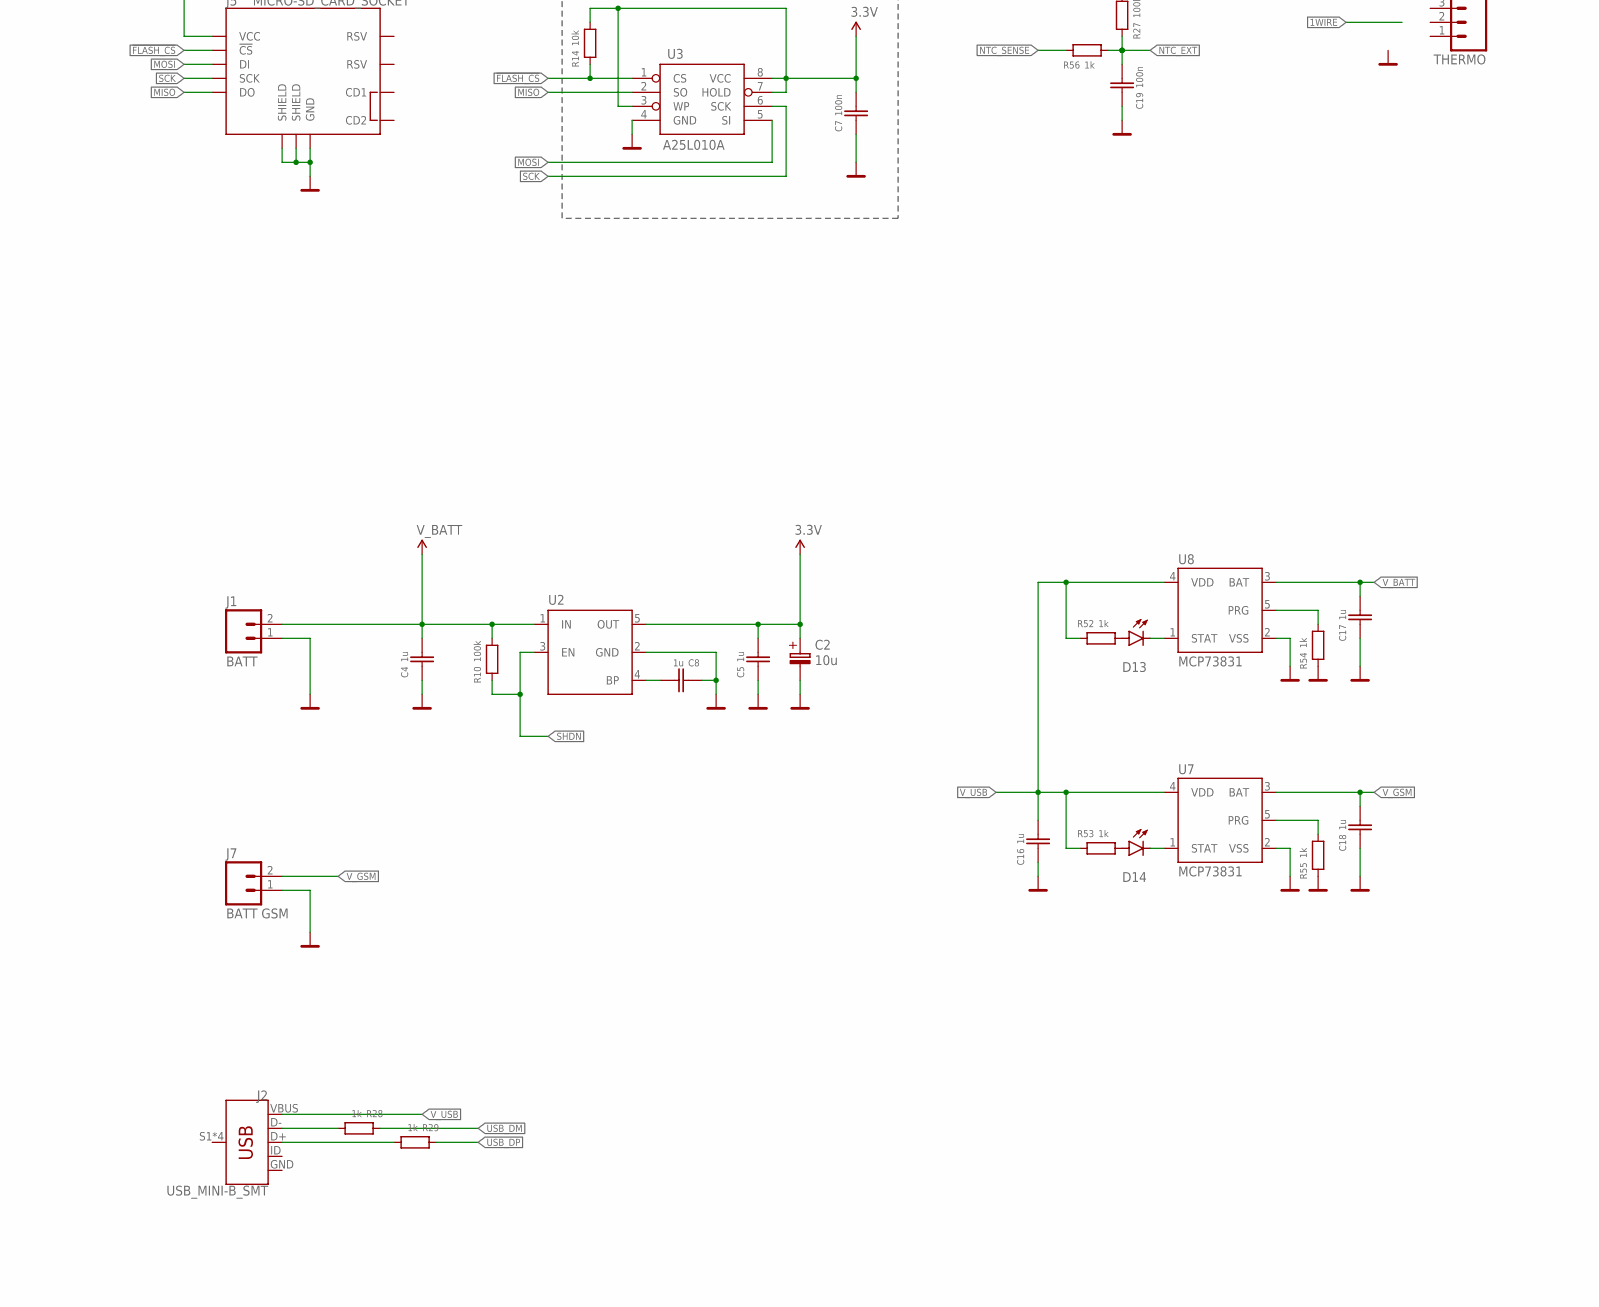
[picture p26: schematic tracker-balloon-full.sch, part in row 2, column 2]

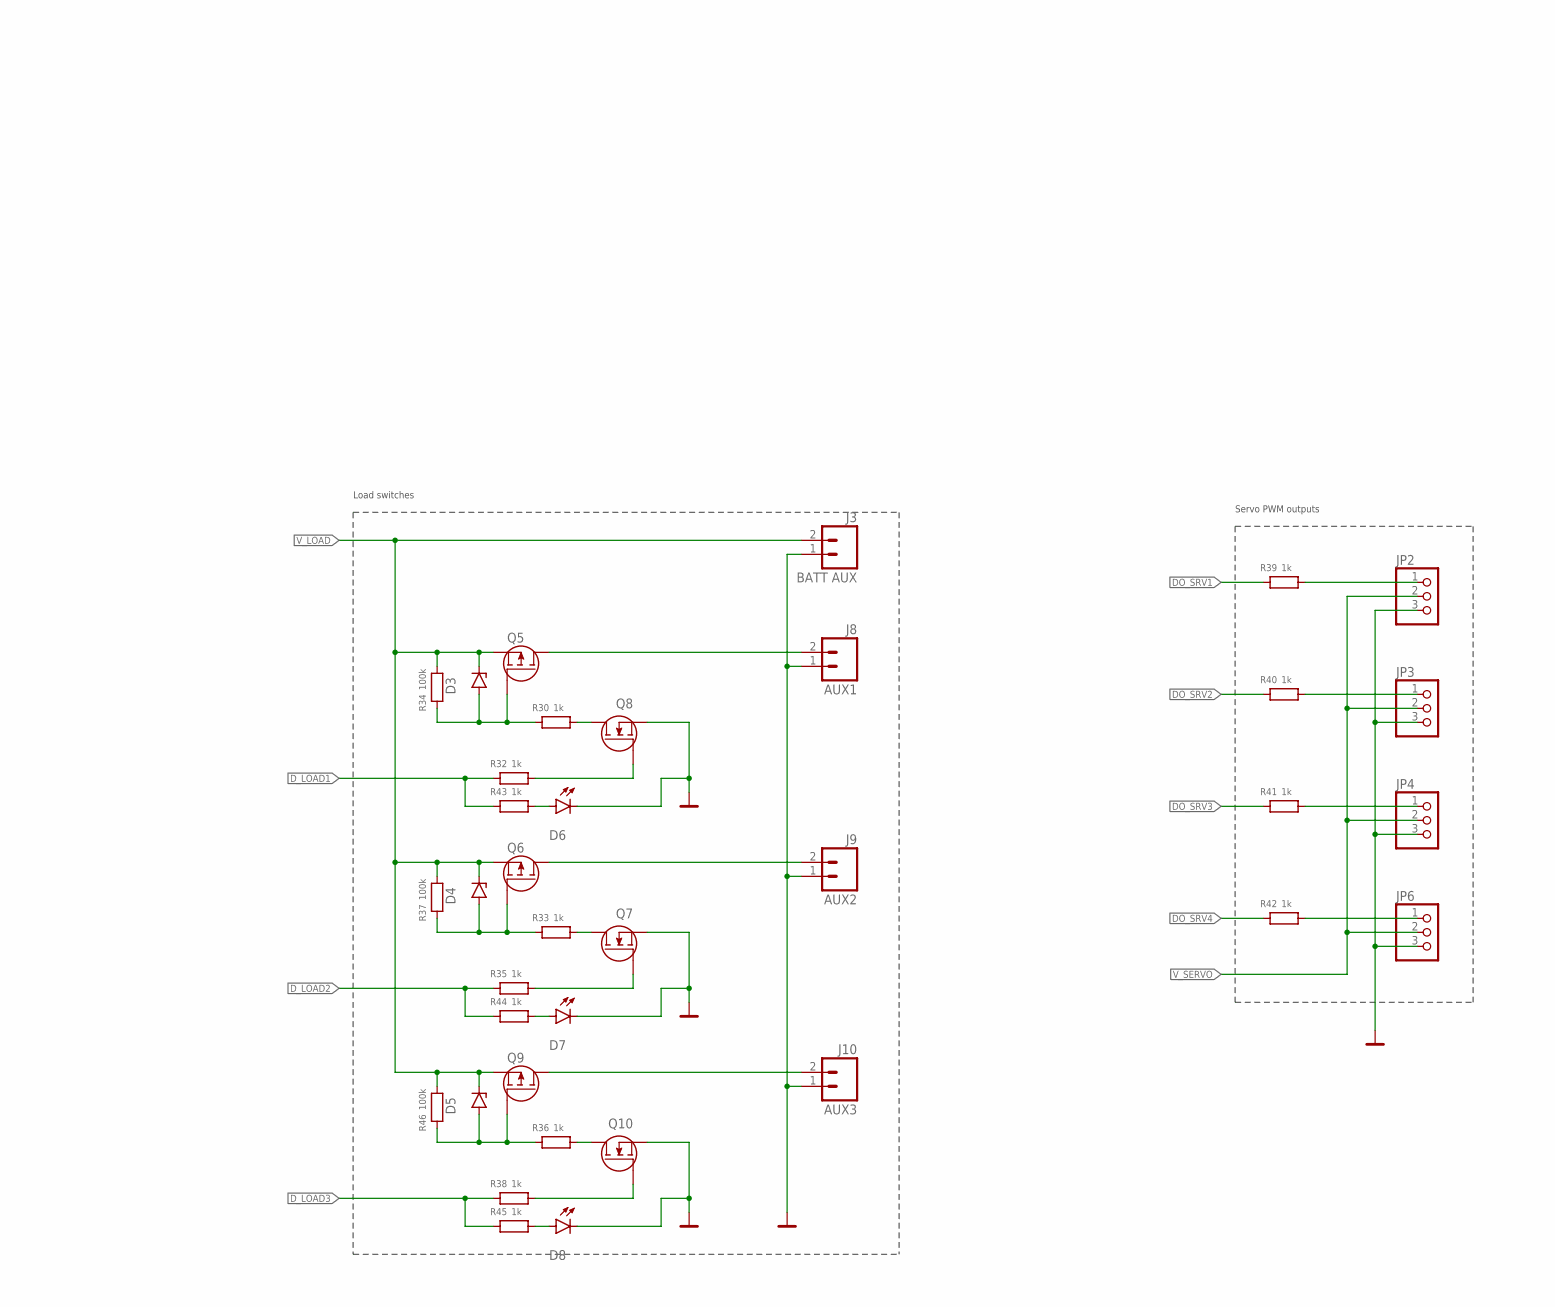
[picture p27: schematic tracker-balloon-full.sch, part in row 2, column 3]

Parts:
C1: 10n; C603
C2: 10u; EIA3216
C3, C6, C7, C9, C10, C13, C14, C15, C19: 100n; C603
C4, C5, C8, C11, C16, C17, C18: 1u; C603
C12: CPOL-EUE3.5-8; E3,5-8
D1, D6, D7, D8, D9, D10, D11, D12, D13, D14: LED0805; R0805
D3, D4, D5: DIODE-ZENER-SOD323; SOD-323
FB1, FB3: FERRITE_0805; _0805
J1: BATT; JST-2-PTH-VERT
J2: USB_MINI-B_SMT; USB-MINIB
J3: BATT AUX; SCREWTERMINAL-3.81MM-2
J4: SWD; JST-4-PTH-VERT
J5: MICRO-SD_CARD_SOCKET; MICRO-SD-SOCKET
J6: UART; JST-3-PTH-VERT
J7: BATT GSM; JST-2-PTH-VERT
J8: AUX1; SCREWTERMINAL-3.81MM-2
J9: AUX2; SCREWTERMINAL-3.81MM-2
J10: AUX3; SCREWTERMINAL-3.81MM-2
J11, J12: M2-3.81MM; SCREWTERMINAL-3.81MM-2
J13: INTERN; MICROMATCH-4
J14: THERMO; JST-3-PTH-VERT
J15: EXTERN; MICROMATCH-6
JP2, JP3, JP4, JP6: PINHD-1X3; 1X03
L1A: L-0603; R0603
M1: UBLOX-NEO-M8; UBLOX-NEO
M2: HOPE-RFM98W; HOPE-RFM
M3: SIM800L-MODULE; SIM800L
M4: UBLOX-MAX-M8; UBLOX-MAX
Q1, Q2, Q3, Q4, Q7, Q8, Q10, Q12: MOSFET-N-SOT23-3; SOT23-3
Q5, Q6, Q9, Q11: MOSFET-P-SOT23-3; SOT23-3
R1, R6, R7, R17, R18, R19, R26, R28, R29, R30, R31, R32, R33, R35, R36, R38, R39, R40, R41, R42, R43, R44, R45, R48, R50, R52, R53, R54, R55, R56: 1k; R0603
R2, R9, R14, R20, R51: 10k; R0603
R3, R4: 4k7; R0603
R5, R10, R11, R13, R16, R21, R22, R23, R24, R25, R27, R34, R37, R46, R47, R49: 100k; R0603
R8, R15: 3.3k; R0603
R12: 22; R0603
R57: 100; R0603
SV1: ML6
U1: MS5637-02; MS5637
U2, U6: VREG-5PIN-SOT23; SOT23-5
U3: A25L010A; SOP08
U4: MAG3110FCR1; DFN200X200X90-10N
U5: LSM6DS33; TFLGA16L
U7, U8: MCP73831; SOT23-5
U9: STM32L072R; LQFP64
X2, X3, X5: SMACONNECTOR; SMA90_DIP
X4: ANTENNA-PATCH-12X12; ANT-PATCH-12X12

Connections:
3.3V: C2.A (+), C3.2, C5.2, C7.2, C15.2, FB1.2, FB3.1, J5.VCC, R3.2, R4.2, R5.1, R9.2, R12.2, R14.2, R27.2, R31.1, U1.1 (VDD), U2.5 (OUT), U3.3 (WP), U3.7 (HOLD), U3.8 (VCC), U4.2 (VDD), U4.8 (VDDIO), U5.1 (VDD_IO), U5.4 (SDO), U5.5 (CS), U5.16 (VDD)
!FLASH_CS: J5.CS (!CS), R14.1, U3.1 (CS)
!GSM_RST: M3.3 (!RST)
!RFM_RST: M2.6 (!RESET)
!RFM_SS: M2.5 (!SS)
!RST: C1.2, J4.2, R9.1
ARM_SENSE: R26.2
BUZZER_ON: R2.2, R7.1
DBG_RX: J6.2
DBG_TX: J6.3
DO_SRV1: R39.1
DO_SRV2: R40.1
DO_SRV3: R41.1
DO_SRV4: R42.1
D_LOAD1: R32.1, R43.1
D_LOAD2: R35.1, R44.1
D_LOAD3: R38.1, R45.1
GND: C1.1, C2.C (-), C3.1, C4.1, C5.1, C6.1, C7.1, C8.1, C9.1, C10.1, C11.1, C12.-, C13.1, C14.1, C15.1, C16.1, C17.1, C18.1, C19.1, D1.2 (C), D6.2 (C), D7.2 (C), D8.2 (C), D9.2 (C), D10.2 (C), J1.1, J2.GND, J3.1, J4.1, J5.GND, J5.GND1 (SHIELD), J5.GND3 (SHIELD), J6.1, J7.1, J8.1, J9.1, J10.1, JP2.3, JP3.3, JP4.3, JP6.3, L1A.1, M1.7 (VDDUSB), M1.10 (GND), M1.12 (GND), M1.13 (GND), M1.22 (V_BCKP), M1.24 (GND), M2.1 (GND1), M2.8 (GND2), M2.10 (GND3), M3.6 (GND), M4.1 (GND), M4.6 (V_BCKP), M4.10 (GND), M4.12 (GND), Q1.2 (S), Q4.2 (S), Q7.2 (S), Q8.2 (S), Q10.2 (S), Q12.2 (S), R2.1, R13.1, R23.1, R24.1, R25.1, R49.1, R50.1, R51.1, R54.1, R55.1, U1.4 (GND), U2.2 (GND), U3.4 (GND), U4.5 (GND_2), U4.10 (GND), U5.8 (RES1), U5.9 (RES2), U5.10 (RES3), U5.11 (RES4), U5.12 (GND1), U5.13 (GND2), U5.15 (RES5), U6.2 (GND), U7.2 (VSS), U8.2 (VSS), X2.GND1, X2.GND2, X2.GND3, X2.GND4, X3.GND1, X3.GND2, X3.GND3, X3.GND4, X5.GND1, X5.GND2, X5.GND3, X5.GND4
GPS_PPS: M1.3 (TIMEPULSE), M4.4 (TIMEPULSE)
GPS_RXD: M1.20 (TXD/MISO), M4.2 (TXD)
GPS_TXD: M1.21 (RXD/MOSI), M4.3 (RXD)
GPS_VCC: C9.2, FB3.2, M1.2 (D_SEL), M1.23 (VCC), M4.7 (VCC_IO), M4.8 (VCC), R15.2
GSM_ON: R48.1, R49.2
GSM_RXD: M3.5 (TXD)
GSM_TXD: M3.4 (RXD)
LED_STATUS: R6.2
MISO: J5.DO, M2.2 (MISO), U3.2 (SO)
MOSI: J5.DI, M2.3 (MOSI), U3.5 (SI)
unnamed: L1A.2, M1.11 (RF_IN), M4.11 (RF_IN), X3.ANTENNA (ANT), X4.FEED
unnamed: C11.2, R12.1, U6.1 (IN), U6.3 (EN)
unnamed: Q1.1 (G), R7.2
unnamed: Q12.1 (G), R48.2
unnamed: C6.2, FB1.1, M2.13 (3.3V)
unnamed: M1.8 (!RESET), R8.1
unnamed: M1.9 (VCC_RF), R8.2
unnamed: C8.2, U2.4 (BP)
unnamed: D11.2 (C), Q2.2 (S), Q3.2 (S), Q4.3 (D)
unnamed: D1.1 (A), R6.1
unnamed: Q2.1 (G), R19.2
unnamed: C13.2, U4.1 (CAP-A)
unnamed: C14.2, U4.4 (CAP-R)
unnamed: M4.9 (!RESET), R15.1
unnamed: Q3.1 (G), R1.2
unnamed: M3.1 (ANT), X5.ANTENNA (ANT)
unnamed: D12.2 (C), R50.2
unnamed: J2.D-, R28.2
unnamed: Q4.1 (G), R5.2, R20.1, R26.1
unnamed: J2.D+, R29.2
unnamed: M2.9 (ANT), X2.ANTENNA (ANT)
unnamed: JP6.1, R42.2
unnamed: D3.A, Q5.1 (G), R30.1, R34.1
unnamed: Q8.3 (D), R30.2
unnamed: Q8.1 (G), R32.2
unnamed: J8.2, Q5.3 (D)
unnamed: D6.1 (A), R43.2
unnamed: JP4.1, R41.2
unnamed: D4.A, Q6.1 (G), R33.1, R37.1
unnamed: Q7.3 (D), R33.2
unnamed: Q7.1 (G), R35.2
unnamed: J9.2, Q6.3 (D)
unnamed: JP3.1, R40.2
unnamed: JP2.1, R39.2
unnamed: D5.A, Q9.1 (G), R36.1, R46.1
unnamed: Q10.3 (D), R36.2
unnamed: Q10.1 (G), R38.2
unnamed: J10.2, Q9.3 (D)
unnamed: D9.1 (A), R17.2
unnamed: D8.1 (A), R45.2
unnamed: D7.1 (A), R44.2
unnamed: D10.1 (A), R18.2
unnamed: D11.1 (A), R31.2
unnamed: D12.1 (A), M3.2 (VCC), Q11.3 (D)
unnamed: Q11.1 (G), Q12.3 (D), R47.1
unnamed: M3.11 (DTR), R51.2
unnamed: D13.1 (A), R52.2
unnamed: D14.1 (A), R53.2
unnamed: D14.2 (C), U7.1 (STAT)
unnamed: D13.2 (C), U8.1 (STAT)
unnamed: R54.2, U8.5 (PRG)
unnamed: R55.2, U7.5 (PRG)
NTC_EXT: C19.2, R27.1, R56.2
NTC_SENSE: R56.1
PYRO1_ON: R17.1, R19.1
PYRO1_OUT: J11.1, Q2.3 (D), R21.1
PYRO1_SENSE: R21.2, R24.2
PYRO2_ON: R1.1, R18.1
PYRO2_OUT: J12.1, Q3.3 (D), R22.1
PYRO2_SENSE: R22.2, R25.2
RFM_DIO0: M2.14 (DIO0)
SAFE: R20.2
SCK: J5.SCLK (SCK), M2.4 (SCK), U3.6 (SCK)
SCL: R3.1, U1.3 (SCL), U4.7 (SCL), U5.2 (SCL)
SDA: R4.1, U1.2 (SDA), U4.6 (SDA), U5.3 (SDA)
SHDN: R10.1, U2.3 (EN)
SWCLK: J4.3
SWDIO: J4.4
USB_DM: R28.1, U9.44 (PA11)
USB_DP: R29.1, U9.45 (PA12)
VCC_PYRO: C12.+, J11.2, J12.2, R16.1, U6.5 (OUT)
V_BATT: C4.2, C17.2, J1.2, R10.2, R11.2, R57.2, U2.1 (IN), U8.3 (BAT)
V_BATT_SENSE: C10.2, R11.1, R13.2
V_BUZZER+: R57.1
V_BUZZER-: Q1.3 (D)
V_GSM: C18.2, J7.2, Q11.2 (S), R47.2, U7.3 (BAT)
V_LOAD: D3.C, D4.C, D5.C, J3.2, Q5.2 (S), Q6.2 (S), Q9.2 (S), R34.2, R37.2, R46.2
V_PYRO_SENSE: R16.2, R23.2
V_SERVO: JP2.2, JP3.2, JP4.2, JP6.2
V_USB: C16.2, J2.VBUS, R52.1, R53.1, U7.4 (VDD), U8.4 (VDD)

Notes on the sheet:
75uA in Inactive State 15uA Backup battery current
0.2uA in Standby Mode 1.5uA in Idle Mode
Barometer (optional)
SPI Flash (optional)
Servo PWM outputs
Load switches
ARMED
P2 ACT
P1 ACT
GSM ON

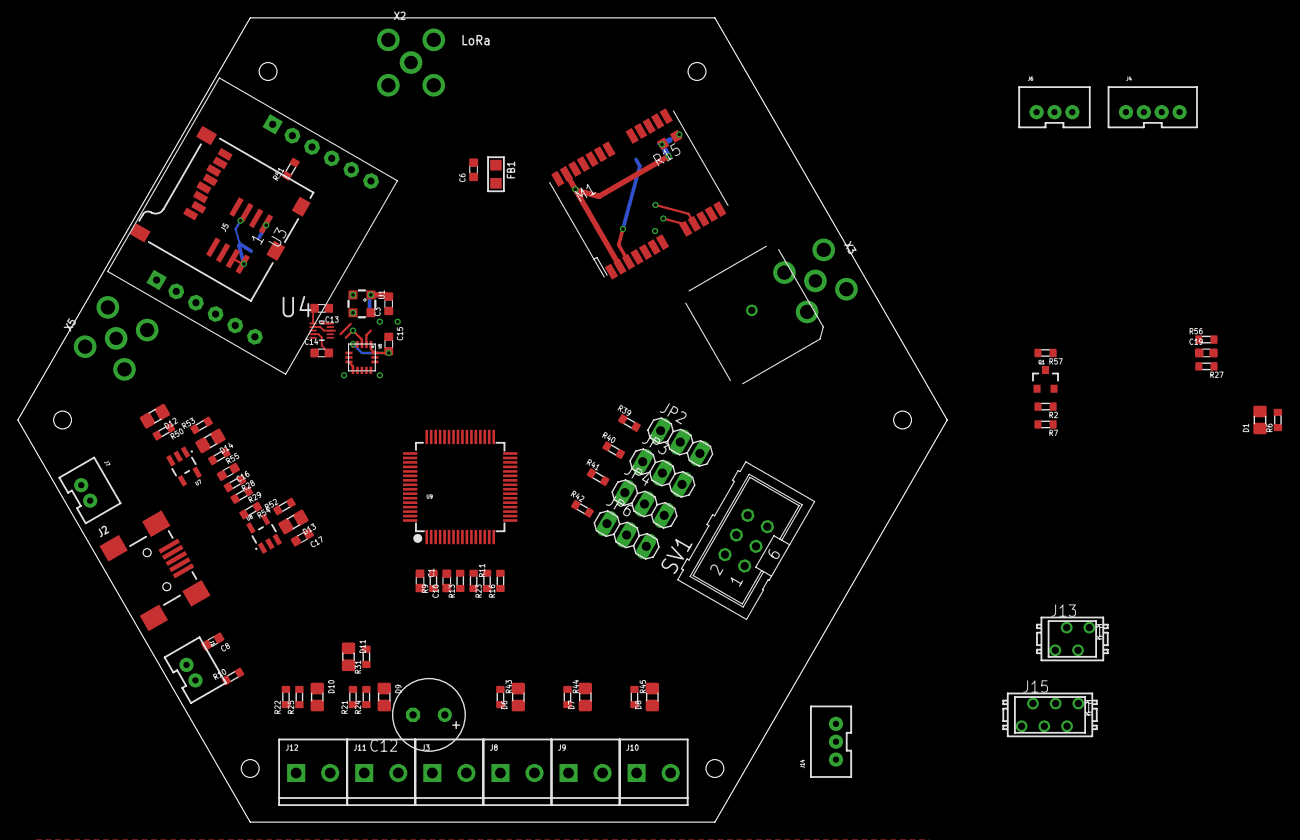
[picture p28: board tracker-balloon-full.brd from above]

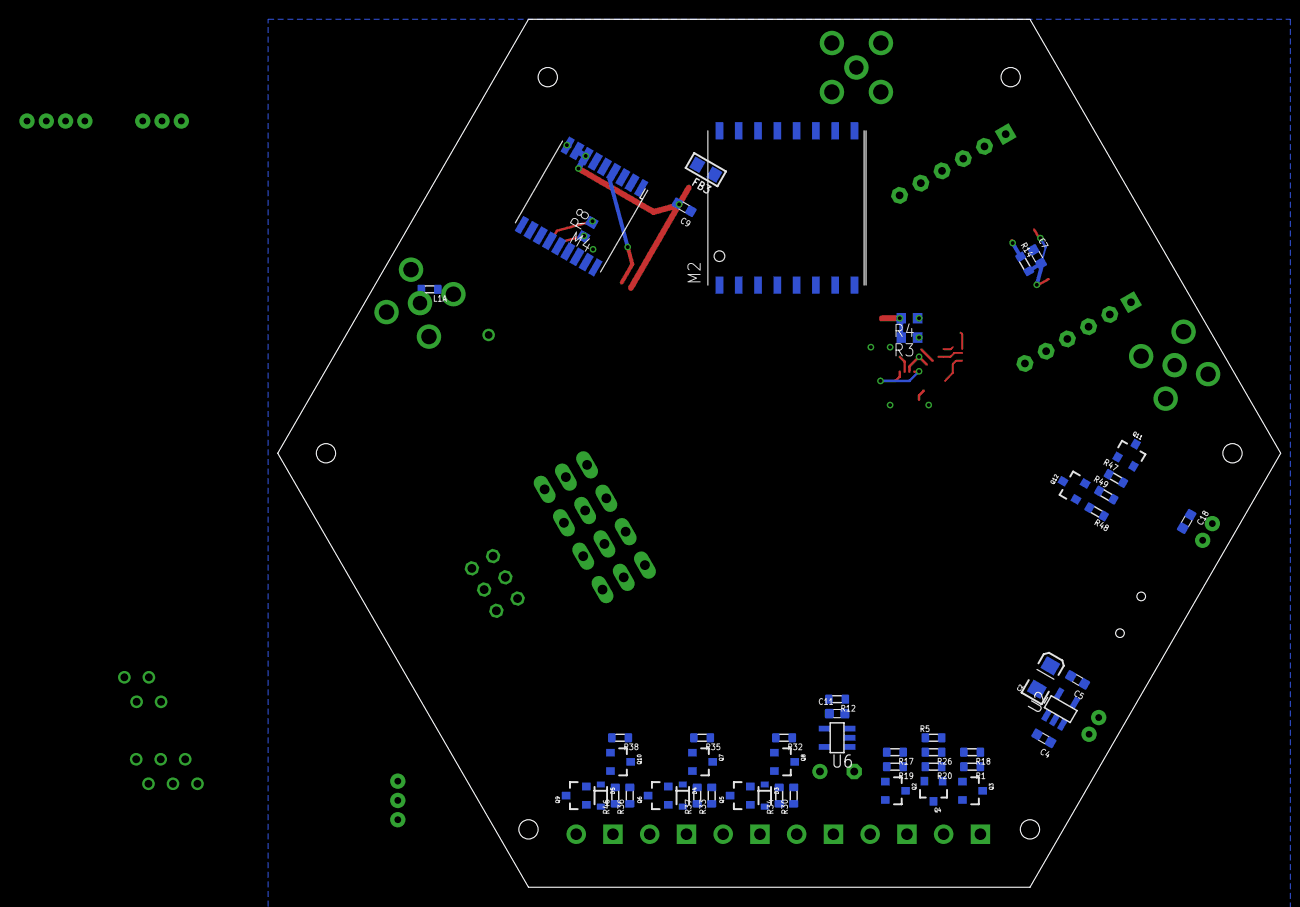
[picture p29: board tracker-balloon-full.brd from below]

Board: 2 copper layers, 104.0 x 90.0 mm, 141 parts (51 on the bottom side), 88 nets.
