kgoba/zinoo/eagle/tracker/tracker-25mm.brd

## EAGLE design eagle/tracker/tracker-25mm.brd (2018-02-11)

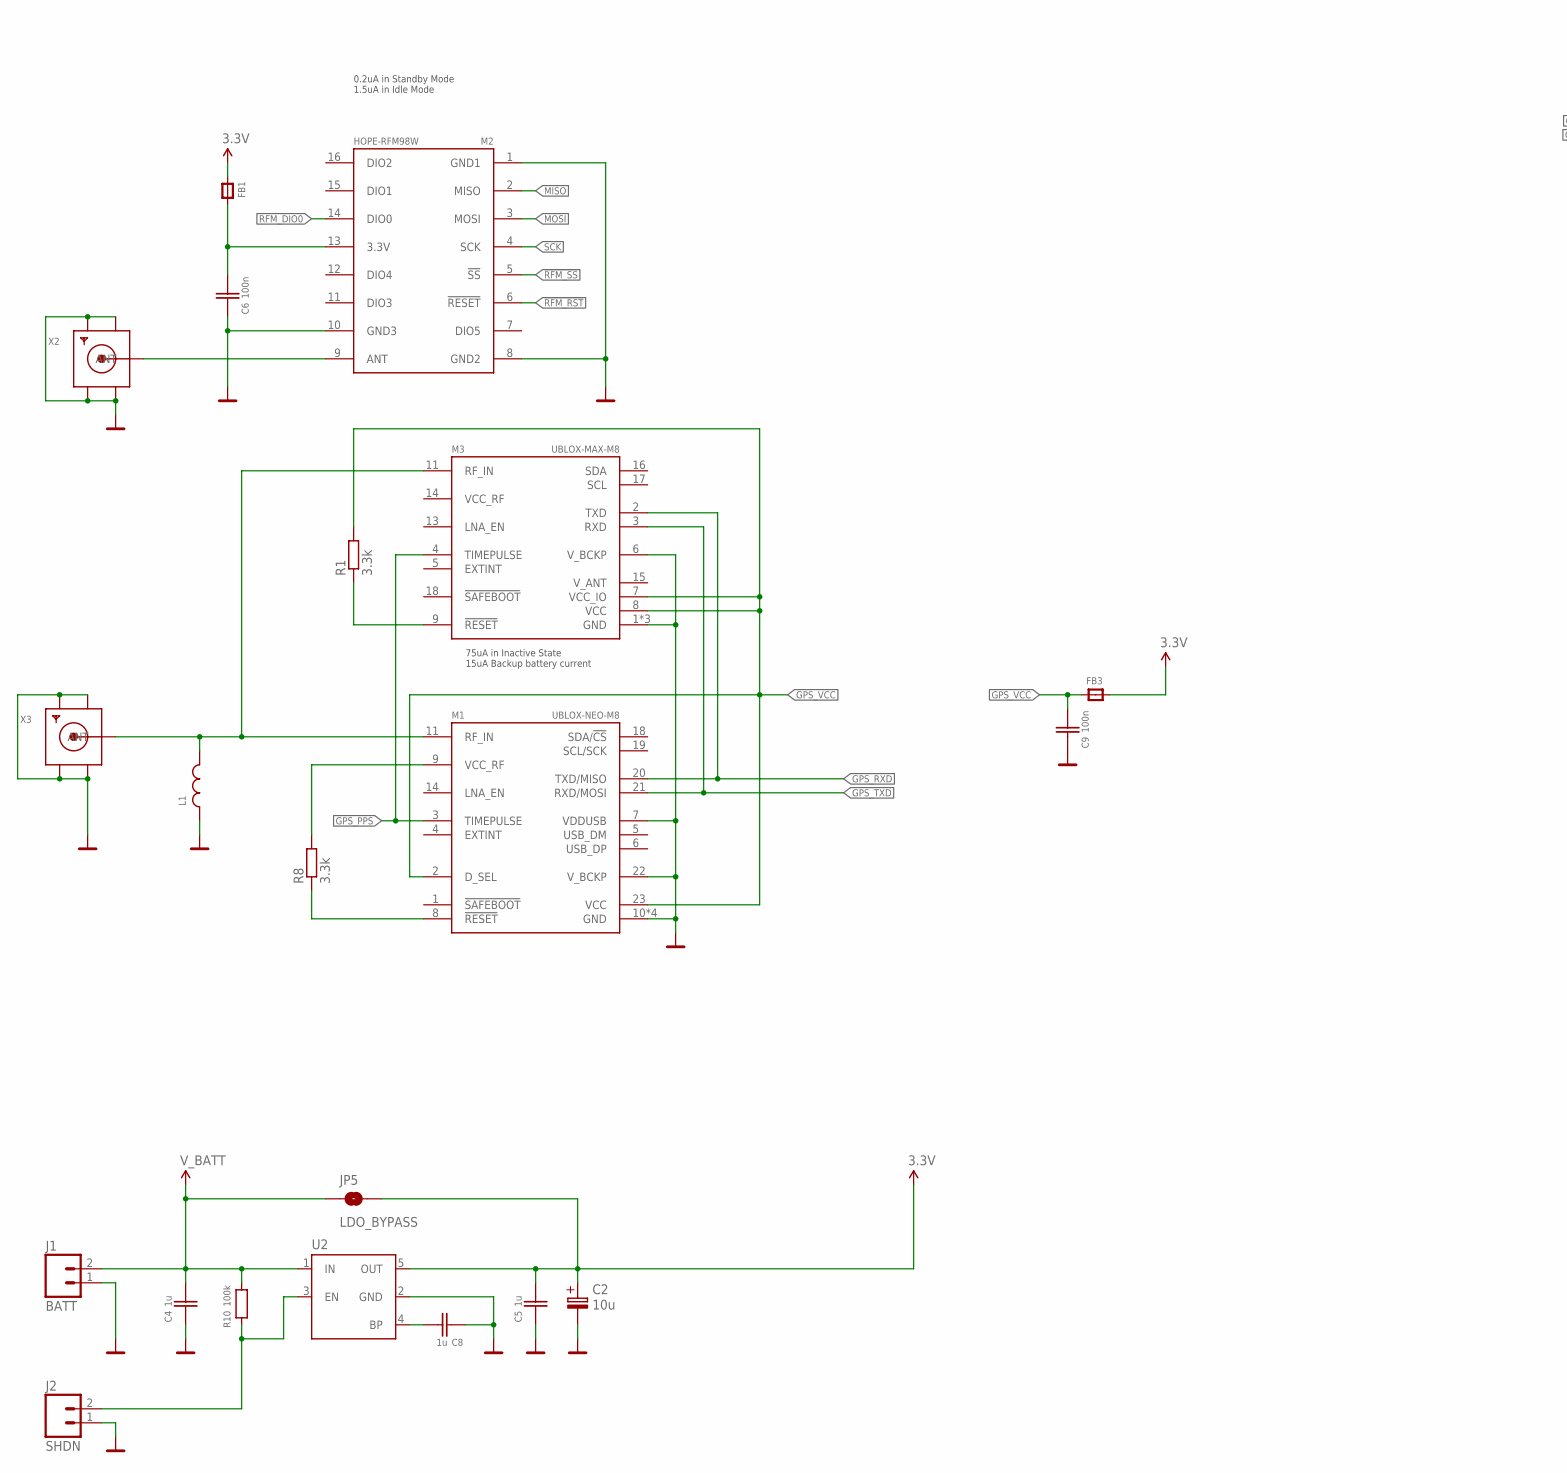
[picture p30: schematic tracker-25mm.sch, part in row 1, column 1]

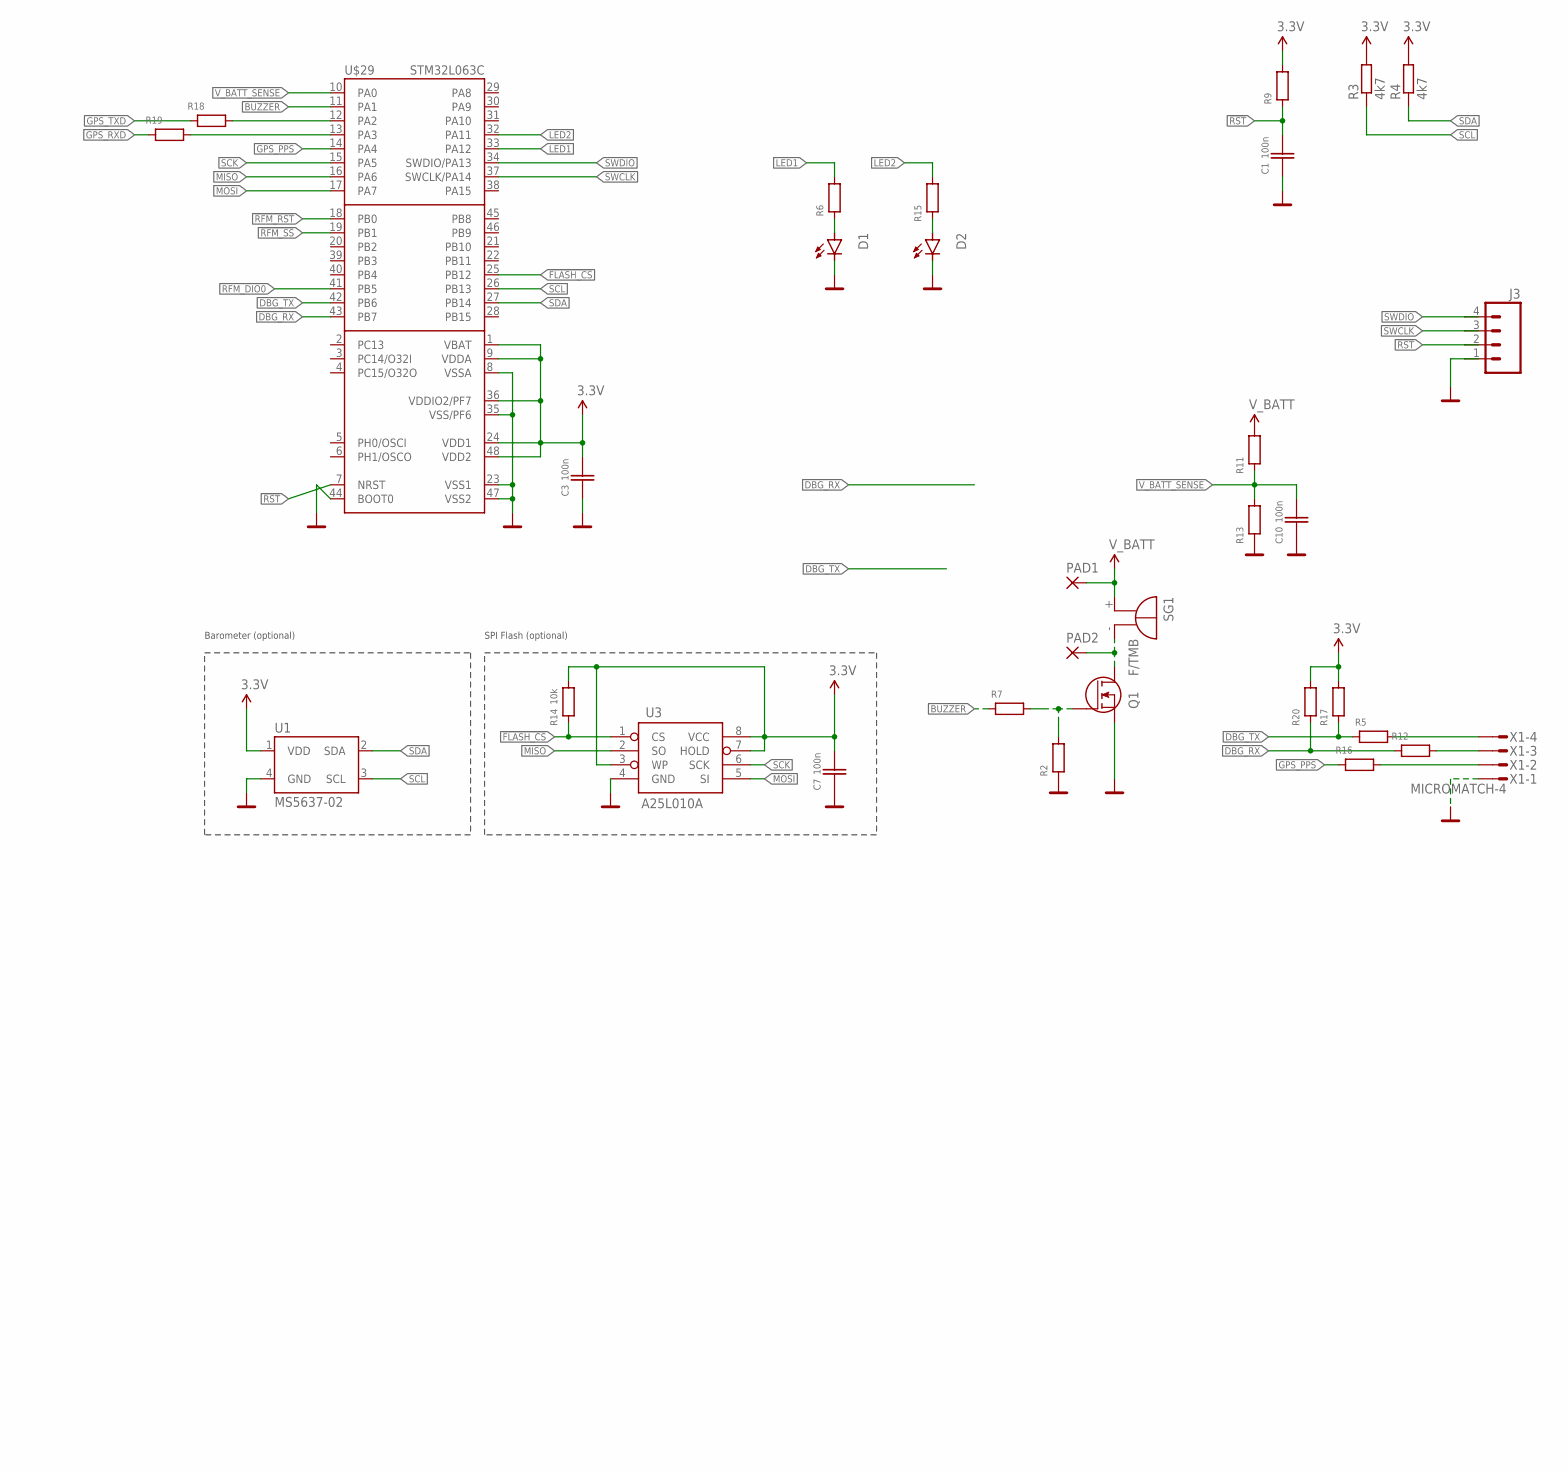
[picture p31: schematic tracker-25mm.sch, part in row 1, column 2]

Parts:
C1, C3, C6, C7, C9, C10: 100n; C603
C2: 10u; EIA3216
C4, C5, C8: 1u; C603
D1, D2: LED0805; R0805
FB1, FB3: FERRITE_0805; _0805
J1: BATT; JST-2-PTH-VERT
J2: SHDN; JST-2-PTH-VERT
J3: M4-CT-V; JST-4-PTH-VERT
JP5: LDO_BYPASS; PAD-JUMPER-2-NO_YES_SILK
L1: L-0805; R0805
M1: UBLOX-NEO-M8; UBLOX-NEO
M2: HOPE-RFM98W; HOPE-RFM
M3: UBLOX-MAX-M8; UBLOX-MAX
PAD1, PAD2: SMD5; SMD2,54-5,08
Q1: MOSFET-N-SOT23-3; SOT23-3
R1, R8: 3.3k; R0603
R2, R5, R6, R7, R9, R11, R12, R13, R15, R16, R17, R18, R19, R20: RESISTOR-0603; R0603
R3, R4: 4k7; R0603
R10: 100k; R0603
R14: 10k; R0603
SG1: F/TMB
U1: MS5637-02; MS5637
U2: VREG-5PIN-SOT23; SOT23-5
U3: A25L010A; SOP08
U$29: STM32L063C; LQFP48
X1: MICROMATCH-4
X2, X3: SMACONNECTOR_EDGE; SMA_EDGELAUNCH

Connections:
3.3V: C2.A (+), C3.2, C5.2, C7.2, FB1.2, FB3.1, JP5.2, R3.2, R4.2, R9.2, R14.2, R17.2, R20.2, U1.1 (VDD), U2.5 (OUT), U3.3 (WP), U3.7 (HOLD), U3.8 (VCC), U$29.1 (VBAT), U$29.9 (VDDA), U$29.24 (VDD1), U$29.36 (VDDIO2/PF7), U$29.48 (VDD2)
!FLASH_CS: R14.1, U3.1 (CS), U$29.25 (PB12)
!RFM_RST: M2.6 (!RESET), U$29.18 (PB0)
!RFM_SS: M2.5 (!SS), U$29.19 (PB1)
!RST: C1.2, J3.2, R9.1, U$29.7 (NRST)
BUZZER: R7.1, U$29.11 (PA1)
DBG_RX: R12.1, R20.1, U$29.43 (PB7)
DBG_TX: R5.1, R17.1, U$29.42 (PB6)
GND: C1.1, C2.C (-), C3.1, C4.1, C5.1, C6.1, C7.1, C8.1, C9.1, C10.1, D1.2 (C), D2.2 (C), J1.1, J2.1, J3.1, L1.1, M1.7 (VDDUSB), M1.10 (GND), M1.12 (GND), M1.13 (GND), M1.22 (V_BCKP), M1.24 (GND), M2.1 (GND1), M2.8 (GND2), M2.10 (GND3), M3.1 (GND), M3.6 (V_BCKP), M3.10 (GND), M3.12 (GND), Q1.2 (S), R2.1, R13.1, U1.4 (GND), U2.2 (GND), U3.4 (GND), U$29.8 (VSSA), U$29.23 (VSS1), U$29.35 (VSS/PF6), U$29.44 (BOOT0), U$29.47 (VSS2), X1.1, X2.GND@1 (GND4), X2.GND@2 (GND3), X2.GND@3 (GND2), X2.GND@4 (GND1), X3.GND@1 (GND4), X3.GND@2 (GND3), X3.GND@3 (GND2), X3.GND@4 (GND1)
GPS_PPS: M1.3 (TIMEPULSE), M3.4 (TIMEPULSE), R16.1, U$29.14 (PA4)
GPS_RXD: M1.20 (TXD/MISO), M3.2 (TXD), R19.1
GPS_TXD: M1.21 (RXD/MOSI), M3.3 (RXD), R18.1
GPS_VCC: C9.2, FB3.2, M1.2 (D_SEL), M1.23 (VCC), M3.7 (VCC_IO), M3.8 (VCC), R1.2
LED1: R6.2, U$29.33 (PA12)
LED2: R15.2, U$29.32 (PA11)
MISO: M2.2 (MISO), U3.2 (SO), U$29.16 (PA6)
MOSI: M2.3 (MOSI), U3.5 (SI), U$29.17 (PA7)
unnamed: L1.2, M1.11 (RF_IN), M3.11 (RF_IN), X3.P (ANT)
unnamed: M3.9 (!RESET), R1.1
unnamed: Q1.1 (G), R2.2, R7.2
unnamed: PAD2.1, Q1.3 (D), SG1.-
unnamed: C6.2, FB1.1, M2.13 (3.3V)
unnamed: M1.8 (!RESET), R8.1
unnamed: M1.9 (VCC_RF), R8.2
unnamed: C8.2, U2.4 (BP)
unnamed: J2.2, R10.1, U2.3 (EN)
unnamed: D1.1 (A), R6.1
unnamed: R12.2, X1.3
unnamed: R5.2, X1.4
unnamed: D2.1 (A), R15.1
unnamed: R18.2, U$29.12 (PA2)
unnamed: R16.2, X1.2
unnamed: R19.2, U$29.13 (PA3)
unnamed: M2.9 (ANT), X2.P (ANT)
RFM_DIO0: M2.14 (DIO0), U$29.41 (PB5)
SCK: M2.4 (SCK), U3.6 (SCK), U$29.15 (PA5)
SCL: R3.1, U1.3 (SCL), U$29.26 (PB13)
SDA: R4.1, U1.2 (SDA), U$29.27 (PB14)
SWCLK: J3.3, U$29.37 (SWCLK/PA14)
SWDIO: J3.4, U$29.34 (SWDIO/PA13)
V_BATT: C4.2, J1.2, JP5.1, PAD1.1, R10.2, R11.2, SG1.+, U2.1 (IN)
V_BATT_SENSE: C10.2, R11.1, R13.2, U$29.10 (PA0)

Notes on the sheet:
75uA in Inactive State 15uA Backup battery current
0.2uA in Standby Mode 1.5uA in Idle Mode
Barometer (optional)
SPI Flash (optional)

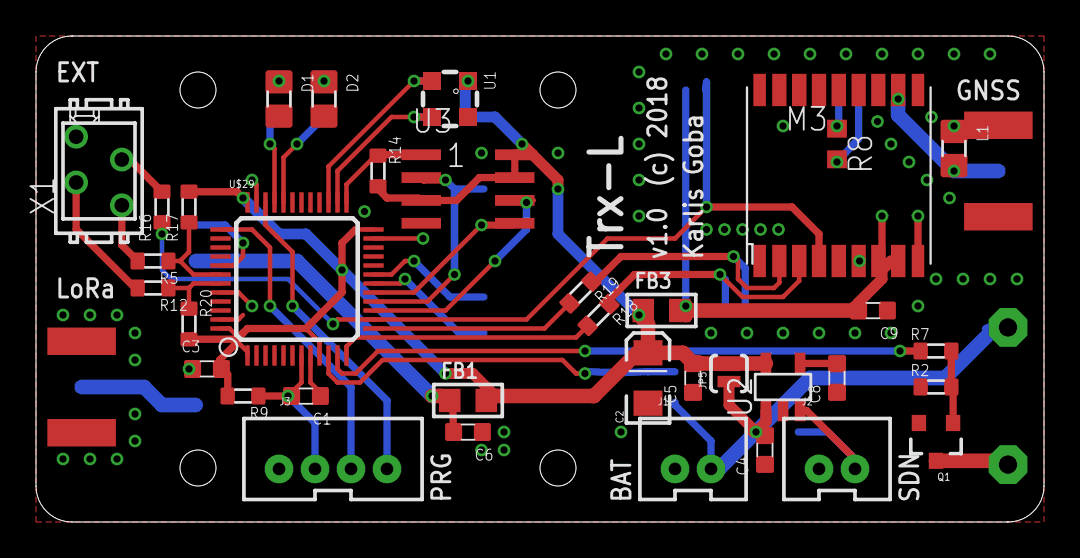
[picture p32: board tracker-25mm.brd from above]

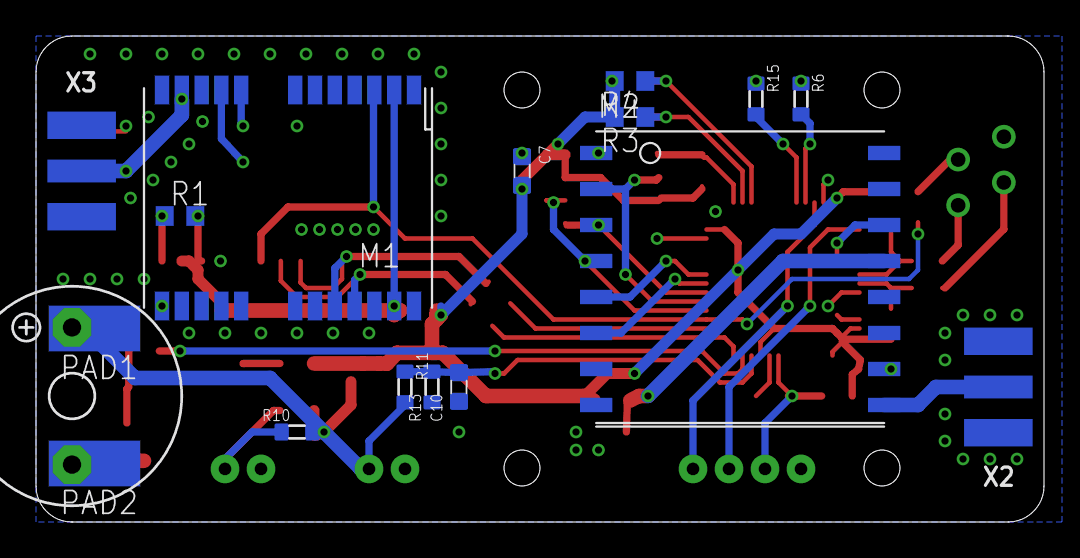
[picture p33: board tracker-25mm.brd from below]

Board: 2 copper layers, 56.0 x 27.0 mm, 53 parts (17 on the bottom side), 42 nets.
