kgoba/zinoo/eagle/tracker/tracker-uno-v1.brd

## EAGLE design eagle/tracker/tracker-uno-v1.brd (2018-02-09)

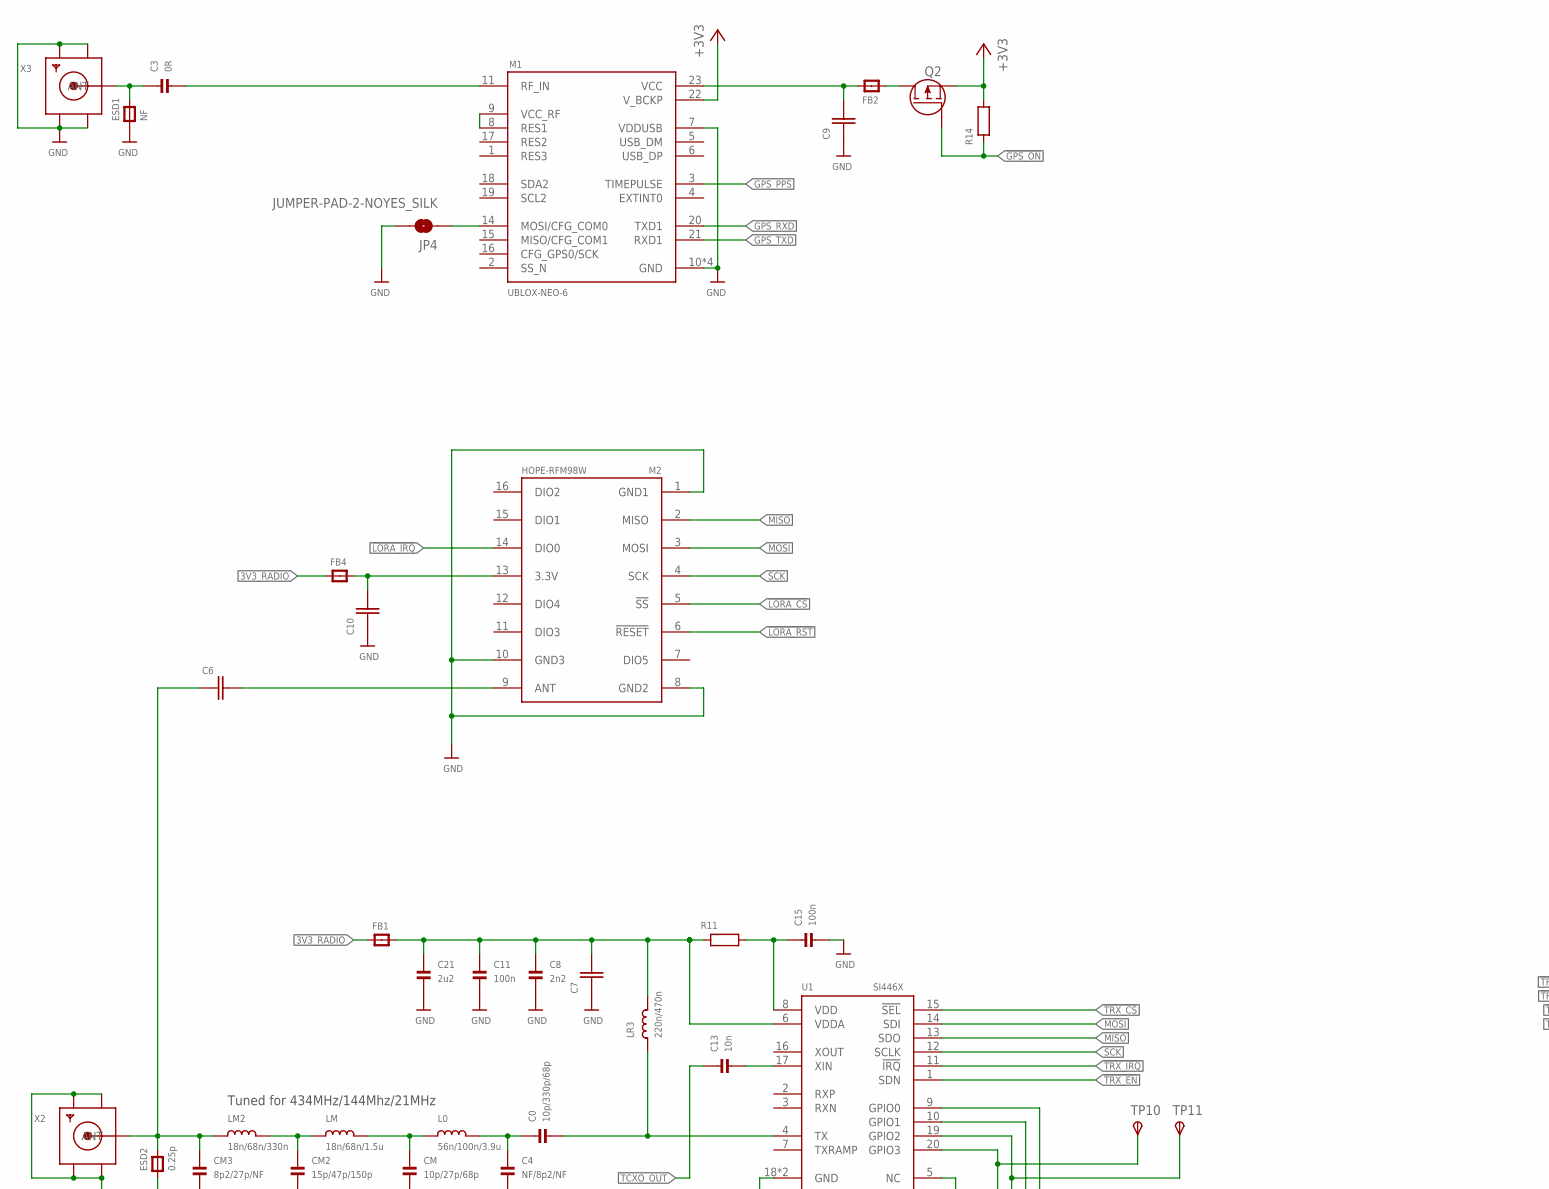
[picture p34: schematic tracker-uno-v1.sch, part in row 1, column 1]

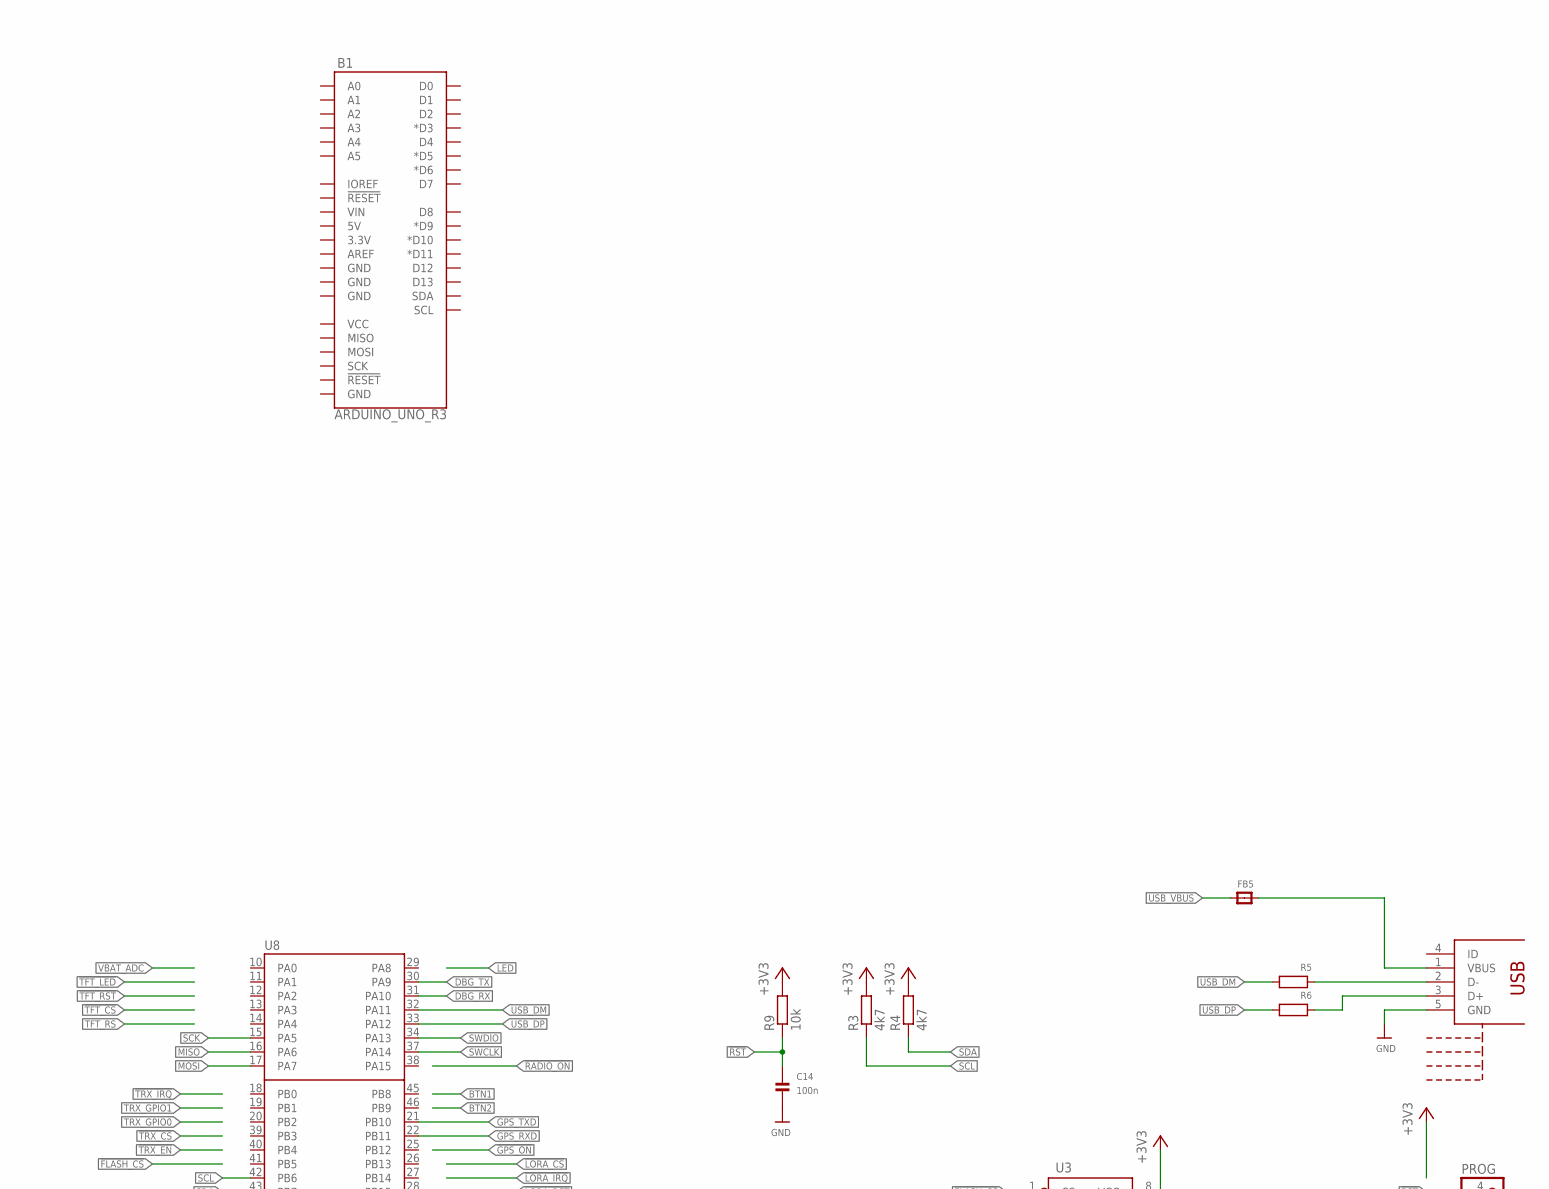
[picture p35: schematic tracker-uno-v1.sch, part in row 1, column 2]

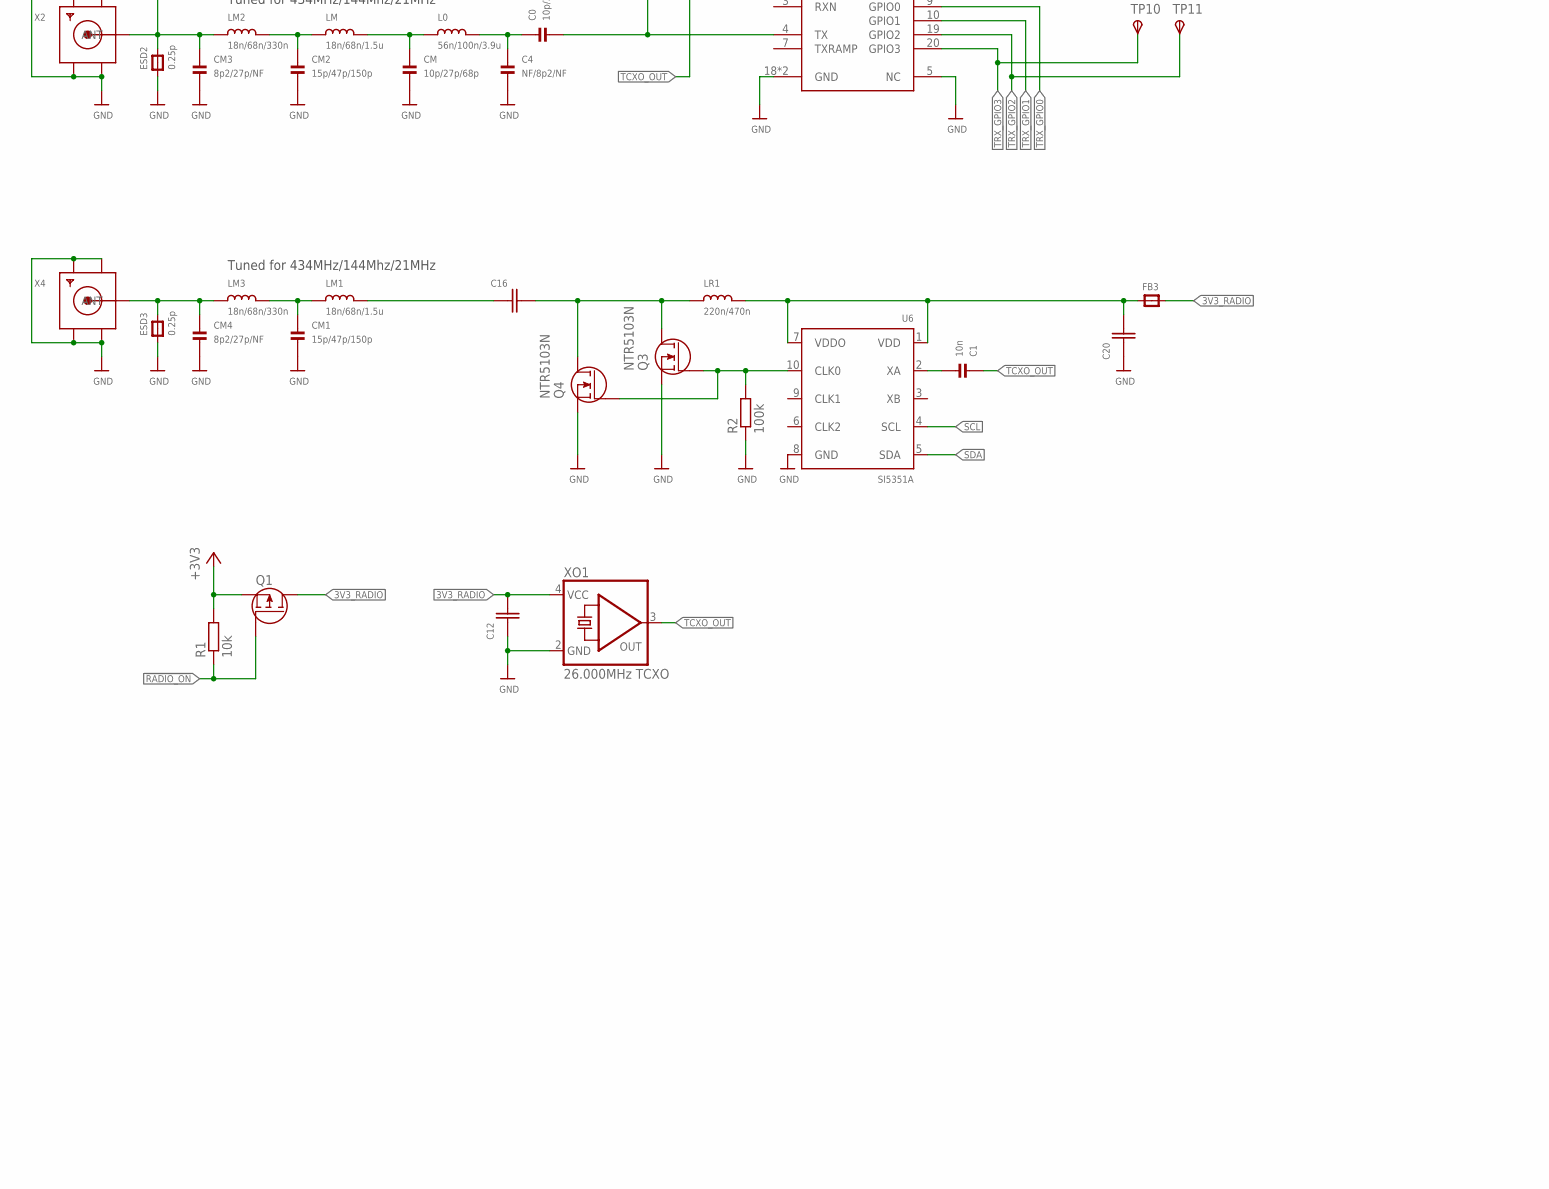
[picture p36: schematic tracker-uno-v1.sch, part in row 2, column 1]

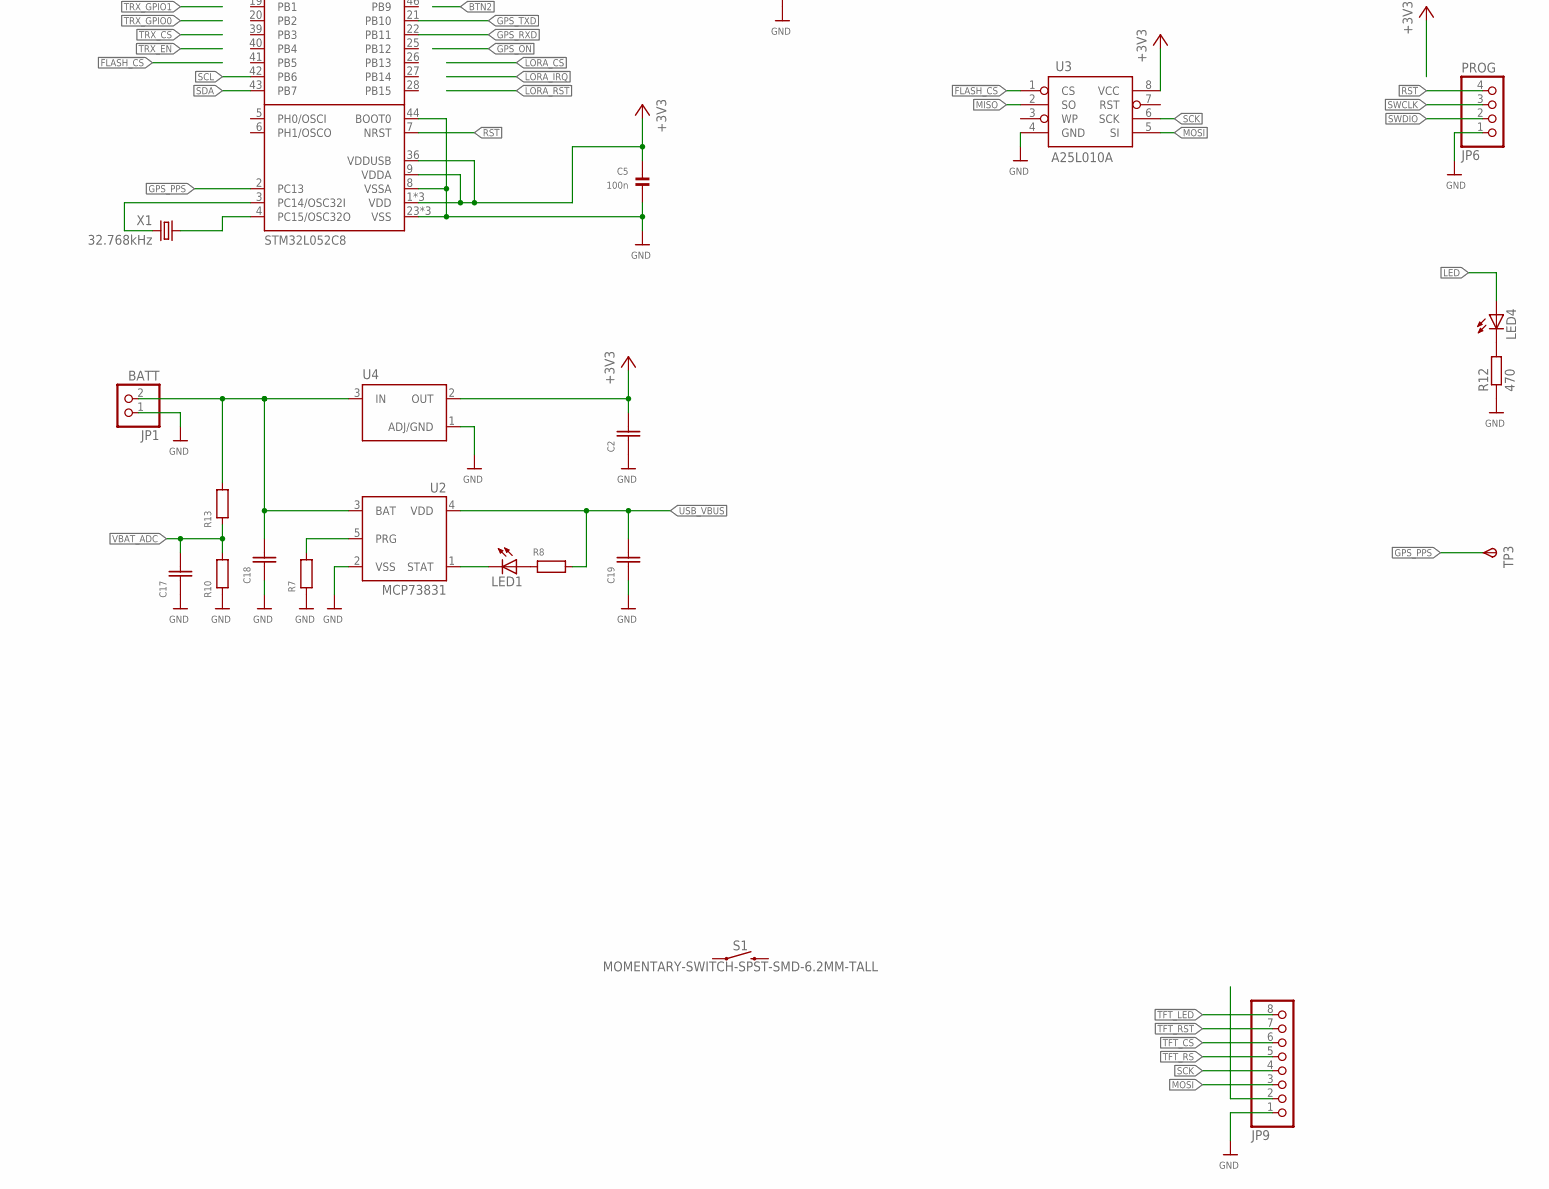
[picture p37: schematic tracker-uno-v1.sch, part in row 2, column 2]

Parts:
B1: ARDUINO_UNO_R3; ARDUINO_R3
C0: 10p/330p/68p; _0603MP
C1, C13: 10n; _0603MP
C2, C6, C7, C9, C10, C12, C16, C17, C18, C19, C20: CAPACITOR_NPOL-0603; C603
C3: 0R; _0603MP
C4: NF/8p2/NF; _0603MP
C5, C11, C14, C15: 100n; _0603MP
C8: 2n2; _0603MP
C21: 2u2; _0603MP
CM: 10p/27p/68p; _0603MP
CM1, CM2: 15p/47p/150p; _0603MP
CM3, CM4: 8p2/27p/NF; _0603MP
ESD1: NF; _0603MP
ESD2, ESD3: 0.25p; _0603MP
FB1, FB2, FB3, FB4, FB5: FERRITE_0805; _0805
JP1: BATT; 1X02
JP4: JUMPER-PAD-2-NOYES_SILK; PAD-JUMPER-2-NO_YES_SILK
JP6: PROG; 1X04
JP9: PINHD-1X8; 1X08
L0: 56n/100n/3.9u; _0805MP
LED1, LED4: LEDCHIPLED_0805; CHIPLED_0805
LM, LM1: 18n/68n/1.5u; _0805MP
LM2, LM3: 18n/68n/330n; _0805MP
LR1, LR3: 220n/470n; _0805MP
M1: UBLOX-NEO-6
M2: HOPE-RFM98W; HOPE-RFM
Q1, Q2: MOSFET-P-SOT23-3; SOT23-3
Q3, Q4: NTR5103N; SOT23-3
R1, R9: 10k; R0603
R2: 100k; R0603
R3, R4: 4k7; R0603
R5, R6, R7, R8, R10, R11, R13, R14: RESISTOR-0603; R0603
R12: 470; R0603
S1: MOMENTARY-SWITCH-SPST-SMD-6.2MM-TALL; TACTILE_SWITCH_SMD_6.2MM_TALL
TP3, TP10, TP11: TPSB1,27; B1,27
U1: SI446X; QFN20
U2: MCP73831; SOT23-5
U3: A25L010A; SOP08
U4: VREG-3PIN-SOT23; SOT23-3
U6: SI5351A; MSOP10
U8: STM32L052C8; LQFP48
U$42: MINI-USB-B; MINI-B-USB
X1: 32.768kHz; 3.2X1.5-2-PAD
X2, X3, X4: SMACONNECTOR_EDGE; SMA_EDGELAUNCH
XO1: 26.000MHz TCXO; CRYSTAL-SMD-2.5X2

Connections:
3V3_RADIO: C7.2, C8.1, C11.1, C12.2, C21.1, FB1.1, FB1.2, FB3.1, FB4.2, LR3.2, Q1.3 (D), R11.1, U1.6 (VDDA), XO1.4 (VCC)
!FLASH_CS: U3.1 (CS)
!GPS_ON: Q2.1 (G), R14.1
!LORA_CS: M2.5 (!SS)
!LORA_IRQ: M2.14 (DIO0)
!LORA_RST: M2.6 (!RESET)
!RADIO_ON: Q1.1 (G), R1.1
!RST: C14.1, JP6.4, R9.1, U8.7 (NRST)
!TFT_CS: JP9.6
!TFT_LED: JP9.8
!TFT_RST: JP9.7
!TRX_CS: U1.15 (!SEL)
!TRX_EN: U1.1 (SDN)
!TRX_IRQ: U1.11 (!IRQ)
+3V3: C2.2, C5.1, M1.22 (V_BCKP), Q1.2 (S), Q2.2 (S), R1.2, R3.2, R4.2, R9.2, R14.2, U3.8 (VCC), U4.2 (OUT), U8.1 (VDD), U8.9 (VDDA), U8.24 (VDD), U8.36 (VDDUSB), U8.48 (VDD)
CHG_STATUS: LED1.C, U2.1 (STAT)
DBG_RX: U8.31 (PA10)
DBG_TX: U8.30 (PA9)
GND: C2.1, C4.2, C5.2, C7.1, C8.2, C9.1, C10.1, C11.2, C12.1, C14.2, C15.2, C17.1, C18.1, C19.1, C20.1, C21.2, CM.2, CM1.2, CM2.2, CM3.2, CM4.2, ESD1.1, ESD2.1, ESD3.1, JP1.1, JP4.2, JP6.1, JP9.1, M1.7 (VDDUSB), M1.10 (GND), M1.12 (GND), M1.13 (GND), M1.24 (GND), M2.1 (GND1), M2.8 (GND2), M2.10 (GND3), Q3.2 (S), Q4.2 (S), R2.1, R7.1, R10.1, R12.1, U1.5 (NC), U1.18 (GND), U1.PAD (GND), U2.2 (VSS), U3.4 (GND), U4.1 (ADJ/GND), U6.8 (GND), U8.8 (VSSA), U8.23 (VSS), U8.35 (VSS), U8.44 (BOOT0), U8.47 (VSS), U$42.5 (GND), X2.GND@1 (GND4), X2.GND@2 (GND3), X2.GND@3 (GND2), X2.GND@4 (GND1), X3.GND@1 (GND4), X3.GND@2 (GND3), X3.GND@3 (GND2), X3.GND@4 (GND1), X4.GND@1 (GND4), X4.GND@2 (GND3), X4.GND@3 (GND2), X4.GND@4 (GND1), XO1.2 (GND)
GPS_PPS: M1.3 (TIMEPULSE), TP3.TP, U8.2 (PC13)
GPS_RXD: M1.20 (TXD1), U8.22 (PB11)
GPS_TXD: M1.21 (RXD1), U8.21 (PB10)
LED: LED4.A
MISO: M2.2 (MISO), U1.13 (SDO), U3.2 (SO), U8.16 (PA6)
MOSI: JP9.3, M2.3 (MOSI), U1.14 (SDI), U3.5 (SI), U8.17 (PA7)
unnamed: Q3.1 (G), Q4.1 (G), R2.2, U6.10 (CLK0)
unnamed: M1.8 (RES1), M1.9 (VCC_RF)
unnamed: LED1.A, R8.1
unnamed: C0.2, LR3.1, U1.4 (TX)
unnamed: FB2.1, Q2.3 (D)
unnamed: R7.2, U2.5 (PRG)
unnamed: C0.1, C4.1, L0.2
unnamed: C3.2, M1.11 (RF_IN)
unnamed: JP4.1, M1.14 (MOSI/CFG_COM0)
unnamed: C18.2, JP1.2, R13.2, U2.3 (BAT), U4.3 (IN)
unnamed: C3.1, ESD1.2, X3.P (ANT)
unnamed: C20.2, FB3.2, LR1.2, U6.1 (VDD), U6.7 (VDDO)
unnamed: U8.3 (PC14/OSC32I), X1.2
unnamed: C15.1, R11.2, U1.8 (VDD)
unnamed: C1.2, U6.2 (XA)
unnamed: CM4.1, ESD3.2, LM3.1, X4.P (ANT)
unnamed: CM1.1, LM1.1, LM3.2
unnamed: FB5.2, U$42.1 (VBUS)
unnamed: U8.4 (PC15/OSC32O), X1.1
unnamed: C10.2, FB4.1, M2.13 (3.3V)
unnamed: R5.1, U$42.2 (D-)
unnamed: C6.1, CM3.1, ESD2.2, LM2.1, X2.P (ANT)
unnamed: CM2.1, LM.1, LM2.2
unnamed: R6.1, U$42.3 (D+)
unnamed: C9.2, FB2.2, M1.23 (VCC)
unnamed: LED4.C, R12.2
unnamed: C16.2, LR1.1, Q3.3 (D), Q4.3 (D)
unnamed: C6.2, M2.9 (ANT)
RADIO_XIN: C13.2, U1.17 (XIN)
RF_TANK: CM.1, L0.1, LM.2
RF_TANK1: C16.1, LM1.2
SCK: JP9.4, M2.4 (SCK), U1.12 (SCLK), U3.6 (SCK), U8.15 (PA5)
SCL: R3.1, U6.4 (SCL), U8.42 (PB6)
SDA: R4.1, U6.5 (SDA), U8.43 (PB7)
SHLD$1: U$42.SHLD$1
SHLD$2: U$42.SHLD$2
SHLD$3: U$42.SHLD$3
SHLD$4: U$42.SHLD$4
SWCLK: JP6.3, U8.37 (PA14)
SWDIO: JP6.2, U8.34 (PA13)
TCXO_OUT: C1.1, C13.1, XO1.3 (OUT)
TFT_RS: JP9.5
TRX_GPIO0: U1.9 (GPIO0)
TRX_GPIO1: U1.10 (GPIO1)
TRX_GPIO2: TP11.TP, U1.19 (GPIO2)
TRX_GPIO3: TP10.TP, U1.20 (GPIO3)
USB_DM: R5.2, U8.32 (PA11)
USB_DP: R6.2, U8.33 (PA12)
USB_VBUS: C19.2, FB5.1, R8.2, U2.4 (VDD)
VBAT_ADC: C17.2, R10.2, R13.1

Notes on the sheet:
Tuned for 434MHz/144Mhz/21MHz

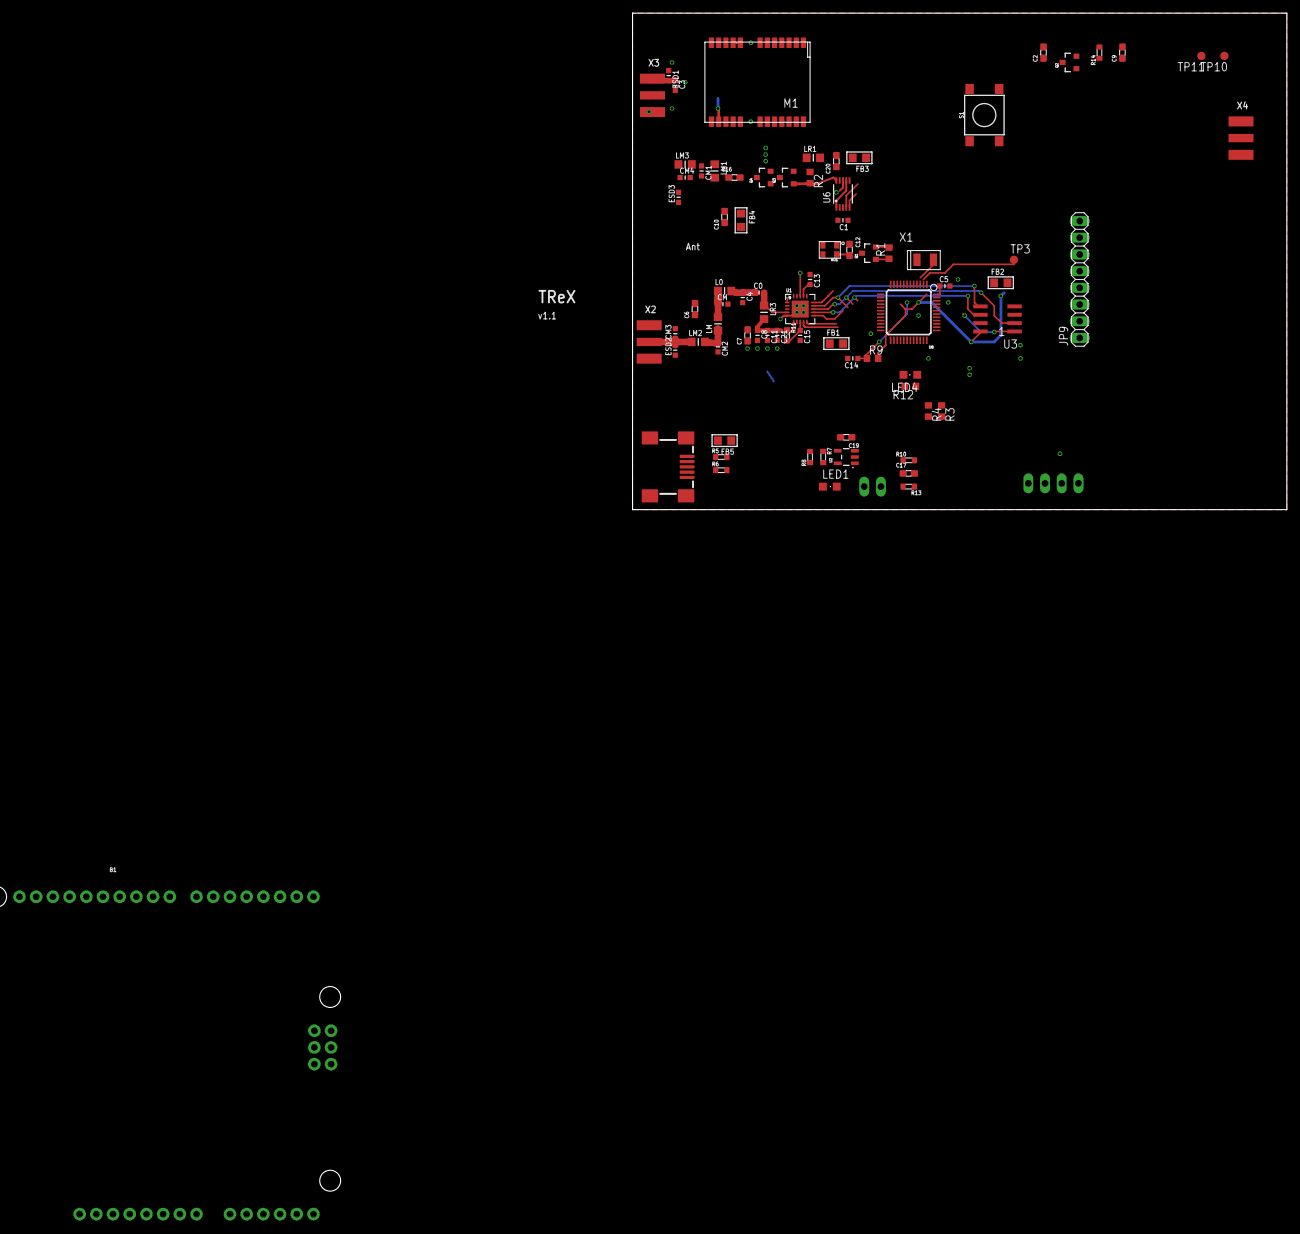
[picture p38: board tracker-uno-v1.brd from above]

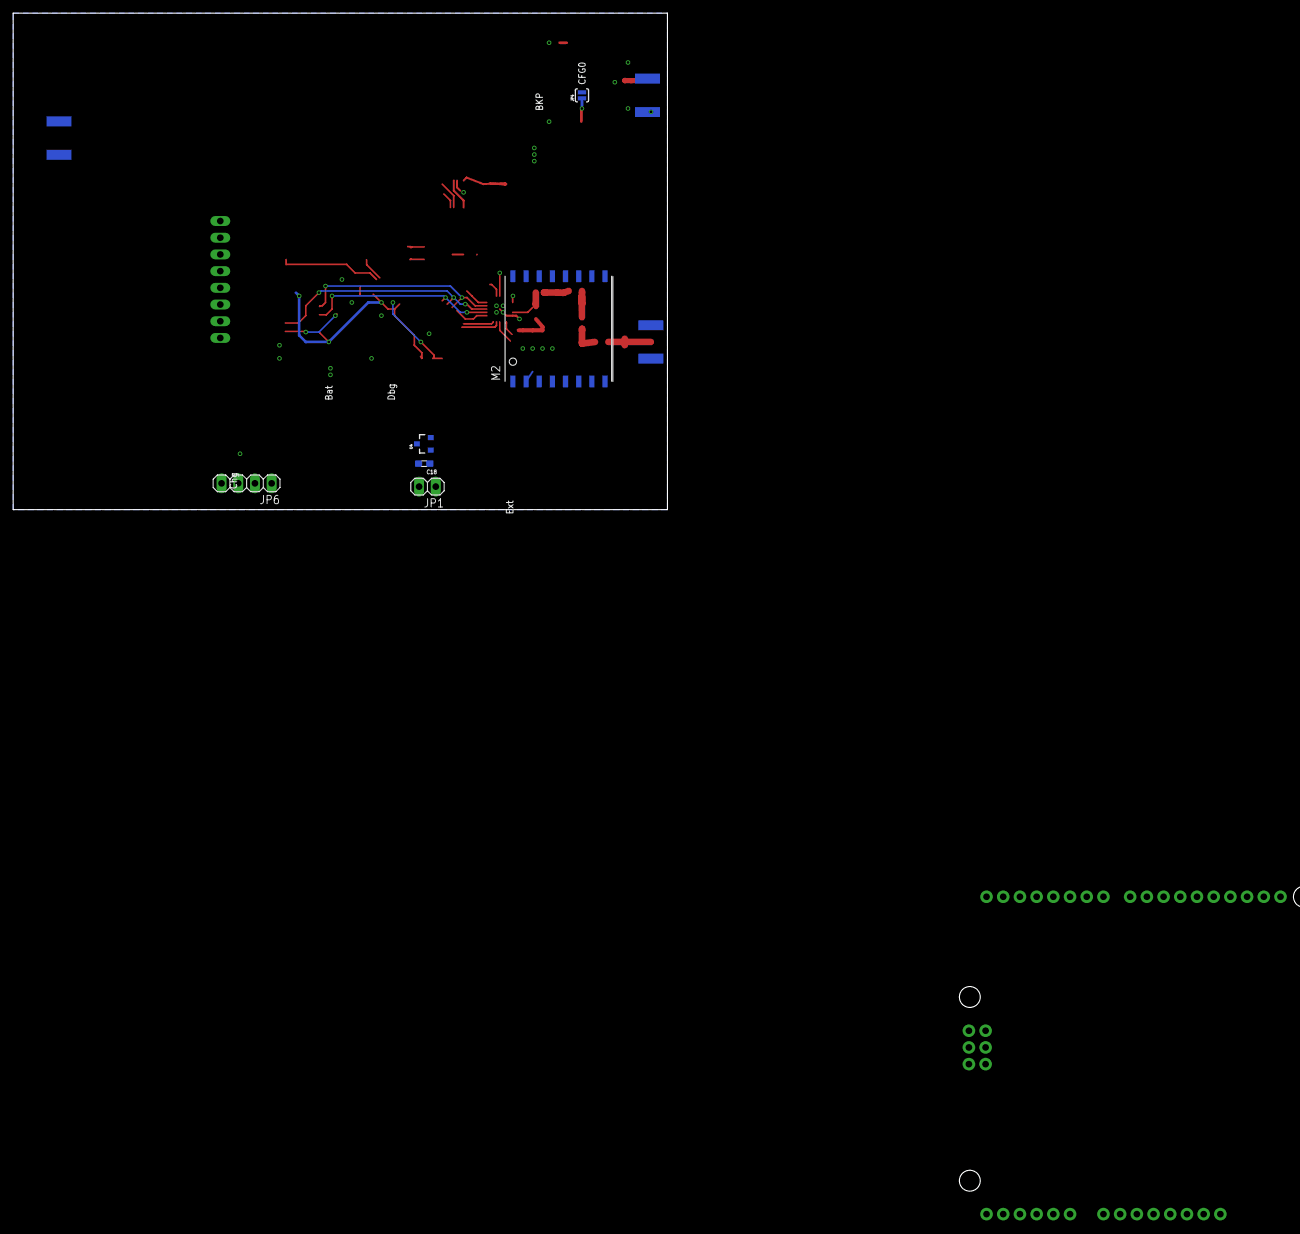
[picture p39: board tracker-uno-v1.brd from below]

Board: 2 copper layers, 99.5 x 75.5 mm, 85 parts (6 on the bottom side), 55 nets.
