kgoba/zinoo/eagle/motor_shield/motor_shield.brd

## EAGLE design eagle/motor_shield/motor_shield.brd (2018-01-04)

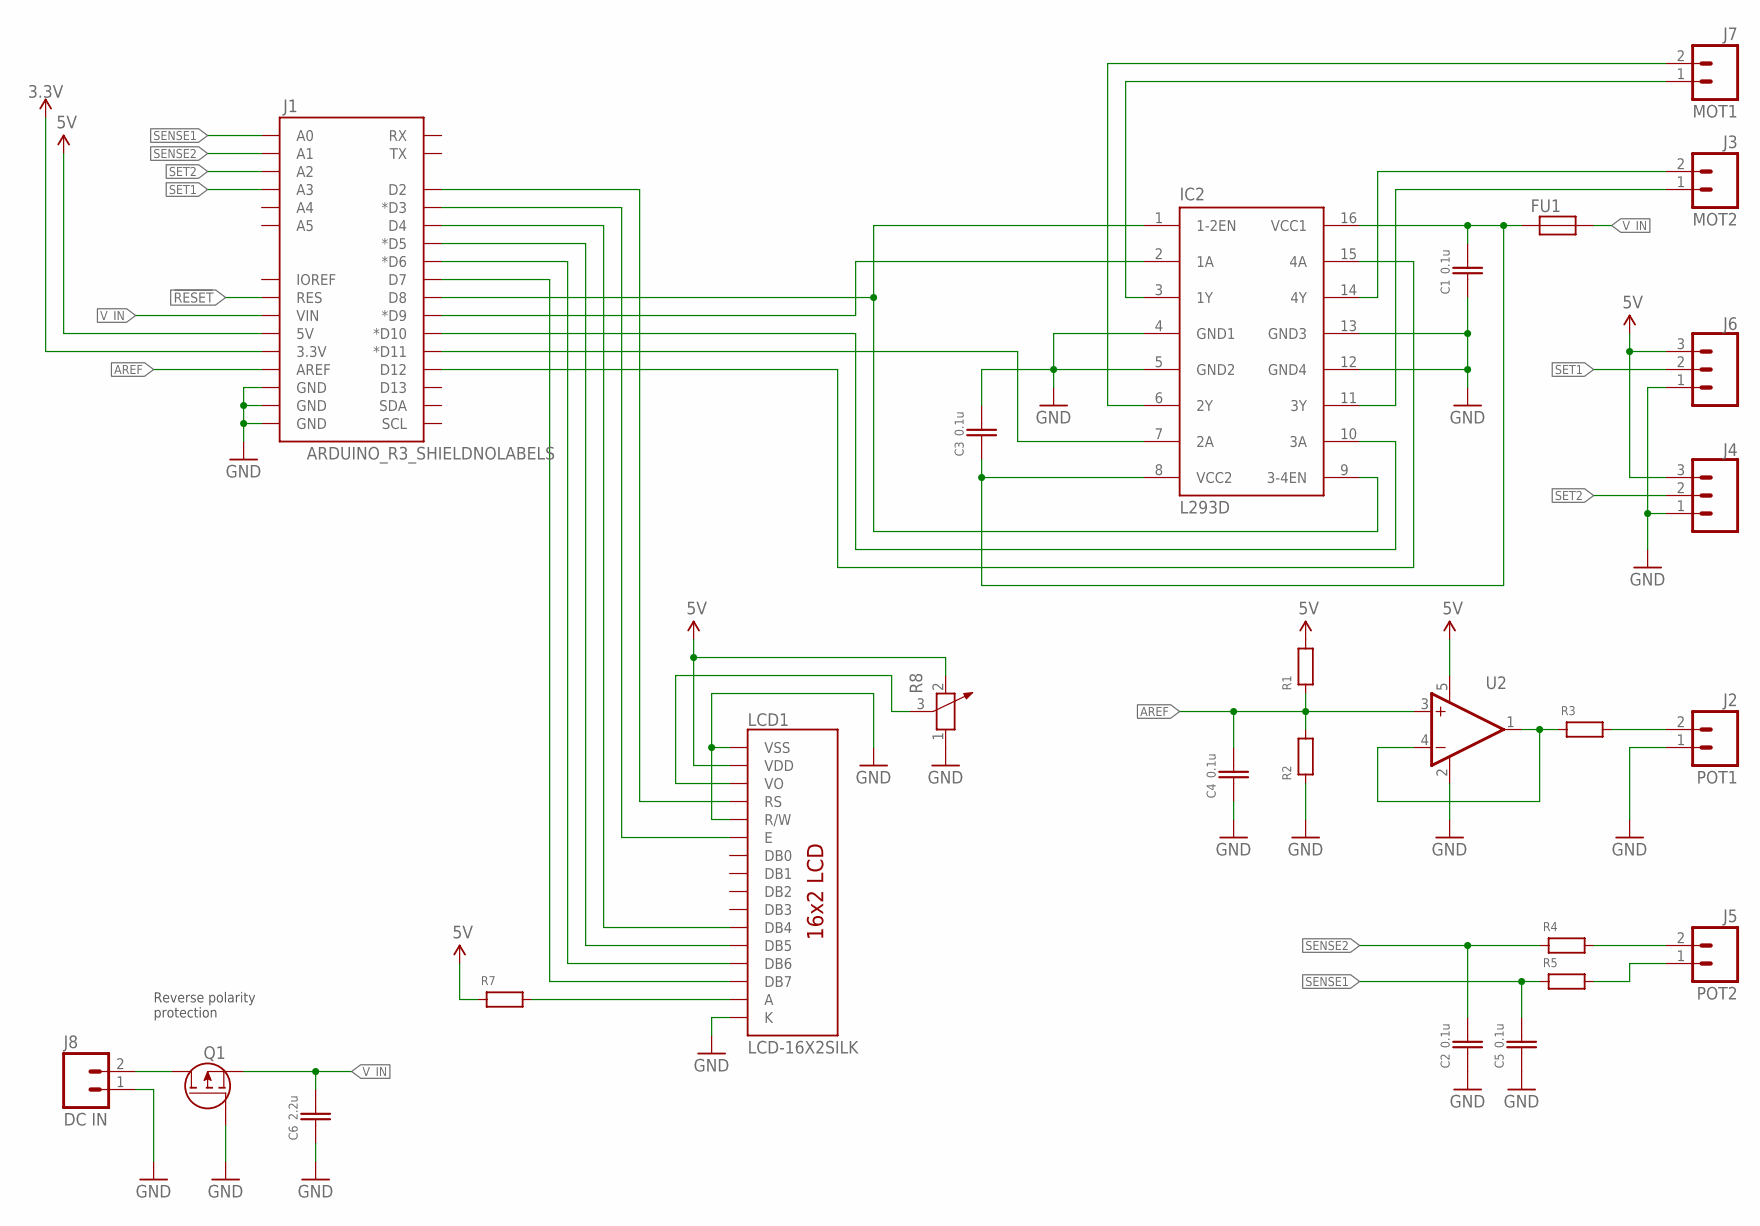
[picture p40: schematic motor_shield.sch]

Parts:
C1, C3: 0.1u; C805
C2, C4, C5: 0.1u; C603
C6: 2.2u; C1206
FU1: PTC_FUSE; C1812K
IC2: L293D; DIL16
J1: ARDUINO_R3_SHIELDNOLABELS; UNO_R3_SHIELD_NOLABELS
J2: POT1; SCREWTERMINAL-3.5MM-2
J3: MOT2; SCREWTERMINAL-3.5MM-2
J4, J6: CONN_03SCREW; SCREWTERMINAL-3.5MM-3
J5: POT2; SCREWTERMINAL-3.5MM-2
J7: MOT1; SCREWTERMINAL-3.5MM-2
J8: DC IN; SCREWTERMINAL-3.5MM-2
LCD1: LCD-16X2SILK; LCD-16X2
Q1: MOSFET-P-SOT23-3; SOT23-3
R1, R2, R3, R4, R5, R7: RESISTOR-0603; R0603
R8: POTENTIOMETER_PT-10S; PT-10S
U2: OPAMP-1CH-SOT23-5; SOT23-5

Connections:
3.3V: J1.3.3V
5V: J1.5V, J4.3, J6.3, LCD1.2 (VDD), R1.2, R7.1, R8.2, U2.5 (V+)
!RESET: J1.RES
AREF: C4.2, J1.AREF, R1.1, R2.2, U2.3 (+IN)
GND: C1.1, C2.1, C3.2, C4.1, C5.1, C6.1, IC2.4 (GND1), IC2.5 (GND2), IC2.12 (GND4), IC2.13 (GND3), J1.GND@0 (GND), J1.GND@1 (GND), J1.GND@2 (GND), J2.1, J4.1, J6.1, J8.1, LCD1.1 (VSS), LCD1.5 (R/W), LCD1.16 (K), Q1.1 (G), R2.1, R8.1, U2.2 (V-)
unnamed: IC2.1 (1-2EN), IC2.9 (3-4EN), J1.D8
unnamed: R3.1, U2.1 (OUT), U2.4 (-IN)
unnamed: LCD1.15 (A), R7.2
unnamed: J5.2, R4.2
unnamed: IC2.3 (1Y), J7.1
unnamed: IC2.6 (2Y), J7.2
unnamed: IC2.2 (1A), J1.D9 (*D9)
unnamed: IC2.7 (2A), J1.D11 (*D11)
unnamed: IC2.11 (3Y), J3.1
unnamed: IC2.14 (4Y), J3.2
unnamed: IC2.15 (4A), J1.D12
unnamed: IC2.10 (3A), J1.D10 (*D10)
unnamed: J2.2, R3.2
unnamed: J5.1, R5.2
unnamed: J1.D4, LCD1.11 (DB4)
unnamed: J1.D5 (*D5), LCD1.12 (DB5)
unnamed: J1.D6 (*D6), LCD1.13 (DB6)
unnamed: J1.D7, LCD1.14 (DB7)
unnamed: J1.D3 (*D3), LCD1.6 (E)
unnamed: J1.D2, LCD1.4 (RS)
unnamed: C1.2, C3.1, FU1.1, IC2.8 (VCC2), IC2.16 (VCC1)
unnamed: LCD1.3 (VO), R8.3
unnamed: J8.2, Q1.3 (D)
SENSE1: C5.2, J1.A0, R5.1
SENSE2: C2.2, J1.A1, R4.1
SET1: J1.A3, J6.2
SET2: J1.A2, J4.2
V_IN: C6.2, FU1.2, J1.VIN, Q1.2 (S)

Notes on the sheet:
Reverse polarity protection

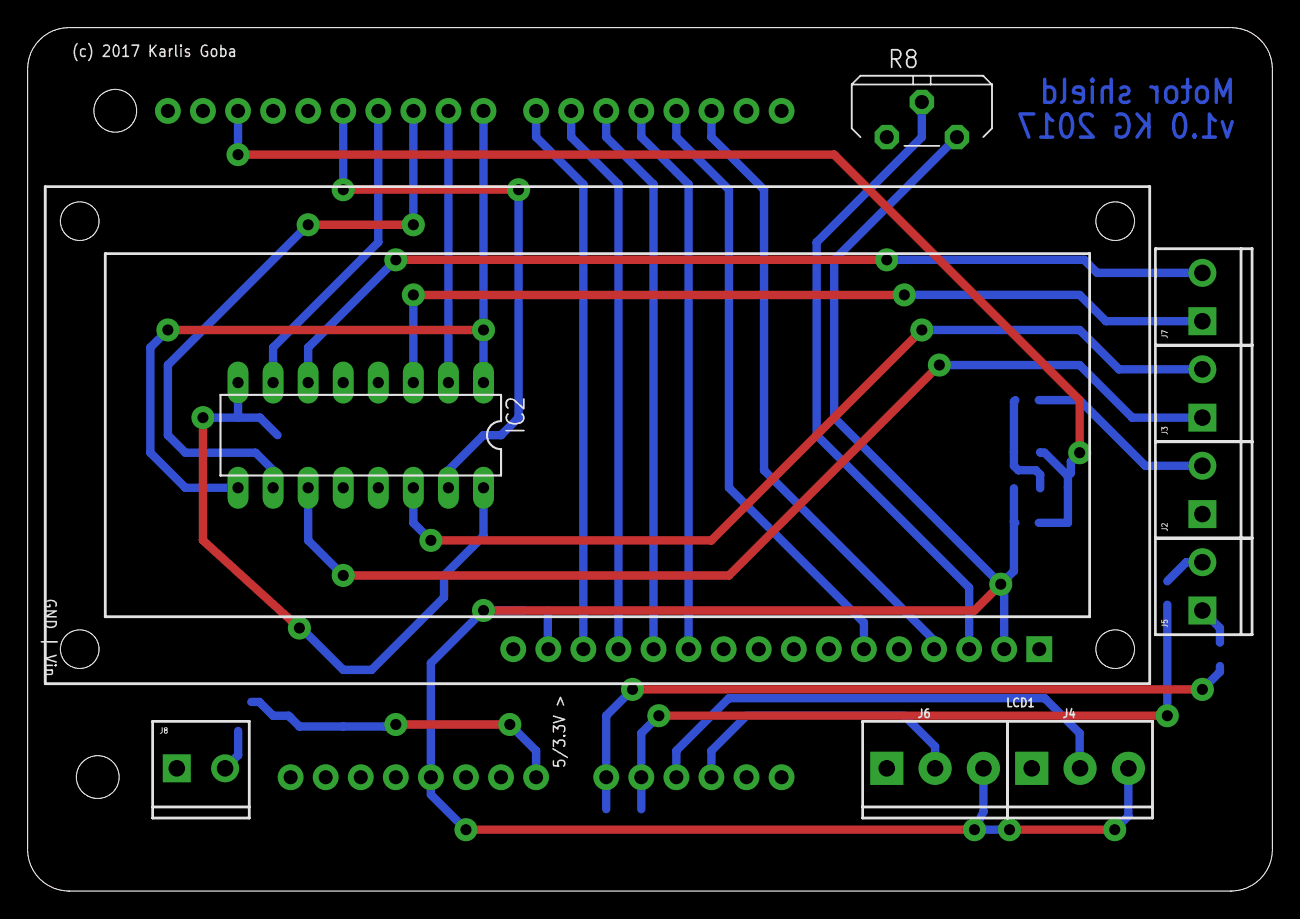
[picture p41: board motor_shield.brd from above]

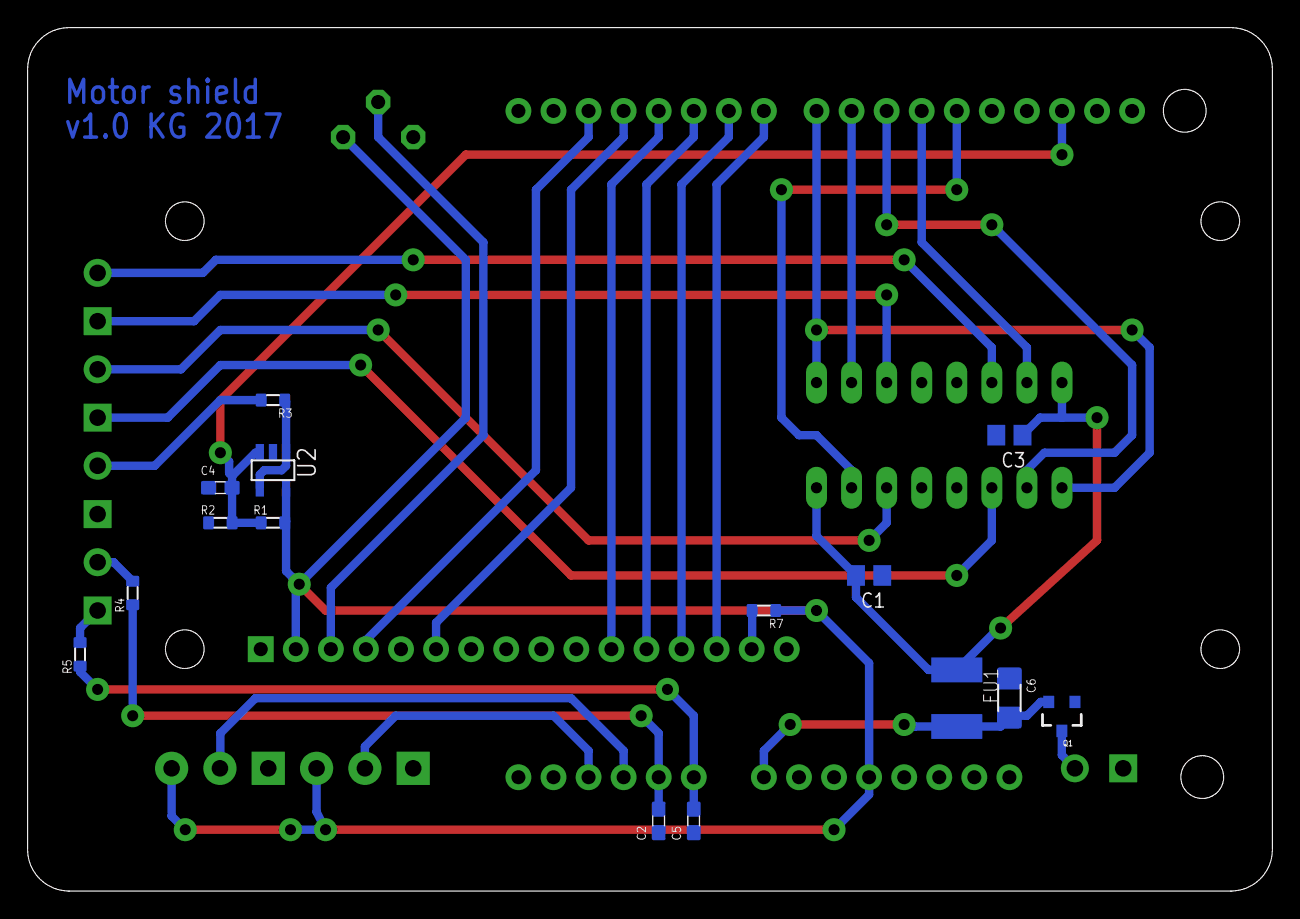
[picture p42: board motor_shield.brd from below]

Board: 2 copper layers, 90.2 x 62.5 mm, 26 parts (15 on the bottom side), 31 nets.
