kgoba/zinoo/eagle/relay_shield/relay_shield2.brd

## EAGLE design eagle/relay_shield/relay_shield2.brd (2018-01-04)

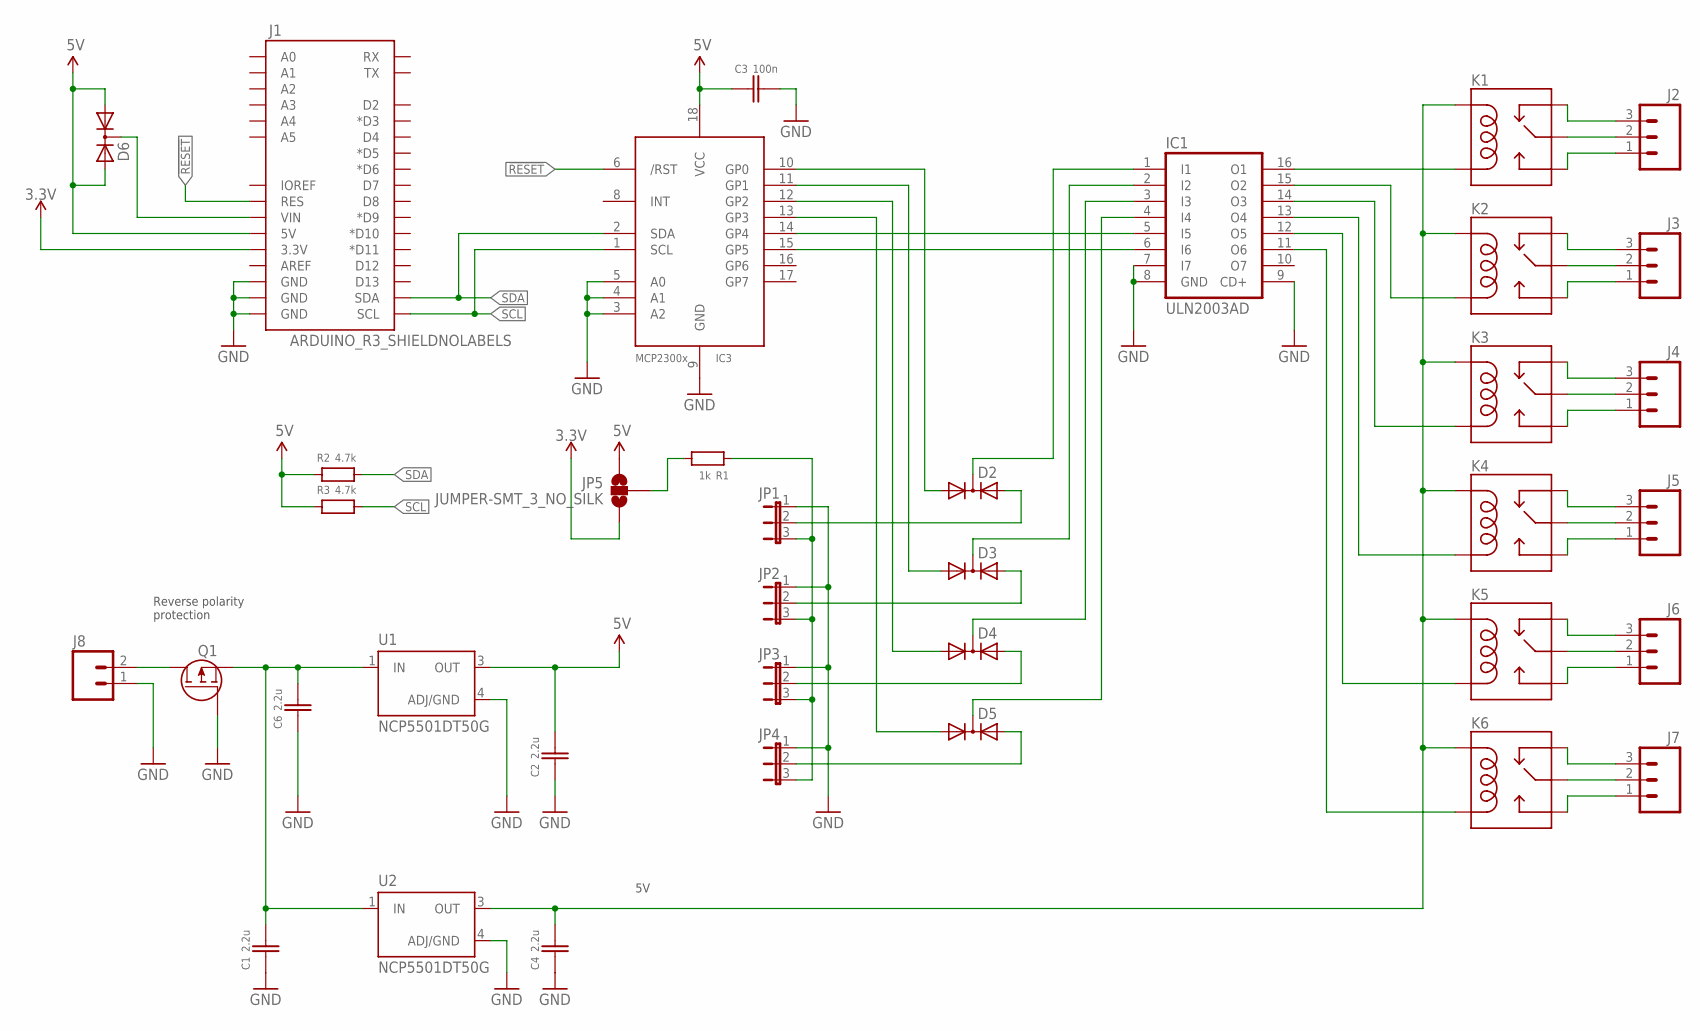
[picture p43: schematic relay_shield2.sch]

Parts:
C1, C2, C4, C6: 2.2u; C1206
C3: 100n; C603
D2, D3, D4, D5, D6: DIODE-2AC|CASOT23; SOT23
IC1: ULN2003AD; SO16
IC3: MCP23008/SO; SO18W
J1: ARDUINO_R3_SHIELDNOLABELS; UNO_R3_SHIELD_NOLABELS
J2, J3, J4, J5, J6, J7: M03SCREW; SCREWTERMINAL-3.5MM-3
J8: M023.5MM; SCREWTERMINAL-3.5MM-2
JP1, JP2, JP3, JP4: JP2E; JP2
JP5: JUMPER-SMT_3_NO_SILK; SMT-JUMPER_3_NO_SILK
K1, K2, K3, K4, K5, K6: RELAY-SPDTPTH6; RELAY-SCHRACK-RY211
Q1: MOSFET-P-SOT23-3; SOT23-3
R1: 1k; R0603
R2, R3: 4.7k; R0603
U1, U2: NCP5501DT50G; DPAK

Connections:
3.3V: J1.3.3V, JP5.3
5V: C2.2, C3.1, D6.1 (A1), D6.2 (A2), IC3.18 (VCC), J1.5V, JP5.1, R2.1, R3.1, U1.3 (OUT)
!RESET: IC3.6 (/RST), J1.RES
GND: C1.1, C2.1, C3.2, C4.1, C6.1, IC1.7 (I7), IC1.8 (GND), IC1.9 (CD+), IC3.3 (A2), IC3.4 (A1), IC3.5 (A0), IC3.9 (GND), J1.GND@0 (GND), J1.GND@1 (GND), J1.GND@2 (GND), J8.1, JP1.1, JP2.1, JP3.1, JP4.1, Q1.1 (G), U2.4 (ADJ/GND)
unnamed: D2.2 (A2), JP1.2
unnamed: D3.2 (A2), JP2.2
unnamed: J2.2, K1.11 (MAIN)
unnamed: C1.2, C6.2, Q1.2 (S), U1.1 (IN), U2.1 (IN)
unnamed: C4.2, K1.A1 (COIL1), K2.A1 (COIL1), K3.A1 (COIL1), K4.A1 (COIL1), K5.A1 (COIL1), K6.A1 (COIL1), U2.3 (OUT)
unnamed: J3.2, K2.11 (MAIN)
unnamed: J4.2, K3.11 (MAIN)
unnamed: J5.2, K4.11 (MAIN)
unnamed: J6.2, K5.11 (MAIN)
unnamed: J7.2, K6.11 (MAIN)
unnamed: IC1.16 (O1), K1.A2 (COIL2)
unnamed: IC1.15 (O2), K2.A2 (COIL2)
unnamed: IC1.14 (O3), K3.A2 (COIL2)
unnamed: IC1.13 (O4), K4.A2 (COIL2)
unnamed: IC1.12 (O5), K5.A2 (COIL2)
unnamed: IC1.11 (O6), K6.A2 (COIL2)
unnamed: D2.3 (C), IC1.1 (I1)
unnamed: D3.3 (C), IC1.2 (I2)
unnamed: D4.3 (C), IC1.3 (I3)
unnamed: D5.3 (C), IC1.4 (I4)
unnamed: IC1.5 (I5), IC3.14 (GP4)
unnamed: IC1.6 (I6), IC3.15 (GP5)
unnamed: D6.3 (C), J1.VIN
unnamed: D4.2 (A2), JP3.2
unnamed: D5.2 (A2), JP4.2
unnamed: D2.1 (A1), IC3.10 (GP0)
unnamed: D3.1 (A1), IC3.11 (GP1)
unnamed: D4.1 (A1), IC3.12 (GP2)
unnamed: D5.1 (A1), IC3.13 (GP3)
unnamed: J8.2, Q1.3 (D)
unnamed: J2.3, K1.12 (NC)
unnamed: J2.1, K1.14 (NO)
unnamed: J3.3, K2.12 (NC)
unnamed: J3.1, K2.14 (NO)
unnamed: J4.3, K3.12 (NC)
unnamed: J4.1, K3.14 (NO)
unnamed: J5.3, K4.12 (NC)
unnamed: J5.1, K4.14 (NO)
unnamed: J6.3, K5.12 (NC)
unnamed: J6.1, K5.14 (NO)
unnamed: J7.3, K6.12 (NC)
unnamed: J7.1, K6.14 (NO)
unnamed: JP1.3, JP2.3, JP3.3, JP4.3, R1.1
unnamed: JP5.2, R1.2
SCL: IC3.1 (SCL), J1.SCL, R3.2
SDA: IC3.2 (SDA), J1.SDA, R2.2

Notes on the sheet:
Reverse polarity protection

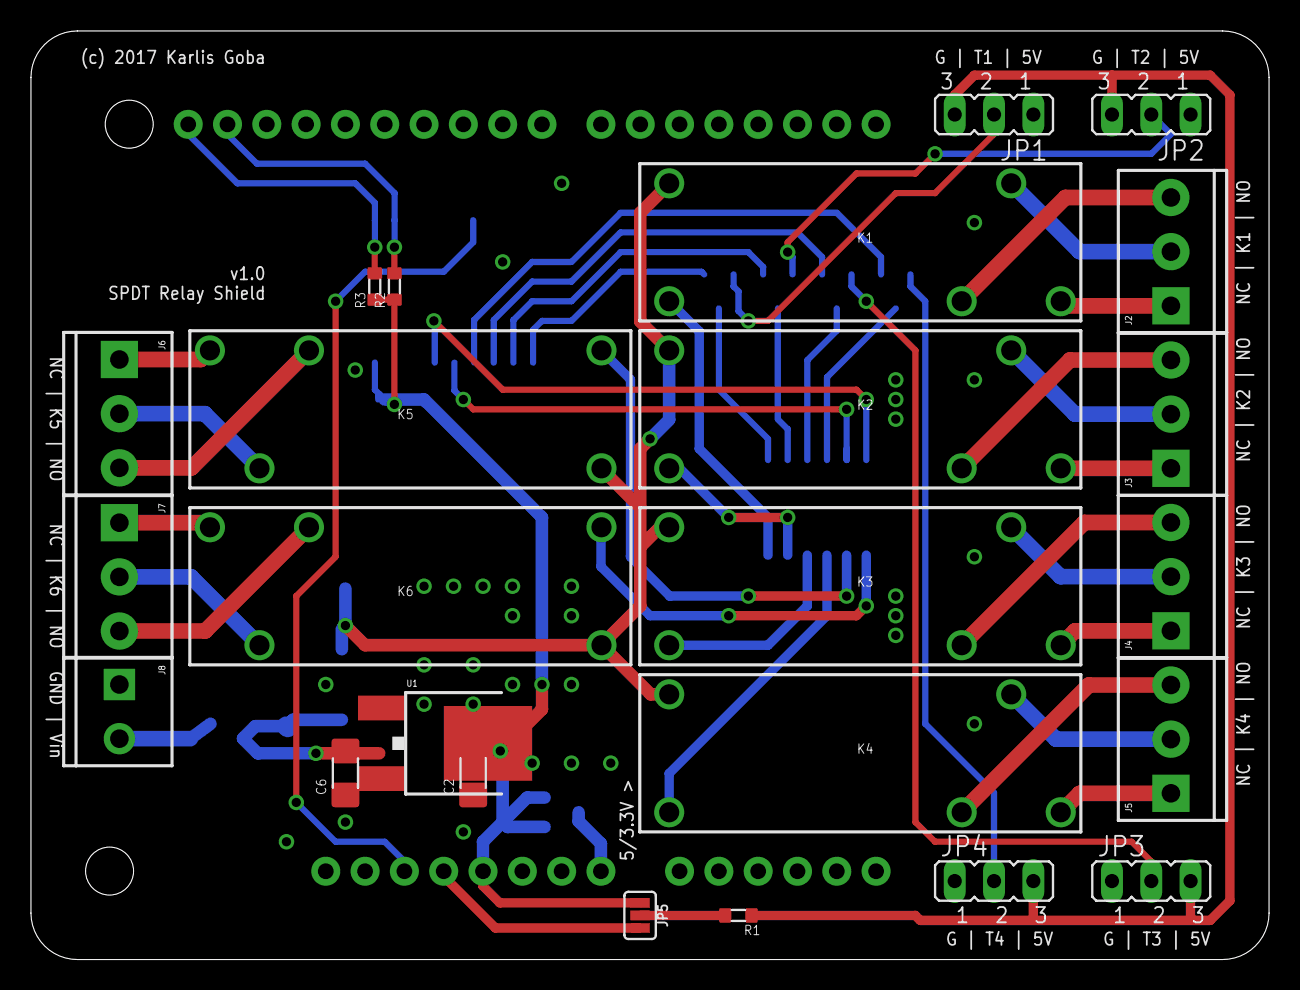
[picture p44: board relay_shield2.brd from above]

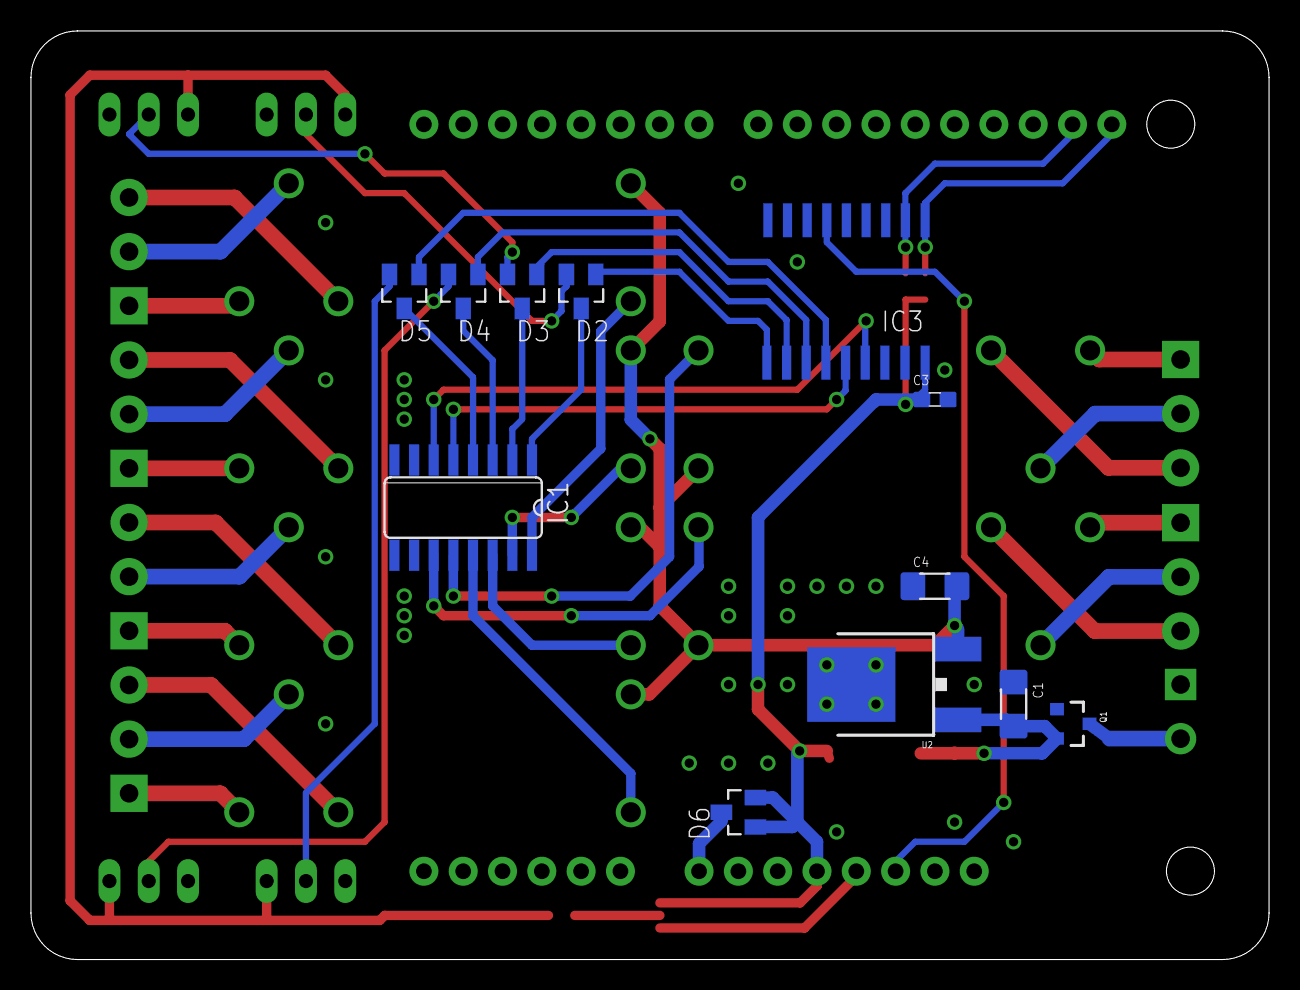
[picture p45: board relay_shield2.brd from below]

Board: 2 copper layers, 80.0 x 60.0 mm, 37 parts (12 on the bottom side), 50 nets.
