kgoba/zinoo/eagle/relay_shield/relay_shield3b.brd

## EAGLE design eagle/relay_shield/relay_shield3b.brd (2018-01-04)

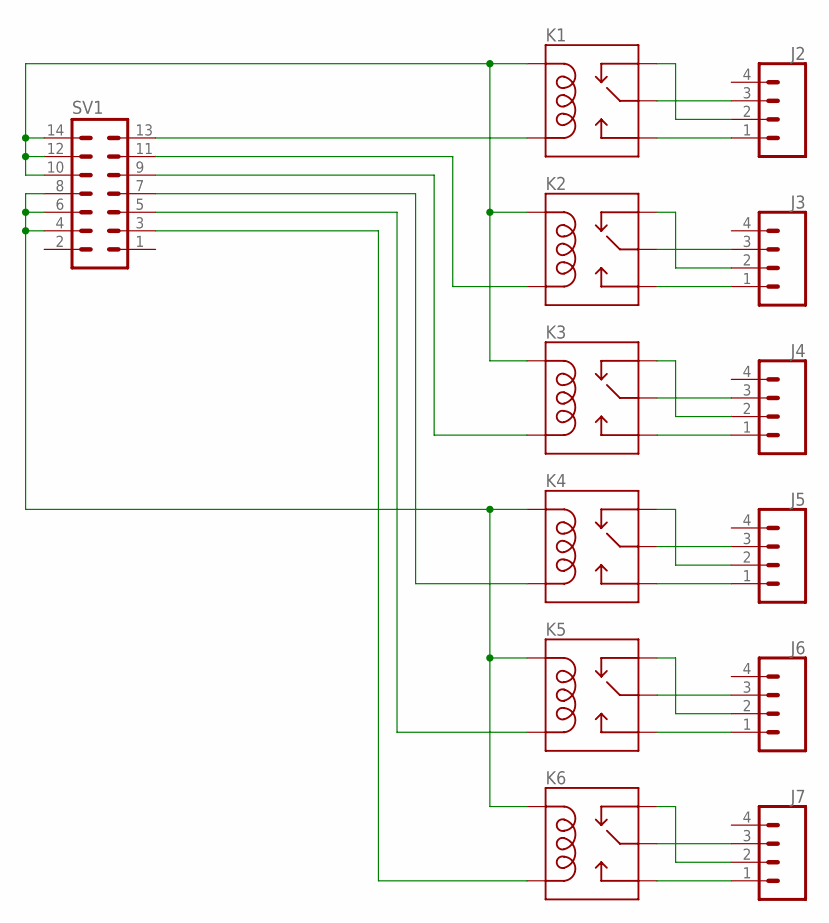
[picture p46: schematic relay_shield3b.sch]

Parts:
J2, J3, J4, J5, J6, J7: CONN_04SCREW; SCREWTERMINAL-3.5MM-4
K1, K2, K3, K4, K5, K6: RELAY-SPDTPTH6; RELAY-SCHRACK-RY211
SV1: ML14L

Connections:
unnamed: K1.A2 (COIL2), SV1.13
unnamed: J2.3, K1.11 (MAIN)
unnamed: J3.3, K2.11 (MAIN)
unnamed: K4.A1 (COIL1), K5.A1 (COIL1), K6.A1 (COIL1), SV1.4, SV1.6, SV1.8
unnamed: J3.2, K2.12 (NC)
unnamed: J4.3, K3.11 (MAIN)
unnamed: J5.2, K4.12 (NC)
unnamed: J7.3, K6.11 (MAIN)
unnamed: J7.2, K6.12 (NC)
unnamed: J4.2, K3.12 (NC)
unnamed: K2.A2 (COIL2), SV1.11
unnamed: K3.A2 (COIL2), SV1.9
unnamed: K4.A2 (COIL2), SV1.7
unnamed: K5.A2 (COIL2), SV1.5
unnamed: K6.A2 (COIL2), SV1.3
unnamed: J5.3, K4.11 (MAIN)
unnamed: J6.2, K5.12 (NC)
unnamed: J6.3, K5.11 (MAIN)
unnamed: K1.A1 (COIL1), K2.A1 (COIL1), K3.A1 (COIL1), SV1.10, SV1.12, SV1.14
unnamed: J2.2, K1.12 (NC)
unnamed: J2.1, K1.14 (NO)
unnamed: J3.1, K2.14 (NO)
unnamed: J4.1, K3.14 (NO)
unnamed: J5.1, K4.14 (NO)
unnamed: J6.1, K5.14 (NO)
unnamed: J7.1, K6.14 (NO)

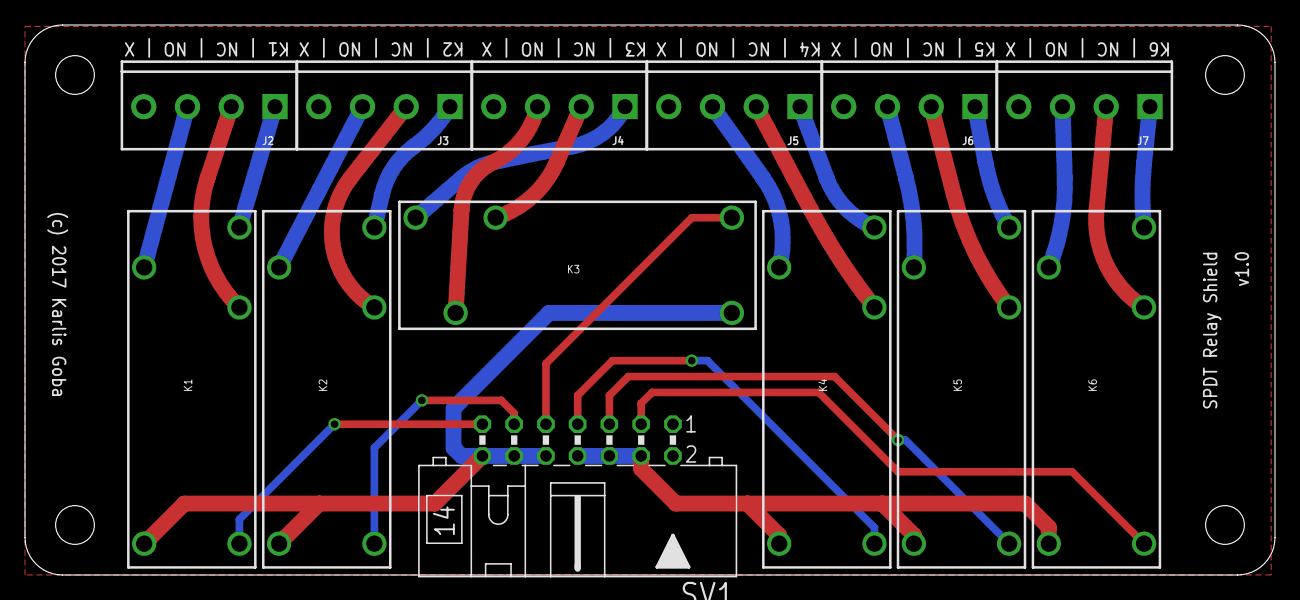
[picture p47: board relay_shield3b.brd from above]

Board: 2 copper layers, 100.0 x 44.0 mm, 13 parts (0 on the bottom side), 26 nets.
