kgoba/zinoo/firmware/lora-sky/src/Client.ino

/*
  (c) Dragino Project, https://github.com/dragino/Lora
  (c) 2017 Karlis Goba
*/

//#include <SoftwareSerial.h>
#include <TimeLib.h>
#include <TinyGPS++.h>
#include <RH_RF95.h>
//#include <Servo.h>
#include <avr/wdt.h>

#include <EEPROM.h>

// All hardware and software configuration is in config.h
#include "config.h"

#include "Status.h"
#include "quectel.h"

TinyGPSPlus gps;
RH_RF95     lora(LORA_CS_PIN);
Status      status;
//Servo		servo1;
//Servo		servo2;

uint32_t    switch_off[4];

void setup() {
    wdt_enable(WDTO_2S);

    Serial.begin(9600);	
    Serial.println("RESET");

	gps_setup();
	lora_setup();
	pyro_setup();	
	//servo_setup();	
	buzzer_setup();
		
    status.restore();
}

void gps_setup()
{
    setSyncProvider(noSync);
    setSyncInterval(60);    // This resets timeStatus periodically to "sync"

    if (gps_set_balloon_mode()) {
        Serial.println("Set balloon mode: OK");
    }
    else {
        Serial.println("Set balloon mode: FAILED");
    }
}

bool gps_feed()
{
    bool newData = false;
    while (Serial.available()) {
        char c = Serial.read();
        //Serial.write(c);
        if (gps.encode(c)) newData = true; 
    }
    return newData;
}

void pyro_setup()
{
#ifdef WITH_PYRO
    //digitalWrite(RELEASE_PIN, LOW);	
    //pinMode(RELEASE_PIN, OUTPUT);

    pinMode(SWITCH1_PIN, OUTPUT);
    pinMode(SWITCH2_PIN, OUTPUT);
    pinMode(SWITCH3_PIN, OUTPUT);
    pinMode(SWITCH4_PIN, OUTPUT);
#endif
}

void pyro_update()
{
#ifdef WITH_PYRO
    uint32_t now = millis();

#ifdef RELEASE_ALTITUDE
#warning "Enabling automatic balloon release"
    // Auto-burst above a threshold altitude
    if (status.fixValid && (status.alt >= RELEASE_ALTITUDE) 
        && (now >= RELEASE_SAFETIME * 1000UL)) 
    {
        digitalWrite(SWITCH4_PIN, HIGH);
        status.switch_state |= 8;
        switch_off[3] = now + SWITCH4_AUTO_OFF * 1000UL;
    }
#endif

    // Check for auto off timeouts
    if (SWITCH1_AUTO_OFF > 0 && now > switch_off[0]) {
        digitalWrite(SWITCH1_PIN, LOW);
        status.switch_state &= ~1;        
    }
    if (SWITCH2_AUTO_OFF > 0 && now > switch_off[1]) {
        digitalWrite(SWITCH2_PIN, LOW);
        status.switch_state &= ~2;        
    }
    // Do NOT reset the state for pyro outputs (they are one-shot anyway)
    if (SWITCH3_AUTO_OFF > 0 && now > switch_off[2]) {
        digitalWrite(SWITCH3_PIN, LOW);
        //status.switch_state &= ~4;        
    }
    if (SWITCH4_AUTO_OFF > 0 && now > switch_off[3]) {
        digitalWrite(SWITCH4_PIN, LOW);
        //status.switch_state &= ~8;        
    }
#endif    
}

void lora_setup()
{
    for (int n_try = 0; n_try < 5; n_try++) {
        // reset LoRa module to make sure it will works properly
        pinMode(LORA_RST_PIN, OUTPUT);
        digitalWrite(LORA_RST_PIN, LOW);   
        delay(1000);
        digitalWrite(LORA_RST_PIN, HIGH);

        wdt_reset();

        if (lora.init()) break;
        Serial.println("LoRa init failed, retrying...");
    }

    // Defaults after init are 434.0MHz, 13dBm
    // Bw = 125 kHz, Cr = 4/5, Sf = 128chips/symbol, CRC on
    lora.setModemConfig(MODEM_MODE);
    lora.setSpreadingFactor(11);
    lora.setFrequency(FREQUENCY_MHZ);
    lora.setTxPower(TX_POWER_DBM);	
}

/*
void servo_setup()
{
	servo1.attach(SERVO1_PIN);
	servo2.attach(SERVO2_PIN);
	
	servo1.write(0);
	servo2.write(0);
}
*/

void buzzer_setup()
{
	TCCR2A = (1 << WGM21) | (1 << WGM20);								// Mode 7 (Fast PWM)
	TCCR2B = (1 << CS22) | (1 << CS21) | (1 << CS20) | (1 << WGM22);	// Prescaler 1024
	TIMSK2 = (1 << TOIE2);							// Enable overflow interrupt (every 256)
	OCR2A  = 125;
	pinMode(BUZZER_PIN, OUTPUT);
}

void loop() {
    // Feed all available data to GPS parser
    bool newGPSData = gps_feed();   // Returns whether a new valid NMEA sentence came in
    
    // Sync time if necessary
    if (newGPSData && (timeStatus() != timeSet)) {
        update_time_from_gps();
    }
    
    // Update last valid coordinates if available
    if (newGPSData) {
        wdt_reset();

        update_location_from_gps();
        pyro_update();
    }
    
    // Transmit if it is our timeslot and time is valid
    //if ((timeStatus() != timeNotSet) && timeslot_go()) {
	if (timeslot_go()) {
        // Update voltage and temperature measurements
        status.temperature_ext = 0.5 + clip(read_temperature(), -120.0f, 120.0f);
        status.pyro_voltage = read_pyro_voltage();

        lora_transmit();
        status.msg_id++;
        status.save();
    }
    
    // If transmiting is complete, check (or switch to) uplink receiving
    if (lora.mode() != lora.RHModeTx) {
        // When transmit is complete, radio is automatically put in Idle mode
        uint8_t rx_buf[20];	// Uplink data
	    uint8_t len = sizeof(rx_buf) - 1;
        // Puts radio to receive mode if it wasn't, checks for message, doesn't block
		if (lora.recv(rx_buf, &len)) {
            // Update RX stats
            status.rssi_last = lora.lastRssi();
            status.msg_recv++;

            rx_buf[len] = '\0';	// Add zero string termination
            lora_parse((const char *)rx_buf);
        }
    }
}

/// Checks whether it is right time for transmission
bool timeslot_go() {
    static uint8_t last_second = 0xFF;

    // Is it still the same second as previously?
    if (second() == last_second) return false;
    
    last_second = second();

    return ((second() % TOTAL_SLOTS) == TIMESLOT);
}

/// Constructs payload message and transmits it via radio
void lora_transmit() {
    char    tx_buf[80];    // Temporary buffer for LoRa message

    if (status.build_string(tx_buf, 80)) {
        // Log the message on serial
        Serial.print(">>> "); Serial.println(tx_buf);
        // Send the data to server
        lora.send((const uint8_t *)tx_buf, strlen(tx_buf));
    }
}

bool lora_parse(const char * rx_buf) {
    // Log the command on serial
	Serial.print(">>> "); Serial.println(rx_buf);

#ifdef WITH_PYRO
    // Commands: S1, S2, ... S6
    if (strlen(rx_buf) != 2 || rx_buf[0] != 'S') 
        return false;

    char cmd_id = rx_buf[1];
    switch (cmd_id) {
    case '1':
        digitalWrite(SWITCH4_PIN, HIGH);        // TURN ON
        status.switch_state |= (1 << 3);
        switch_off[3] = millis() + SWITCH4_AUTO_OFF * 1000UL;
        break;
    case '2':
        digitalWrite(SWITCH3_PIN, HIGH);        // TURN ON
        status.switch_state |= (1 << 2);
        switch_off[2] = millis() + SWITCH3_AUTO_OFF * 1000UL;
        break;
    case '3':
        digitalWrite(SWITCH2_PIN, HIGH);        // TURN ON
        status.switch_state |= (1 << 1);
        switch_off[1] = millis() + SWITCH2_AUTO_OFF * 1000UL;
        break;
    case '4':
        digitalWrite(SWITCH2_PIN, LOW);         // TURN OFF
        status.switch_state &= ~(1 << 1);
        break;
    case '5':
        digitalWrite(SWITCH1_PIN, HIGH);        // TURN ON
        status.switch_state |= (1 << 0);
        switch_off[0] = millis() + SWITCH1_AUTO_OFF * 1000UL;
        break;
    case '6':
        digitalWrite(SWITCH1_PIN, LOW);         // TURN OFF
        status.switch_state &= ~(1 << 0);
        break;
    }
#endif
    //servo1.write((status & 1) ? 180 : 0);
    //servo2.write((status & 2) ? 180 : 0);

    // Send ACK
    //char    tx_buf[2];    // Temporary buffer for LoRa message
    //tx_buf[0] = 'A';
    //tx_buf[1] = cmd_id;
    //lora.send((const uint8_t *)tx_buf, 2);
    return true;
}

/// Updates internal clock (using Time library) from GPS time data 
// (if it is valid)
void update_time_from_gps() {
    // Check for data validity (added satellite check, 
    // otherwise GPS sends fake time/date information)
    if (!gps.satellites.isValid() || gps.satellites.value() == 0) {
        // Do nothing, just return. Time data is not valid.
        return;
    }

    TinyGPSDate &date = gps.date;
    if (date.isValid()) {
        setTime(hour(), minute(), second(), date.day(), date.month(), date.year());

        // Report date update
        Serial.print("Setting date to ");
        Serial.print(date.year()); Serial.print('.');
        Serial.print(date.month()); Serial.print('.');
        Serial.println(date.day());
    }

    TinyGPSTime &time = gps.time;
    if (time.isValid() && time.age() < 500) {
        setTime(time.hour(), time.minute(), time.second(), day(), month(), year());

        // Report time update
        Serial.print("Setting time to ");
        Serial.print(time.hour()); Serial.print(':');
        Serial.print(time.minute()); Serial.print(':');
        Serial.println(time.second());
    }
}

/// Updates status variable with the latest GPS location data
// (if it is valid)
void update_location_from_gps() {
    //if (gps.satellites.isValid()) {
        status.n_sats = gps.satellites.value();
    //}
    //else status.n_sats = 0;

    if (gps.location.isValid()) {
        float falt = 0;
        if (gps.altitude.isValid()) falt = gps.altitude.meters();

        // Convert altitude to 16 bit unsigned    
        if (falt > 0) {
            if (falt > 65535) status.alt = 65535;
            else status.alt = (uint16_t)falt;
        }
        else status.alt = 0;
        
        status.fixValid = true;
        status.lat = gps.location.lat();
        status.lng = gps.location.lng();
    }
    else status.fixValid = false;
}

template<class T>
T clip(T value, T min, T max) {
    if (value < min) return min;
    if (value > max) return max;
    return value;
}

/// Converts 10 bit ADC reading from a NTC to Celsius degrees.
// The NTC is connected to +5V/AREF, and forms a divider 
// with a resistor to the ground.
float celsius_from_adc(uint16_t adc) {
    float ratio = adc / 1024.0f;         // Convert to 0..1
    float R = (NTC_R1 / ratio) - NTC_R1; // Calculate NTC resistance
    float k1 = log(R / NTC_R0) / NTC_B;  // Helper value
    float T = 1 / (k1 + 1.0f / NTC_T0);  // Temperature in Kelvins
    return (T - 273.15f);                // Convert to Celsius
}

/// Reads ADC value and converts to Celsius degrees
float read_temperature() {
    return celsius_from_adc(analogRead(NTC_PIN_AN));
}

/// Reads ADC value and converts to voltage in volts
float read_pyro_voltage() {
    return (5.0f / 1024) * analogRead(VPYRO_PIN_AN);
}

/// Callback function used by the TimeLib library
time_t noSync() {
    return 0;       // No sync, but we need this to set the status
}

// Buzzer timer ISR routine
ISR(TIMER2_OVF_vect)        // Called every 8 ms
{
	static uint16_t phase;

    // Short, fast beeps = FIX INVALID
    // Longer, rarer beeps = FIX VALID
    uint16_t period = status.fixValid ? (3 * 125) : (1 * 125);
    uint16_t pwm_on = status.fixValid ? (0.6 * 125) : (0.2 * 125);

	phase++;
	if (phase >= period) {
		phase = 0;
		digitalWrite(BUZZER_PIN, HIGH);
	}
    else {
        if (phase > pwm_on) {
            digitalWrite(BUZZER_PIN, LOW);
        }
    }
}
