kgoba/zinoo/(commit log)

2016-05-24 Added humidity sensor
2016-06-04 Switched to branch tracking
2016-06-05 Multiple new I2C sensors
2016-06-09 Initial mag/acc sensor commit
2016-06-10 Magnetometer updates
2016-10-14 Add FSK, add GPS, add sensors
2016-10-15 New fixed point features
    [main.cpp]
2016-10-22 Added buzzer error code signal
    [main.cpp]
2017-03-16 2017.03.16. 13:58 add voltage
2017-08-10 Moved checksum calculation to ground station
2017-08-12 Added Habhub upload script, added GPS to Lora ground station
2017-08-13 Added temperature sensor
2017-08-13 Switched to TinyGPS++
2017-08-31 Fixes in Habitat upload script (listener reporting)
    [habhub-upload.py]
2018-01-04 Added eagle files
    [mosfet_shield.brd, mosfet_shield.sch, motor_shield.brd, motor_shield.sch, relay_shield.brd, relay_shield.sch, relay_shield2.brd, relay_shield2.sch]
2018-01-05 Added Raspberry camera scripts
2018-01-20 Added pyro sensing and uBlox MAX support
    [tracker-25mm-full.brd, tracker-25mm-full.sch]
2018-01-25 Stability fixes and configuration options
    [Client.ino, Status.cpp, Status.h, config.h]
2018-01-25 Added balloon/ground boards
    [tracker-balloon-full.brd, tracker-balloon-full.sch, tracker-ground-v1.sch]
2018-01-25 Added antenna rotator (initial code)
2018-01-30 Added ADC reading
2018-02-07 Added UPLINK indication, bumped TX power to 23 dBm
2018-02-09 Updates to tracker
    [mosfet_shield.brd, mosfet_shield.sch, tracker-25mm-full.brd, tracker-25mm-full.sch, tracker-balloon-full.sch, tracker-uno-v1.brd, tracker-uno-v1.sch]
2018-02-09 Updates to balloon flight board
    [tracker-balloon-full.brd, tracker-balloon-full.sch]
2018-02-11 Tracker ready for order
    [tracker-25mm-full.brd, tracker-25mm-full.sch, tracker-25mm.brd, tracker-25mm.sch, tracker-balloon-full.brd, tracker-balloon-full.sch]
2018-02-20 Added flight computer for 28mm
    [flight-28mm.brd, flight-28mm.sch]
2018-02-20 Updated balloon board
    [tracker-balloon-full.brd, tracker-balloon-full.sch]
2018-02-21 Updated ground board
    [tracker-balloon-full-sq.brd, tracker-balloon-full-sq.sch, tracker-ground-v1.brd, tracker-ground-v1.sch]
2018-02-21 Added production-ready ground station
    [tracker-ground-v1-180221.brd, tracker-ground-v1-180221.sch]
2018-02-22 Updated ground station production board
    [tracker-ground-v1-180221.brd, tracker-ground-v1-180221.sch, tracker-ground-v1.brd, tracker-ground-v1.sch]
2018-02-22 Added standalone GSM tracker
    [tracker-balloon-full.brd, tracker-gsm.brd, tracker-gsm.sch]
2018-02-25 Updates in ground tracker (TODO)
    [tracker-ground-v1.brd, tracker-ground-v1.sch, tracker-gsm.brd]
2018-02-26 Ground station updates
    [tracker-ground-v1_1.brd, tracker-ground-v1_1.sch]
2018-03-05 Changes to LoRa tracker
    [flight-28mm.brd, flight-28mm.sch, tracker-25mm-full.brd, tracker-25mm-full.sch, tracker-ground-v1_1.brd, tracker-ground-v1_1.sch]
2018-03-13 Minor update
    [tracker-25mm-full.brd, tracker-25mm-full.sch]
2018-03-13 Added BOM
    [tracker-25mm-full.ods]
2018-03-26 Added tinysky STM32 initial code
2018-03-26 Added stm32 template lib
2018-03-26 Fixed a critical bug in PCB
    [tracker-25mm-full.brd, tracker-25mm-full.dxf, tracker-25mm-full.sch]
2018-04-02 Massive updates (I2C working, uBlox commands, etc)
2018-04-10 Task scheduler, LittleFS, SPI flash and code refactor
2018-04-10 Updates for v1.01
    [tracker-25mm-full.brd, tracker-25mm-full.sch]
2018-04-21 Updated documentation
    [tracker-25mm-full.brd, tracker-25mm-full.sch]
2018-04-21 Added thermostat project
    [heater-v1.brd, heater-v1.sch, thermostat-v1.brd, thermostat-v1.sch]
2018-04-22 Switched to forked copy of libopencm3 for L0 support
2018-04-22 Switched sky/ground to new LoRa settings
2018-04-22 Added gyro support
2018-04-22 Updated thermostat
    [thermostat-2layer-v1.brd, thermostat-2layer-v1.sch]
2018-04-24 Thermostat updates
    [thermostat-2layer-v1.brd, thermostat-2layer-v1.sch]
2018-09-06 Fixed case-sensitive file name
    [mpl3115.cpp]
