kgoba/zinoo/(notices)

Notices in the files:
habhub-upload.py:
habhub-upload is free software: you can redistribute it and/or modify
it under the terms of the GNU General Public License as published by
the Free Software Foundation, either version 3 of the License, or
(at your option) any later version.
firmware/tiny-sky/src/cdcacm.c:
This library is free software: you can redistribute it and/or modify
it under the terms of the GNU Lesser General Public License as published by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
eagle/tracker/tracker-25mm-full.brd:
(c) 2018 Karlis Goba
parts and their libraries:
microbuilder_v3: This work is placed in the public domain, and may be freely used for commercial and non-commercial work with the following conditions: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
SparkFun-Switches: Licensing: Creative Commons ShareAlike 4.0 International - https://creativecommons.org/licenses/by-sa/4.0
